gallicchio/OWLternatingCurrent/docs/images/art_base_bottom.png

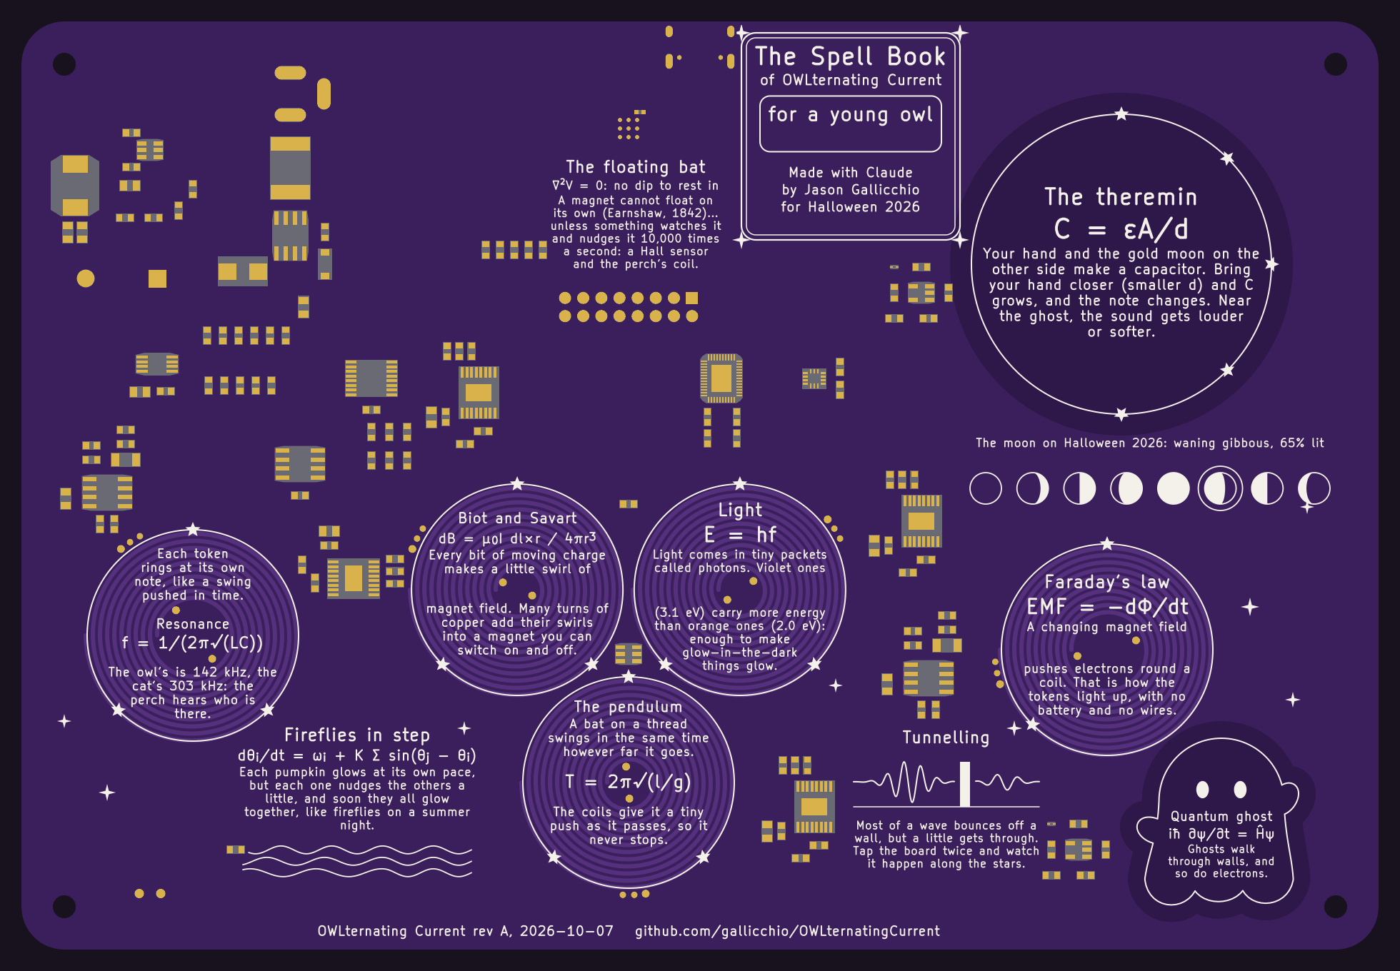
docs/images/art_base_bottom.png
