gallicchio/OWLternatingCurrent/docs/images/art_base_top.png

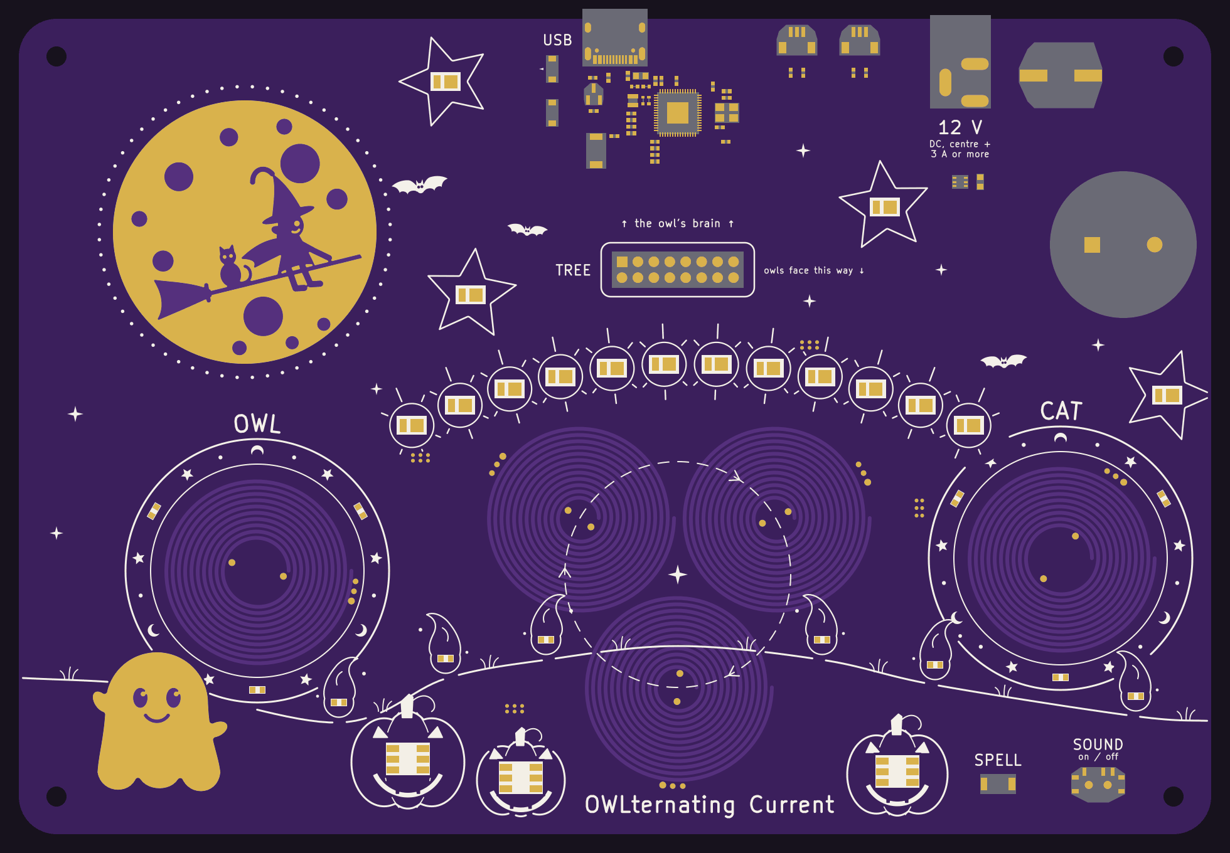
docs/images/art_base_top.png
