gallicchio/OWLternatingCurrent/docs/images/art_bat_bottom.png

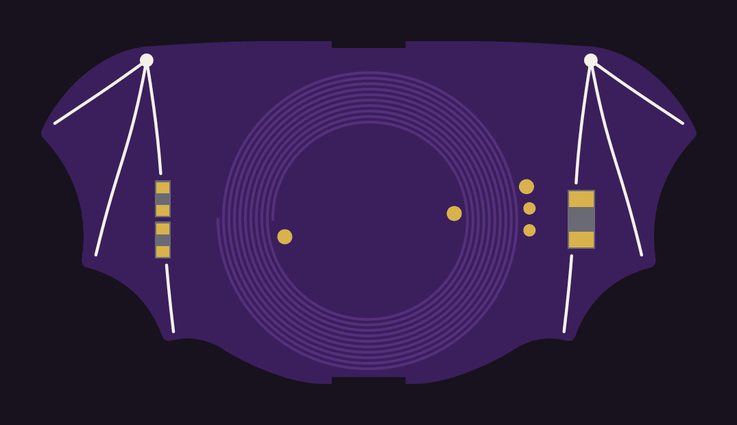
docs/images/art_bat_bottom.png
