gallicchio/OWLternatingCurrent/docs/images/art_bat_top.png

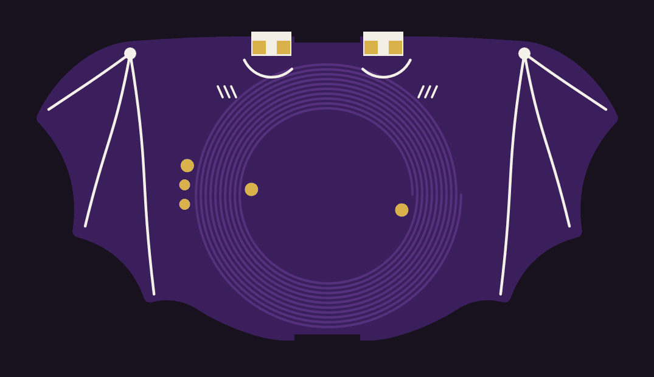
docs/images/art_bat_top.png
