gallicchio/OWLternatingCurrent/docs/images/art_cat_token_bottom.png

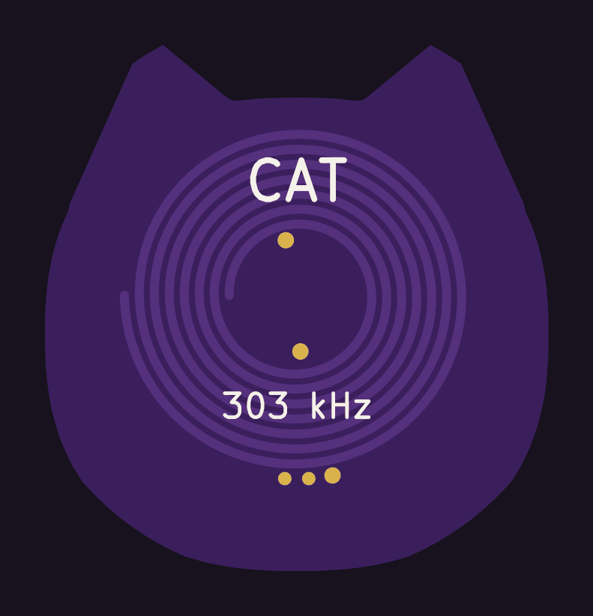
docs/images/art_cat_token_bottom.png
