gallicchio/OWLternatingCurrent/docs/images/art_cat_token_top.png

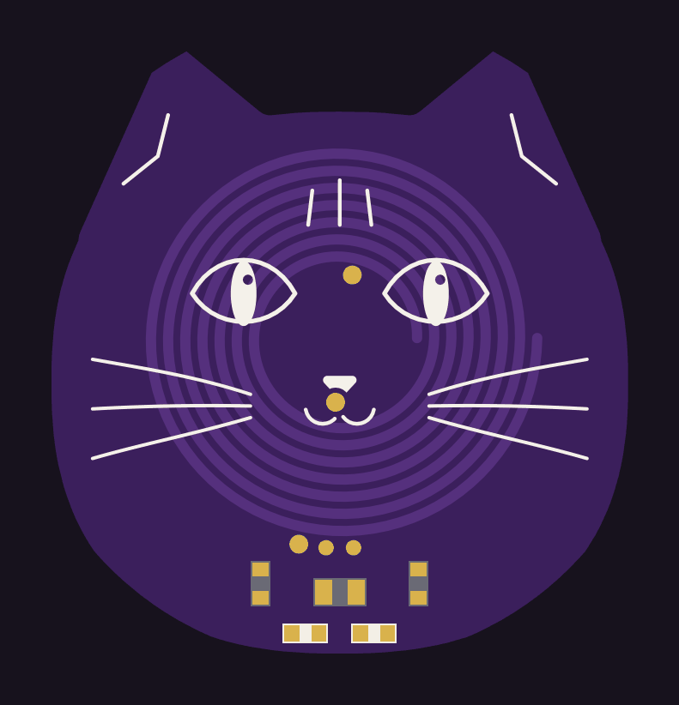
docs/images/art_cat_token_top.png
