gallicchio/OWLternatingCurrent/docs/images/art_owl_token_bottom.png

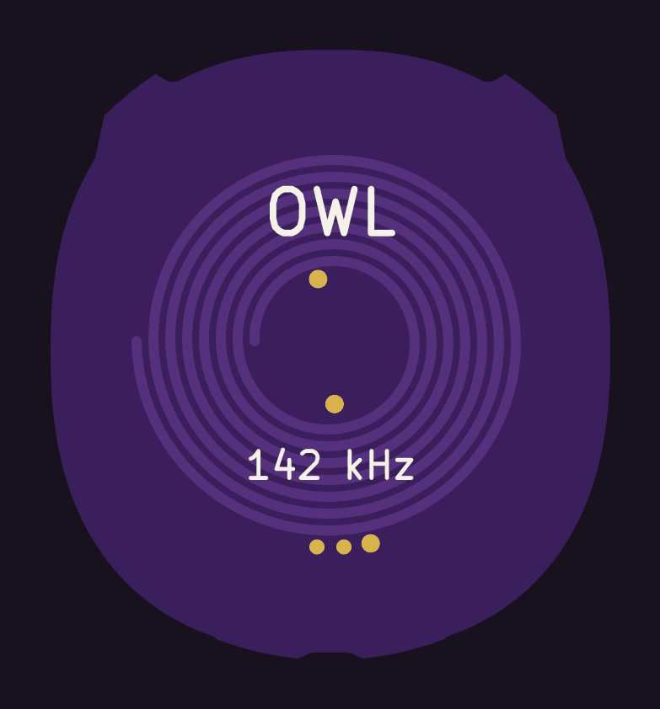
docs/images/art_owl_token_bottom.png
