gallicchio/OWLternatingCurrent/docs/images/art_owl_token_top.png

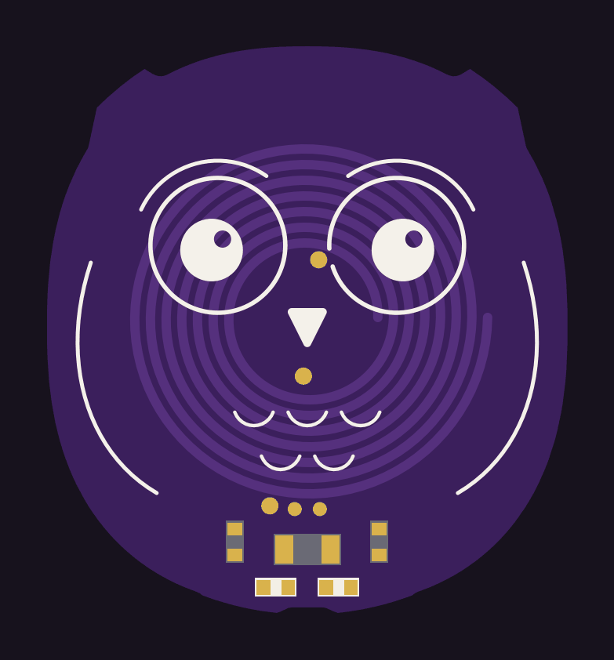
docs/images/art_owl_token_top.png
