gallicchio/OWLternatingCurrent/docs/images/art_perch_bottom.png

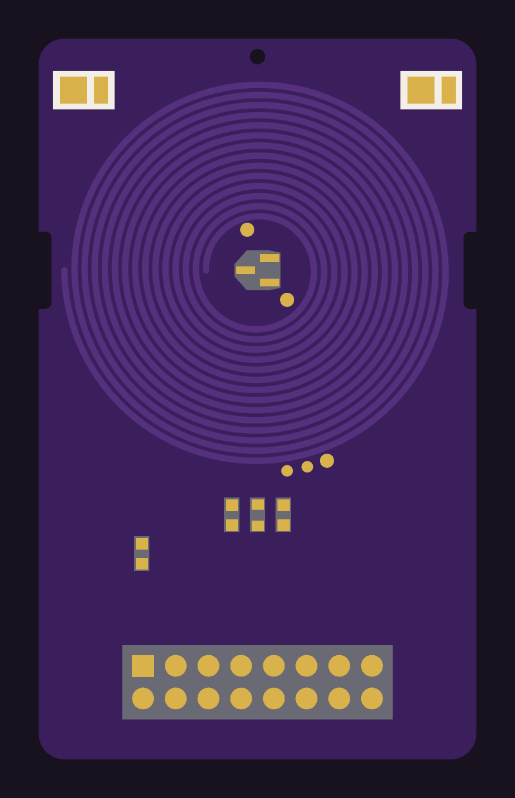
docs/images/art_perch_bottom.png
