gallicchio/OWLternatingCurrent/docs/images/art_perch_top.png

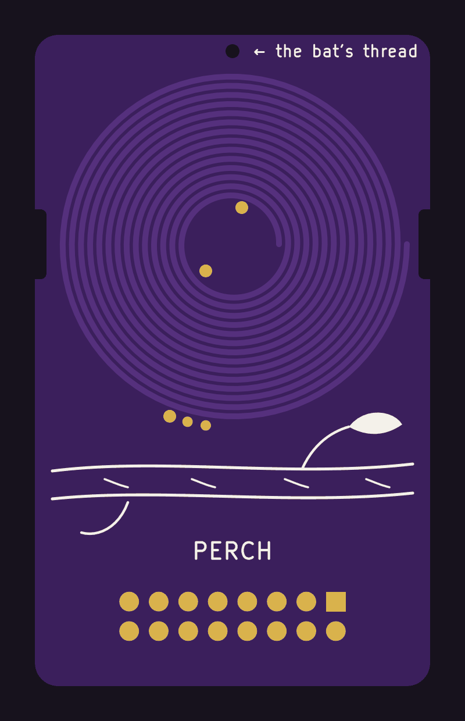
docs/images/art_perch_top.png
