gallicchio/OWLternatingCurrent/docs/images/art_tree_bottom.png

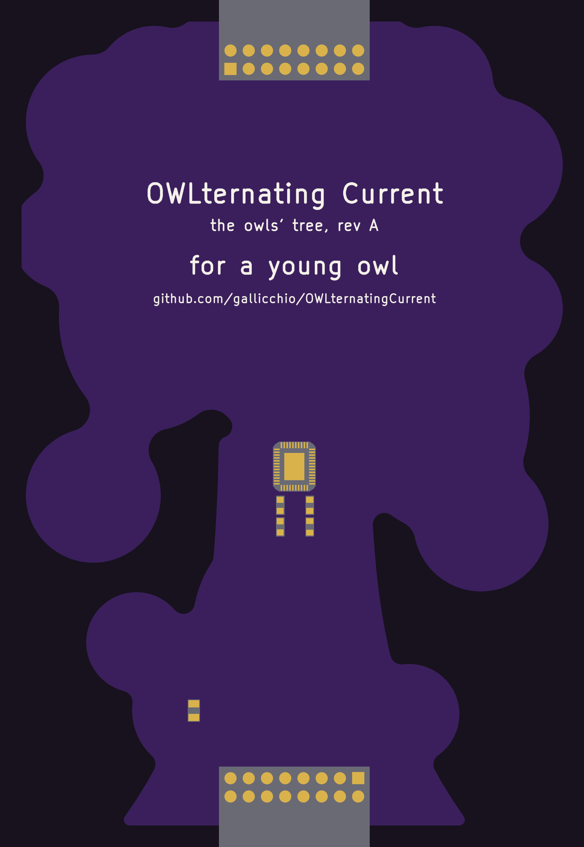
docs/images/art_tree_bottom.png
