gallicchio/OWLternatingCurrent/docs/images/art_tree_top.png

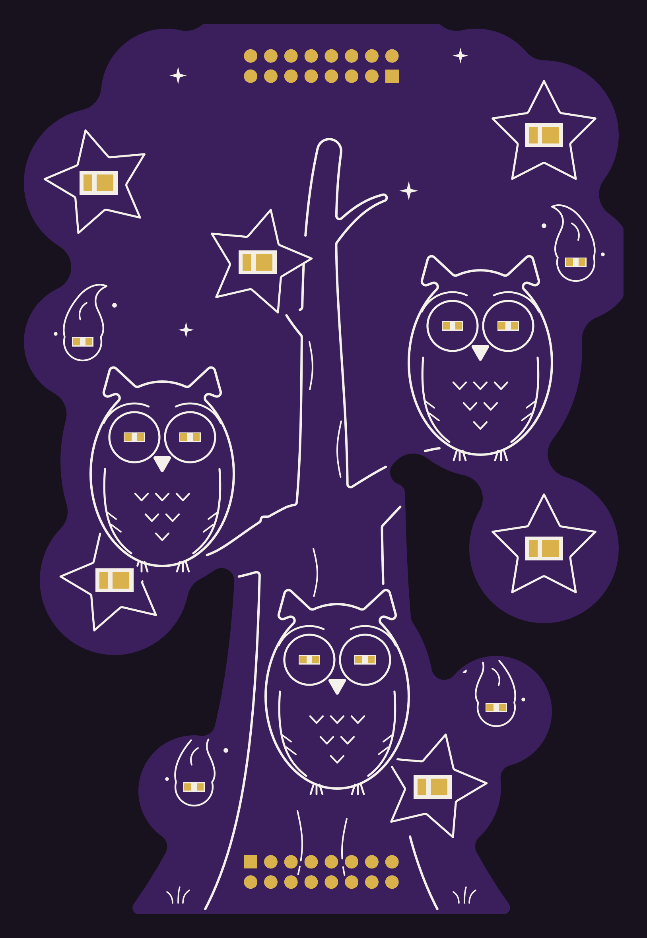
docs/images/art_tree_top.png
