gallicchio/OWLternatingCurrent/mfg/jlcpcb_order/SMT026100964723-13544840A+X-ray+Inspection+Report/13544840A-Y19/1.png

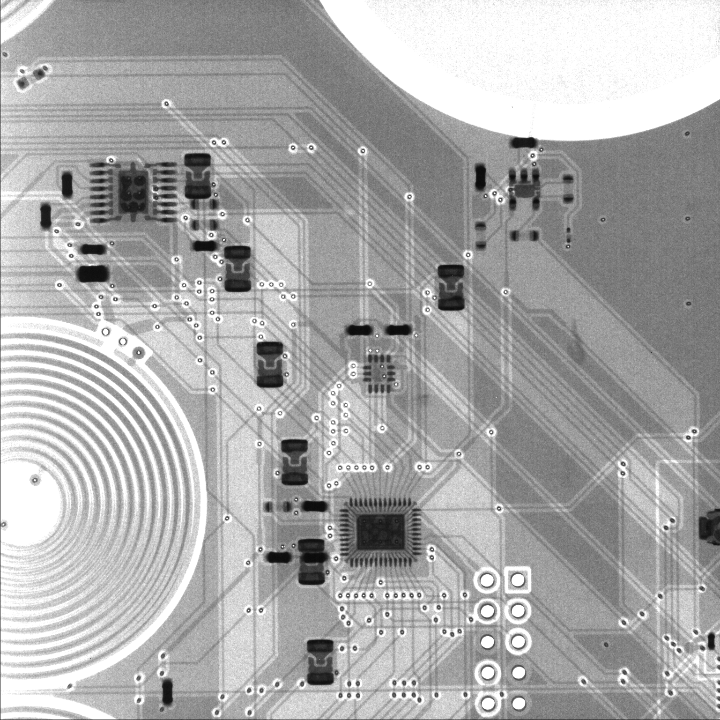
mfg/jlcpcb_order/SMT026100964723-13544840A+X-ray+Inspection+Report/13544840A-Y19/1.png
