gallicchio/OWLternatingCurrent/sim/antenna/figs/geom_bat_dipole.png

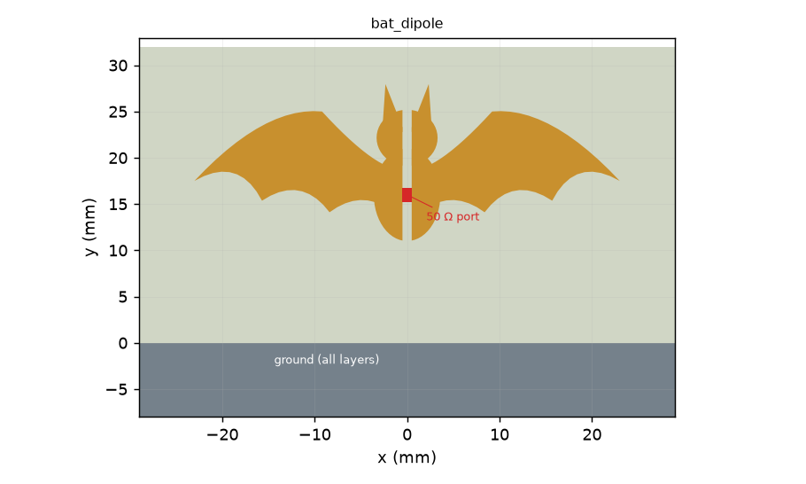
sim/antenna/figs/geom_bat_dipole.png
