gallicchio/OWLternatingCurrent/sim/antenna/figs/geom_bat_ifa.png

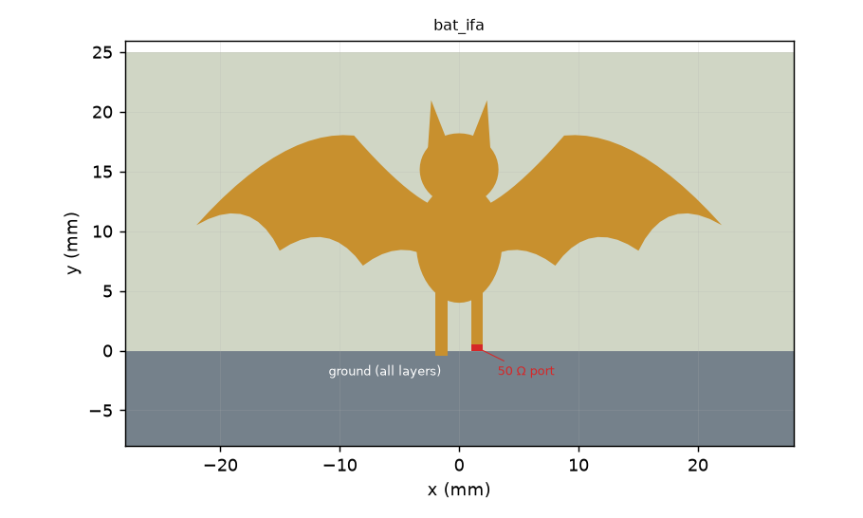
sim/antenna/figs/geom_bat_ifa.png
