gallicchio/OWLternatingCurrent/sim/antenna/figs/geom_bat_legfed.png

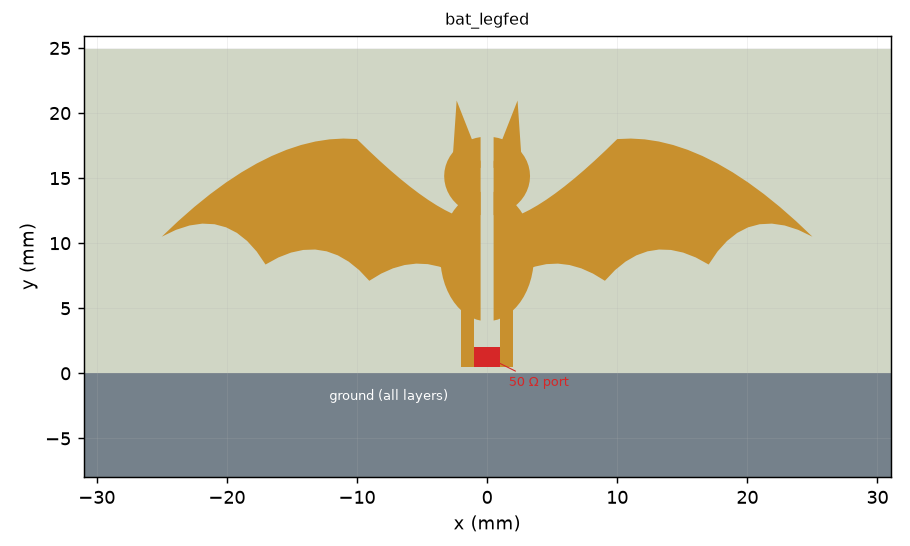
sim/antenna/figs/geom_bat_legfed.png
