gallicchio/OWLternatingCurrent/sim/antenna/figs/geom_bat_pm.png

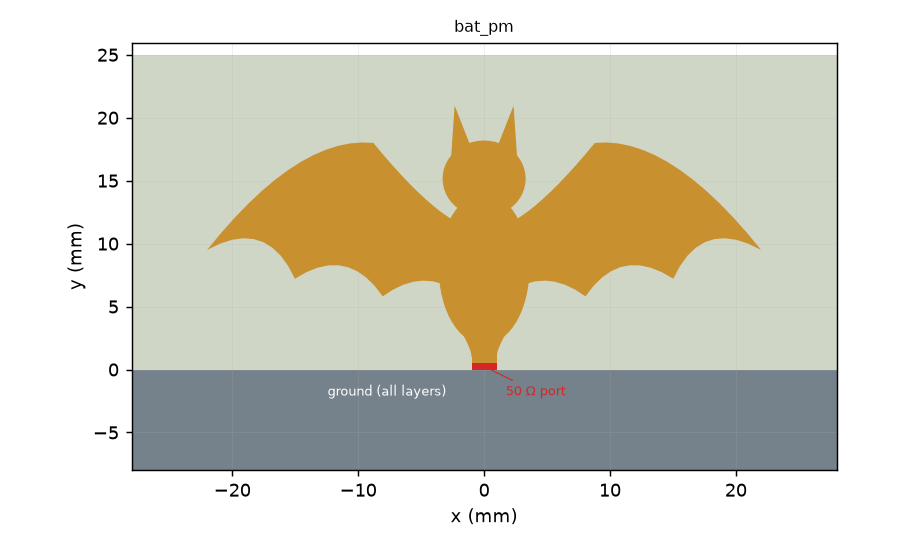
sim/antenna/figs/geom_bat_pm.png
