gallicchio/OWLternatingCurrent/sim/antenna/figs/geom_dn007.png

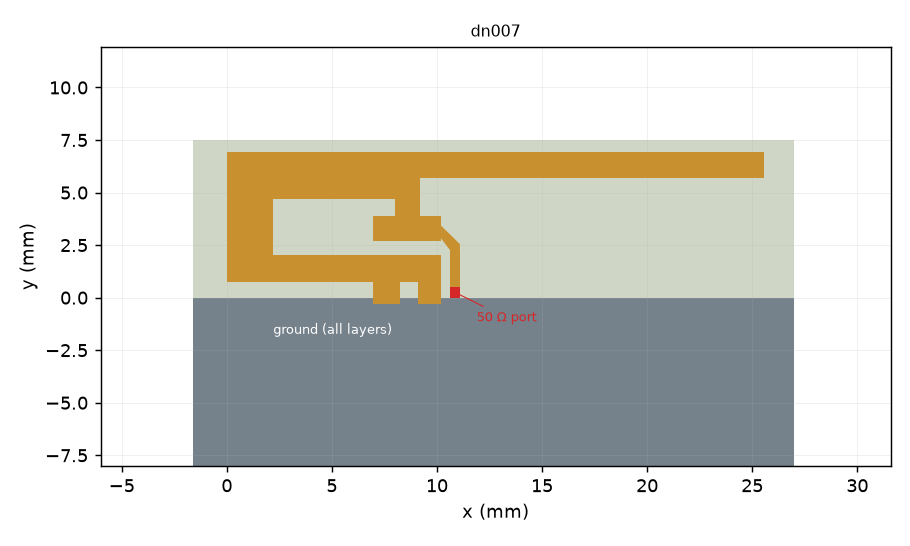
sim/antenna/figs/geom_dn007.png
