gallicchio/OWLternatingCurrent/sim/antenna/figs/pec_bat_ifa.png

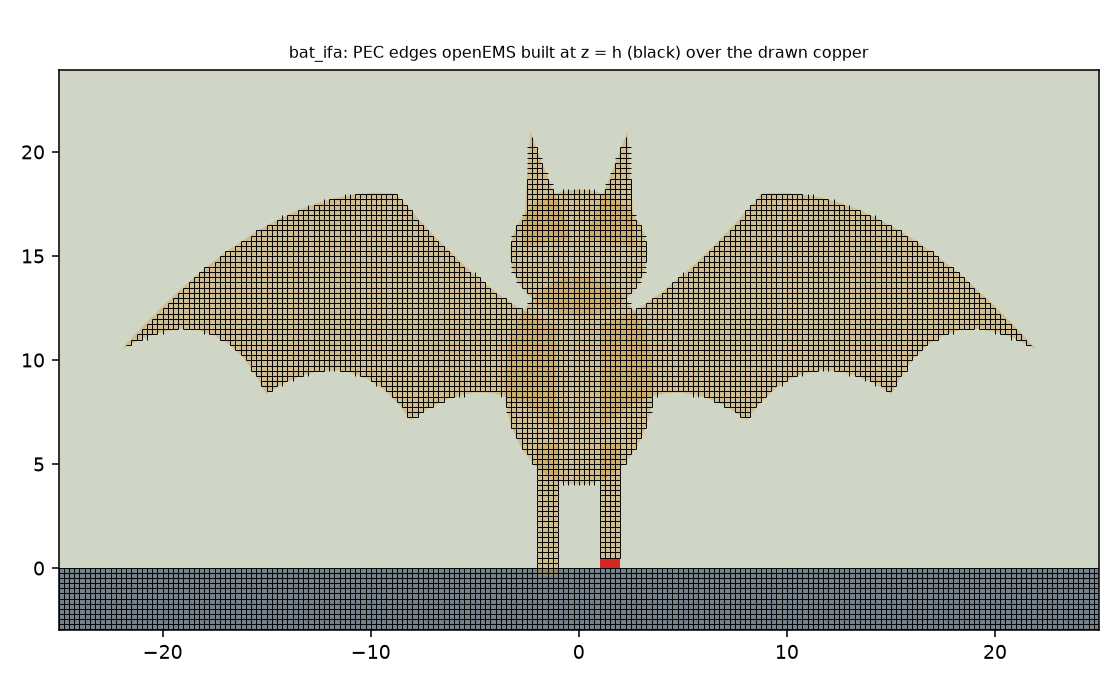
sim/antenna/figs/pec_bat_ifa.png
