gallicchio/OWLternatingCurrent/sim/antenna/figs/pec_bat_legfed.png

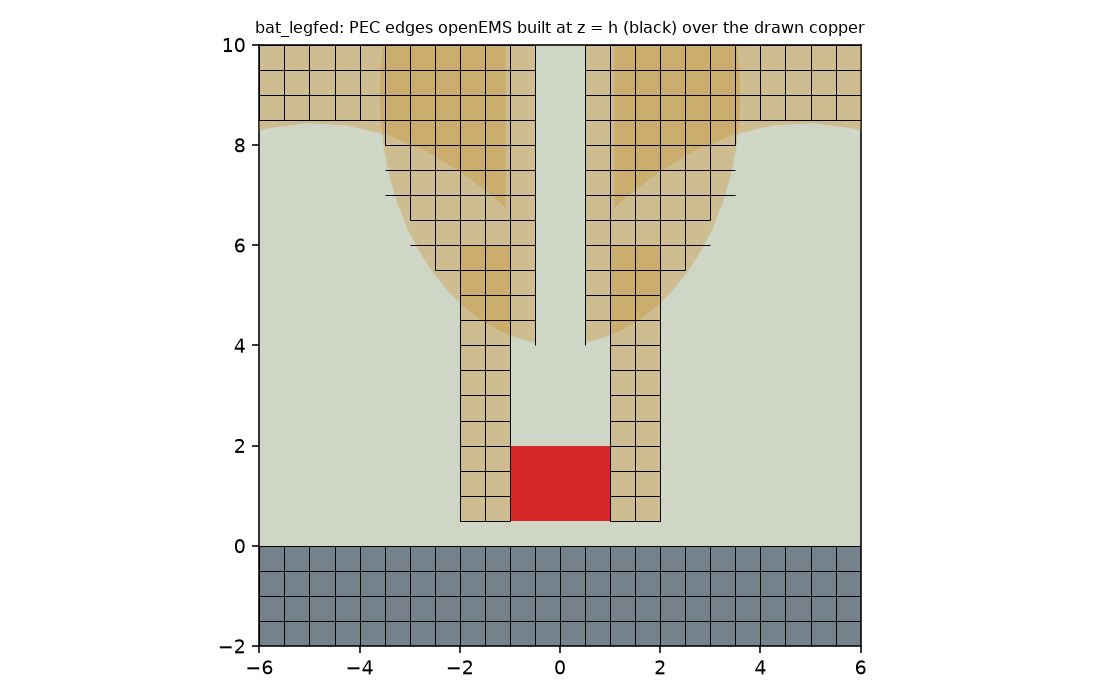
sim/antenna/figs/pec_bat_legfed.png
