gallicchio/OWLternatingCurrent/sim/antenna/figs/pec_dn007.png

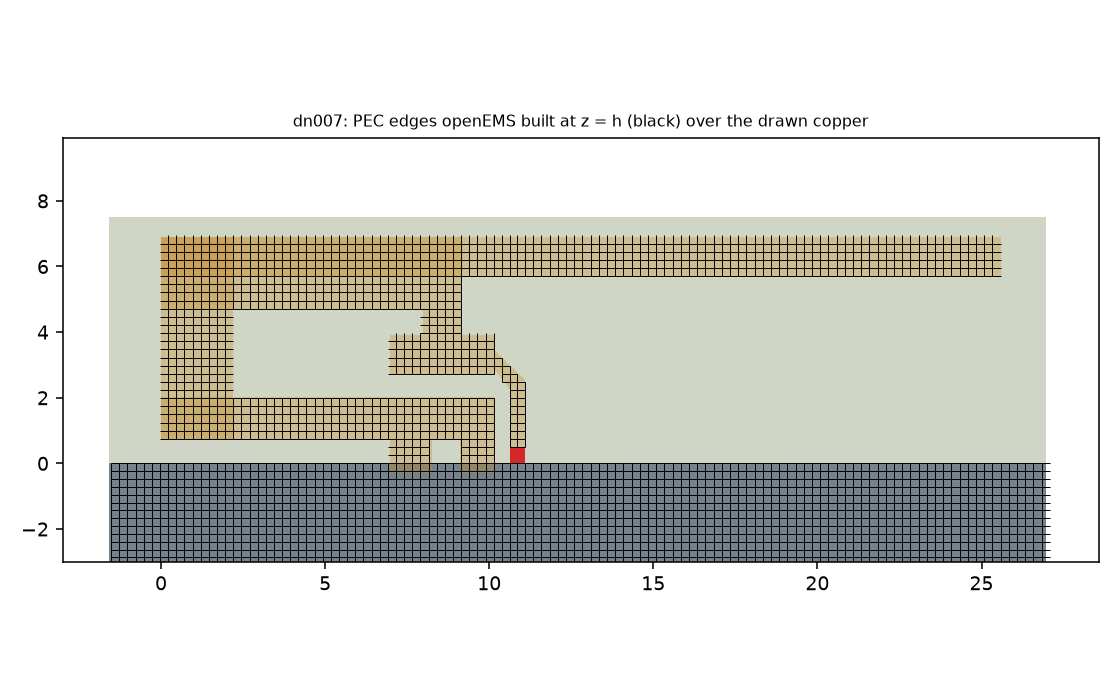
sim/antenna/figs/pec_dn007.png
