gallicchio/OWLternatingCurrent/sim/antenna/figs/pec_ghost.png

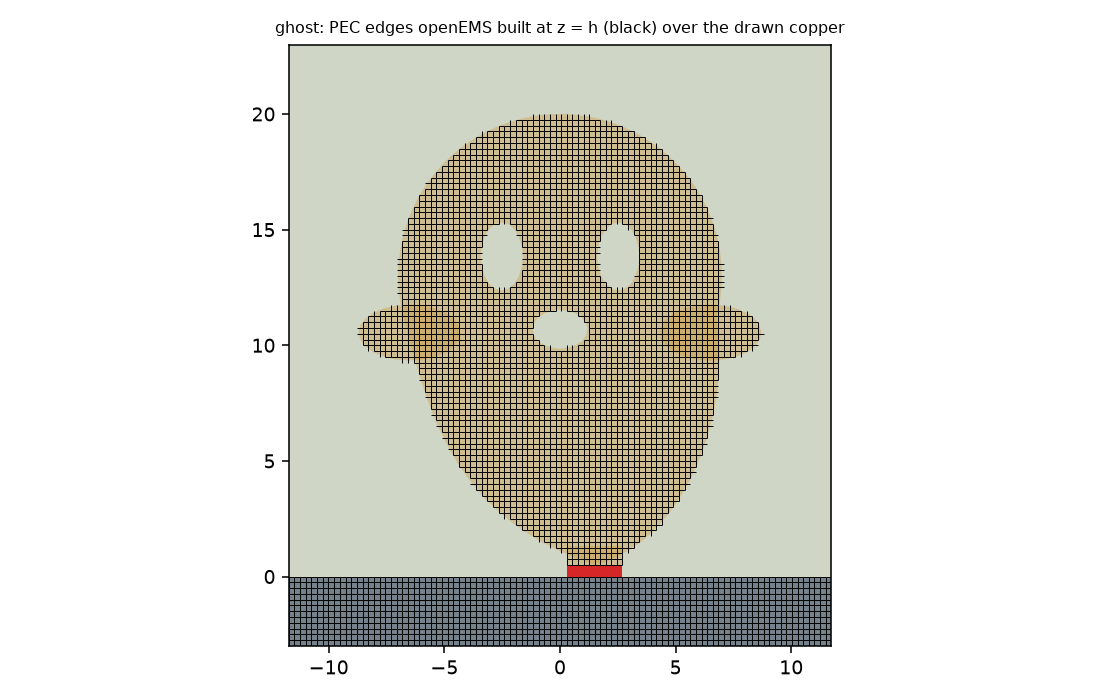
sim/antenna/figs/pec_ghost.png
