gallicchio/OWLternatingCurrent/mfg/release/COST_ESTIMATE.md

# OWLternating Current rev A: cost estimate

Written by `mfg/make_release.py` on 2026-10-09.  Parts: JLCPCB's live prices and stock (their parts API, asked at the times in the table).  Assembly fees: JLCPCB's published list (jlcpcb.com/help/article/pcb-assembly-price, updated 2026-09-09).  The bare panels: an estimate with a range.

**The order:** 5 bare panels of 245.2 x 223.2 mm (547 cm2; all 6 boards on each), 4 layers, 1.6 mm, purple, ENIG, 1 oz inner copper; **2 of them assembled, on both sides** (Standard PCBA).

| item | how | cost |
|---|---|--:|
| bare panels | ESTIMATE, $44-175: GPiBridge's cart (2026-10-06, 4 layers, ENIG: $24.80 for 5 boards of 60 x 25.5 mm) for the fixed part, plus 2736 cm2 at $70.6-350 per m2 (JLCPCB's published 4-layer board charge, and five times it for a small order), plus up to $6 for each of the 5 further designs and $25 for 1 oz inner copper (neither is published); purple costs the same as green (JLCPCB) | $109.31 |
| assembly setup | Standard PCBA, both sides | $51.12 |
| stencils | one for each side | $16.42 |
| feeder loading | 68 distinct parts (BOM lines) x $1.53: Standard PCBA loads a feeder for every part, Basic and Extended alike | $104.04 |
| SMD joints | 808 pads a panel x 2 panels x $0.0016 | $2.59 |
| through-hole | $3.58 labour an order + 25 joints a panel x 2 x $0.0164 | $4.40 |
| panel of 6 designs | JLCPCB's fee for a panel with more than one design | $8.21 |
| packing | $0.50 + $0.00003 per cm2 | $0.53 |
| parts | 245 placements a panel on 68 BOM lines, for 2 panels with JLCPCB's attrition, at the price break for that quantity | $59.36 |
| **total before shipping and duty** | | **$355.98** |
| an assembled panel | the total over 2 | $177.99 |

The range on the bare panels moves the total from $290.25 to $421.70.  US duty, collected by JLCPCB under DDP at 35 % of the PCBs and the assembly (their tariff FAQ, 2026-09-09), adds about $124.59; shipping (UPS Express Saver DDP to California) is shown at checkout.

## Per-part fees: Basic, Preferred, Extended

| library | distinct parts | placements a panel |
|---|--:|--:|
| Basic | 31 | 148 |
| Preferred | 2 | 2 |
| **Extended** | **35** | 95 |

On Standard PCBA every distinct part costs the same $1.53 to load, Basic or Extended (Preferred parts are exempt only on Economic): $104.04.  On Economic PCBA, which purple 4-layer boards cannot have, the 35 Extended parts alone would cost $107.45 and Basic and Preferred nothing.  4 part(s) sit on both sides (C1525, C15849, C97946, C516136); if JLCPCB loads them once a side, add $6.12.

The 35 distinct Extended parts: C138021 (RC0402FR-0727RL), C160389 (BM03B-SRSS-TB(LF)(SN)), C160472 (LTST-S270KFKT), C165948 (TYPE-C-31-M-12), C167223 (FXL0630-100-M), C173431 (BZT52C10), C1855818 (DRV8874PWPR), C189961 (NS4150B), C20625731 (ABM8-272-T3), C266123 (DRV5055A4QDBZR), C2841482 (AO4407A), C2897409 (PM254-2-08-Z-8.5), C2977527 (BSMD2920-300-24V), C311983 (TPS54302DDCR), C364577 (LTR-303ALS-01), C3715882 (TMAG5273A2QDBVR), C381116 (DC-005-5A-2.0), C38732 (OPA2333AIDR), C41378174 (RP2354A), C42411119 (AOTA-B201610S3R3-101-T), C431540 (MSK12C02), C46550472 (MA35V470M10X13), C465729 (UCC27524DR), C516136 (HL-A-3528S7VC-S1-13HL), C516304 (HL-AF-5060S22OC-3-S1-THL), C51933300 (GL0603PU01), C530531 (GSPK2307P-8R1W), C5645 (74HC4051PW,118), C701961 (LP5036RJVR), C77069 (GRM21B5C1H223JA01L), C7835 (SN74LVC1G14DBVR), C82326 (ESD9L5.0ST5G), C965800 (XL-1608UOC-06), C967633 (LSM6DS3TR-C), C97946 (GRM31C5C1H104JA01L).

## What to look at

- The bare panels are the least certain line ($43.58 to $175.04): read the price off JLCPCB's cart and put it in `PCB_QUOTE` in `mfg/make_release.py`
- Feeder loading is the largest assembly fee: $104.04 for 68 distinct parts.  Each part dropped or merged into another value saves $1.53
- **C42411119 AOTA-B201610S3R3-101-T** costs $9.06 for the order (32 x $0.28)
- **C1855818 DRV8874PWPR** costs $8.07 for the order (8 x $1.01)
- **C701961 LP5036RJVR** costs $5.09 for the order (4 x $1.27)
- **C967633 LSM6DS3TR-C** costs $3.03 for the order (2 x $1.52)
- **C516136 HL-A-3528S7VC-S1-13HL** costs $2.88 for the order (52 x $0.06)
- **C41378174 RP2354A** costs $2.55 for the order (2 x $1.28)
- Not in the total: baking the moisture-sensitive parts before assembly (JLCPCB recommends it for MSL 3 and up, as the LGA-14 accelerometer is; about $7.50), shipping, and duty

## Parts (68 BOM lines)

| LCSC | part | per panel | ordered | library | unit | line | stock | left after | asked |
|---|---|--:|--:|---|--:|--:|--:|--:|---|
| C42411119 | AOTA-B201610S3R3-101-T (3.3uH) | 1 | 32 | Extended | $0.2830 | $9.06 | 347 | 315 | 2026-10-08 21:05 |
| C1855818 | DRV8874PWPR (DRV8874) | 4 | 8 | Extended | $1.0082 | $8.07 | 27,586 | 27,578 | 2026-10-08 21:06 |
| C701961 | LP5036RJVR (LP5036) | 2 | 4 | Extended | $1.2733 | $5.09 | 16,757 | 16,753 | 2026-10-08 21:06 |
| C967633 | LSM6DS3TR-C (LSM6DS3TR-C) | 1 | 2 | Extended | $1.5156 | $3.03 | 27,676 | 27,674 | 2026-10-08 21:06 |
| C516136 | HL-A-3528S7VC-S1-13HL (violet) | 24 | 52 | Extended | $0.0553 | $2.88 | 68,094 | 68,042 | 2026-10-08 21:05 |
| C41378174 | RP2354A (RP2354A) | 1 | 2 | Extended | $1.2765 | $2.55 | 15,998 | 15,996 | 2026-10-08 21:06 |
| C15850 | CL21A106KAYNNNE (10u 25V) | 10 | 30 | Basic | $0.0687 | $2.06 | 4,577,372 | 4,577,342 | 2026-10-08 21:04 |
| C530531 | GSPK2307P-8R1W (8R 1W) | 1 | 2 | Extended | $0.9009 | $1.80 | 4,897 | 4,895 | 2026-10-08 21:05 |
| C38732 | OPA2333AIDR (OPA2333) | 1 | 2 | Extended | $0.7529 | $1.51 | 19,024 | 19,022 | 2026-10-08 21:06 |
| C465729 | UCC27524DR (UCC27524) | 2 | 4 | Extended | $0.3610 | $1.44 | 32,059 | 32,055 | 2026-10-08 21:06 |
| C266123 | DRV5055A4QDBZR (DRV5055A4) | 1 | 2 | Extended | $0.6944 | $1.39 | 8,734 | 8,732 | 2026-10-08 21:06 |
| C20625731 | ABM8-272-T3 (12MHz) | 1 | 2 | Extended | $0.6196 | $1.24 | 9,889 | 9,887 | 2026-10-08 21:06 |
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

"ordered" is what JLCPCB charges for: the placements on 2 panels plus its attrition (`lossNumber`) or minimum purchase, at the price break for that quantity.  A Preferred part is an Extended part JLCPCB keeps on its machines.
