gallicchio/OWLternatingCurrent/mfg/release/OWLternatingCurrent_bom.csv

Comment | Designator | Footprint | LCSC
100n | C4,C5,C35,C37,C40,C42,C43,C45,C47,C48,C52,C53,C57,C58,C62,C63,C66,C68,C70,C71,C73,C75,C102,C202 | C_0603_1608Metric | C14663
violet | D13,D15,D16,D17,D19,D20,D21,D22,D23,D24,D25,D26,D27,D29,D36,D37,D103,D107,D108,D109,D113,D115,D201,D202 | LED_Everlight-SMD3528_3.5x2.8mm_67-21ST | C516136
purple | D9,D10,D11,D12,D14,D18,D28,D30,D31,D33,D34,D35,D102,D106,D112,D114,D402,D502 | LED_0603_1608Metric | C51933300
100n | C13,C14,C15,C16,C17,C18,C19,C20,C21,C22,C23,C24 | C_0402_1005Metric | C1525
1k | R17,R18,R19,R26,R29,R36,R38,R40,R42,R53,R57,R201 | R_0603_1608Metric | C21190
1u | C33,C34,C39,C41,C44,C67,C72,C101,C103,C203 | C_0603_1608Metric | C15849
10u 25V | C2,C3,C32,C49,C54,C59,C64,C69,C74,C104 | C_0805_2012Metric | C15850
100k | R1,R2,R22,R25,R28,R47,R52,R56 | R_0603_1608Metric | C25803
10k | R23,R34,R43,R44,R45,R46,R51,R55 | R_0603_1608Metric | C25804
orange | D101,D104,D105,D110,D111,D116,D401,D501 | LED_0603_1608Metric | C965800
10n | C29,C30,C50,C55,C60,C65,C201 | C_0603_1608Metric | C57112
22n | C28,C31,C46,C51,C56,C61 | C_0603_1608Metric | C21122
2.2k | R30,R31,R35,R37,R39,R41 | R_0603_1608Metric | C4190
DRV8874 | U5,U6,U7,U8 | HTSSOP-16-1EP_4.4x5mm_P0.65mm_EP3.55x2.46mm_TI_PWP0016J | C1855818
150 | R401,R402,R501,R502 | R_0603_1608Metric | C22808
33 | R24,R27,R301,R302 | R_0603_1608Metric | C23140
100 | R12,R13,R15,R16 | R_0402_1005Metric | C25076
4.7u | C10,C11,C12 | C_0402_RPi | C23733
orange x3 | D7,D8,D32 | LED_RGB_5050-6 | C516304
1k | R11,R14 | R_0402_1005Metric | C11702
27 | R7,R8 | R_0402_1005Metric | C138021
15p | C26,C27 | C_0402_1005Metric | C1548
SWD/UART | J4,J5 | JST_SH_BM03B-SRSS-TB_1x03-1MP_P1.00mm_Vertical | C160389
orange | D301,D302 | LED_LiteOn_LTST-S270_SideView | C160472
15p | C36,C38 | C_0603_1608Metric | C1644
220k | R20,R21 | R_0603_1608Metric | C22961
3.3k | R32,R101 | R_0603_1608Metric | C22978
4.7k | R33,R49 | R_0603_1608Metric | C23162
0.1 | R50,R54 | R_1206_3216Metric | C25334
5.1k | R9,R10 | R_0402_1005Metric | C25905
22k | R3,R48 | R_0603_1608Metric | C31850
22u 25V | C6,C7 | C_0805_2012Metric | C45783
UCC27524 | U9,U10 | SOIC-8_3.9x4.9mm_P1.27mm | C465729
1u | C8,C9 | C_0402_1005Metric | C52923
LP5036 | U3,U101 | VQFN-46-1EP_5x6mm_P0.4mm_EP2.8x3.8mm | C701961
BOOT/SPELL | SW1,SW2 | SW_SPST_TS-1088-xR020 | C720477
74LVC1G14 | U12,U13 | SOT-23-5 | C7835
ESD 0.9pF | D5,D6 | D_SOD-923 | C82326
B5819W | D3,D4 | D_SOD-123 | C8598
100n C0G | C301,C401 | C_1206_3216Metric | C97946
USB-C | J2 | USB_C_Receptacle_HRO_TYPE-C-31-M-12 | C165948
10uH | L1 | L_Changjiang_FXL0630 | C167223
BZT52C10 | D1 | D_SOD-123 | C173431
NS4150B | U14 | MSOP-8_3x3mm_P0.65mm | C189961
SMBJ15A | D2 | D_SMB | C19077569
10u | C25 | C_0603_1608Metric | C19702
12MHz | Y1 | Crystal_SMD_3225-4Pin_3.2x2.5mm | C20625731
36k | R4 | R_0603_1608Metric | C23147
5.1k | R5 | R_0603_1608Metric | C23186
33 | R6 | R_0402_RPi | C25105
DRV5055A4 | U201 | SOT-23 | C266123
AO4407A | Q1 | SOIC-8_3.9x4.9mm_P1.27mm | C2841482
TREE | J3 | PinSocket_2x08_P2.54mm_Vertical | C2897409
3A PTC | F1 | Fuse_2920_7451Metric | C2977527
TPS54302 | U1 | SOT-23-6 | C311983
LTR-303ALS | U16 | Lite-On_LTR-303ALS-01 | C364577
TMAG5273A2 | U17 | SOT-23-6 | C3715882
12V DC | J1 | BarrelJack_XKB_DC-005-5A-2.0_Horizontal | C381116
OPA2333 | U18 | SOIC-8_3.9x4.9mm_P1.27mm | C38732
RP2354A | U4 | RP2350A_QFN-60_7x7mm_P0.4mm_RPi | C41378174
3.3uH | L2 | L_Abracon_AOTA-B201610_RPi | C42411119
SOUND | SW3 | SW_SPDT_Shouhan_MSK12C02 | C431540
470u 35V | C1 | CP_Elec_10x12.6 | C46550472
8R 1W | LS1 | Speaker_GSPK2307P_D23mm_P10mm | C530531
XC6206 3.3V | U2 | SOT-23 | C5446
74HC4051 | U11 | TSSOP-16_4.4x5mm_P0.65mm | C5645
22n C0G | C501 | C_0805_2012Metric | C77069
LSM6DS3TR-C | U15 | Bosch_LGA-14_3x2.5mm_P0.5mm | C967633
