gallicchio/OWLternatingCurrent/mfg/jlcpcb_order/2026-10-23_question_about_LS1.png

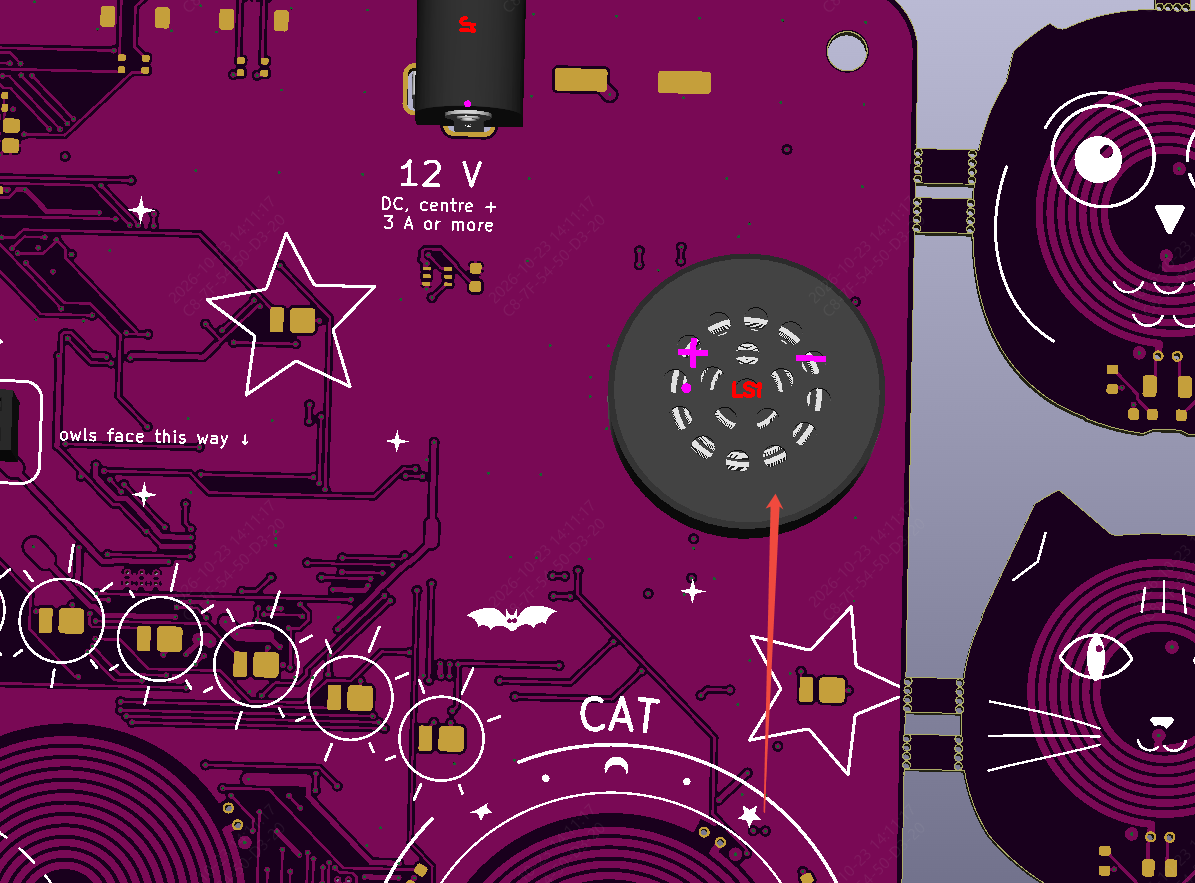
mfg/jlcpcb_order/2026-10-23_question_about_LS1.png
