gallicchio/OWLternatingCurrent/mfg/jlcpcb_order/8801425903117524992-Produce_DanZhi.SMT_Snapshot.Top.13544840A_Y19.SMT026100964723.png

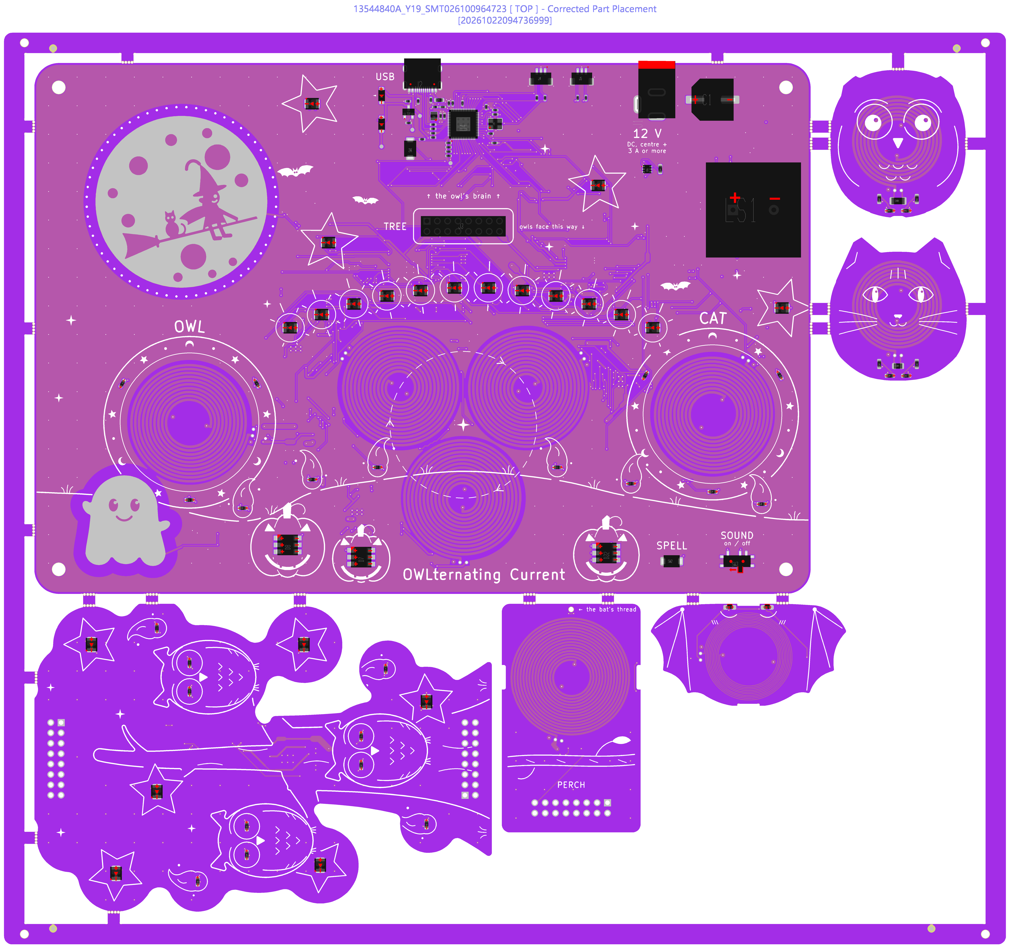
mfg/jlcpcb_order/8801425903117524992-Produce_DanZhi.SMT_Snapshot.Top.13544840A_Y19.SMT026100964723.png
