gallicchio/OWLternatingCurrent/mfg/jlcpcb_order/8801425905845313536-Produce_DanZhi.SMT_Snapshot.Bottom.13544840A_Y19.SMT026100964723.png

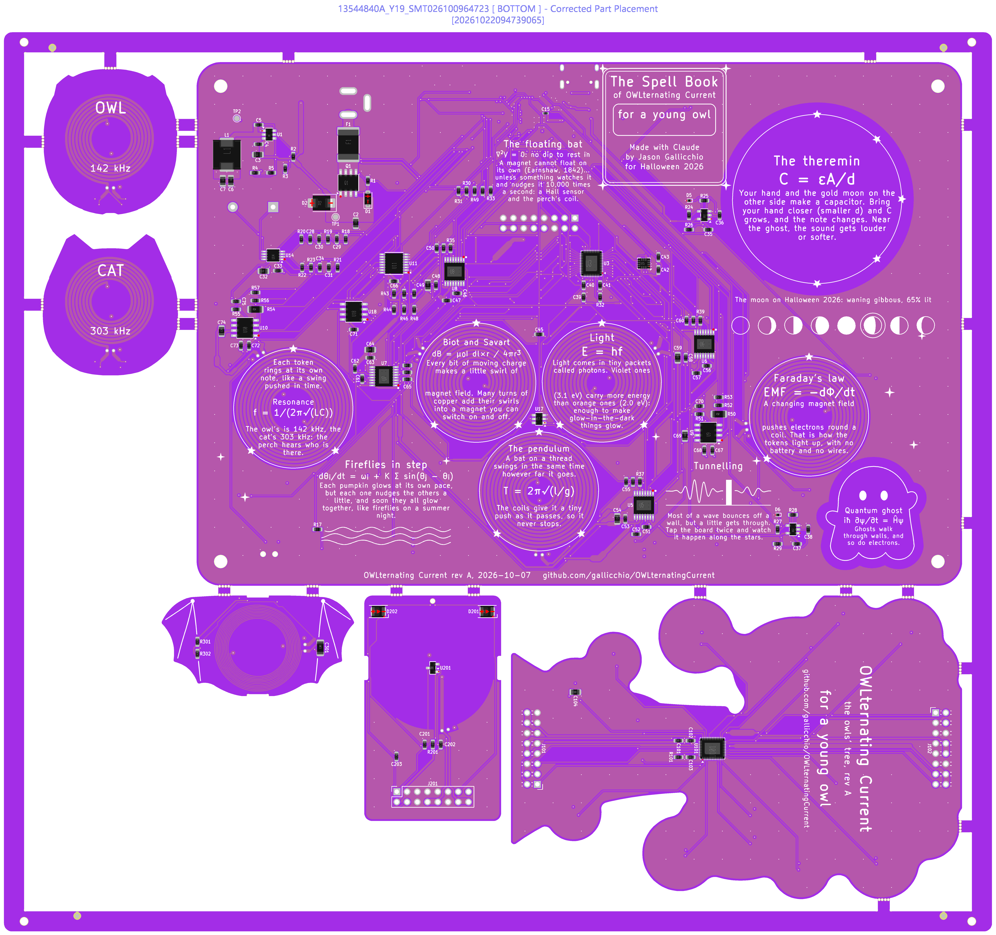
mfg/jlcpcb_order/8801425905845313536-Produce_DanZhi.SMT_Snapshot.Bottom.13544840A_Y19.SMT026100964723.png
