gallicchio/OWLternatingCurrent/mfg/jlcpcb_order/potos_revA_2026-11-06/20261106_082548.jpg

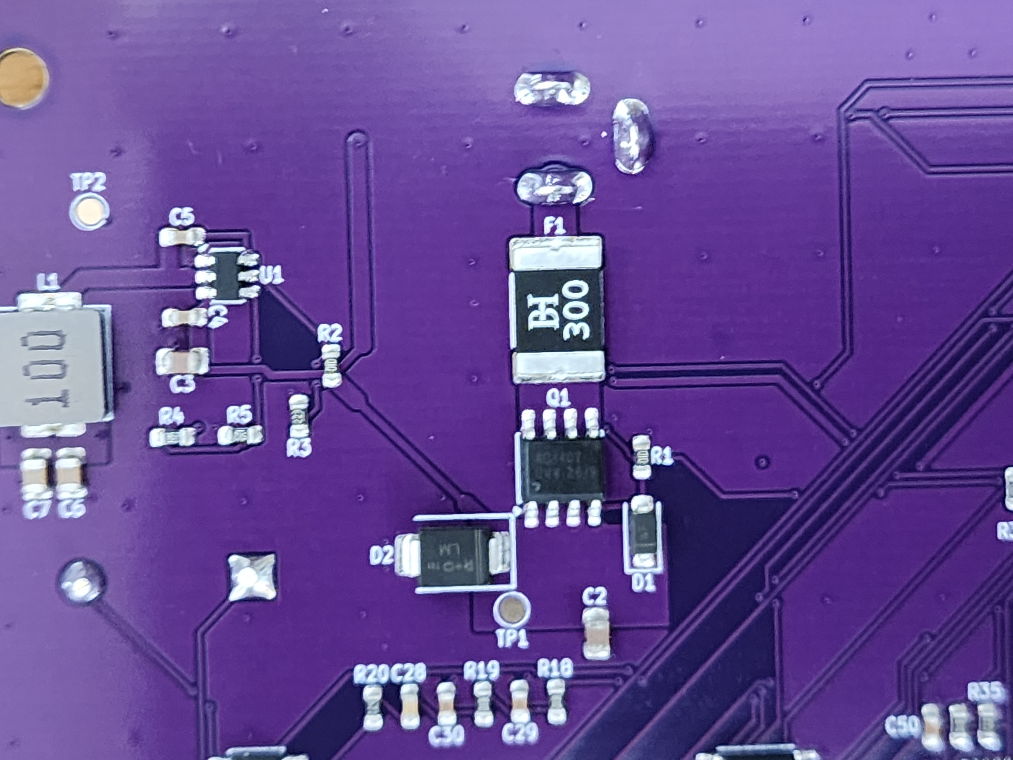
mfg/jlcpcb_order/potos_revA_2026-11-06/20261106_082548.jpg
