gallicchio/OWLternatingCurrent/gen/models/QFN-60-1EP_7x7mm_P0.4mm.step

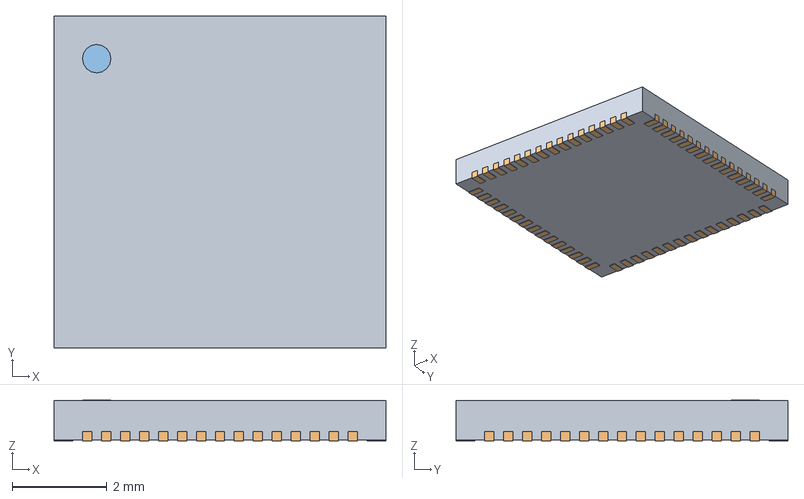
[picture p86: CAD file, 2026-10-07]
gen/models/QFN-60-1EP_7x7mm_P0.4mm.step
7.00 x 7.00 x 0.86 mm
