gallicchio/OWLternatingCurrent/print/out/assembled/owl_in_perch_frame.stl

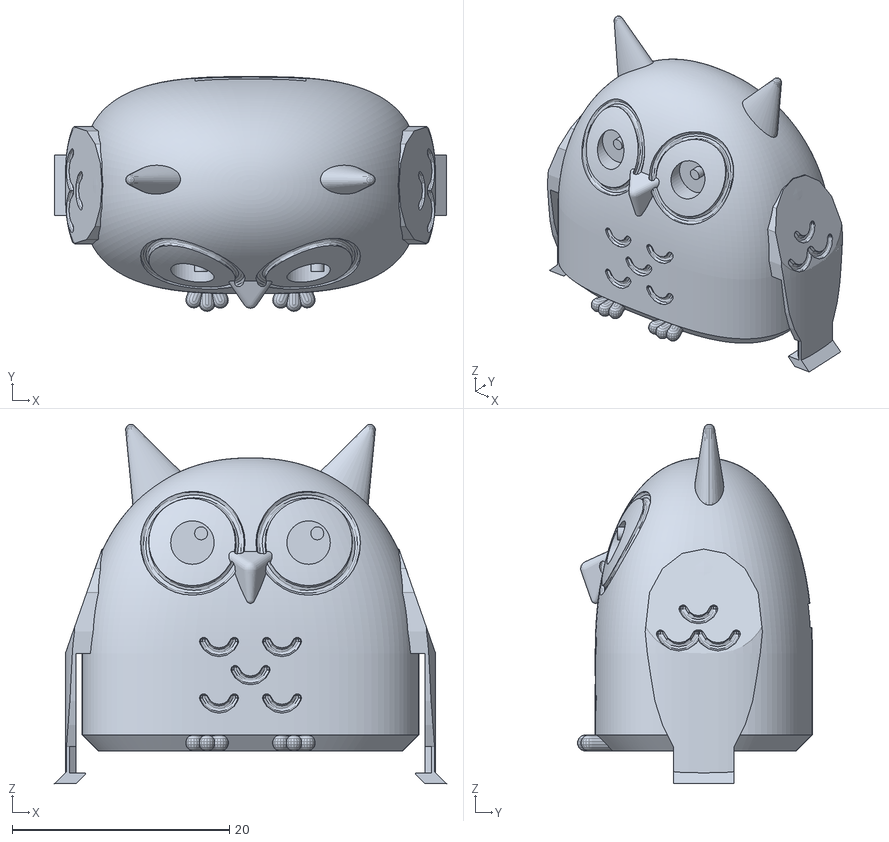
[picture p87: CAD file, 2026-11-11]
print/out/assembled/owl_in_perch_frame.stl
36.1 x 21.6 x 33.1
