gallicchio/OWLternatingCurrent/print/out/bat_cap.stl

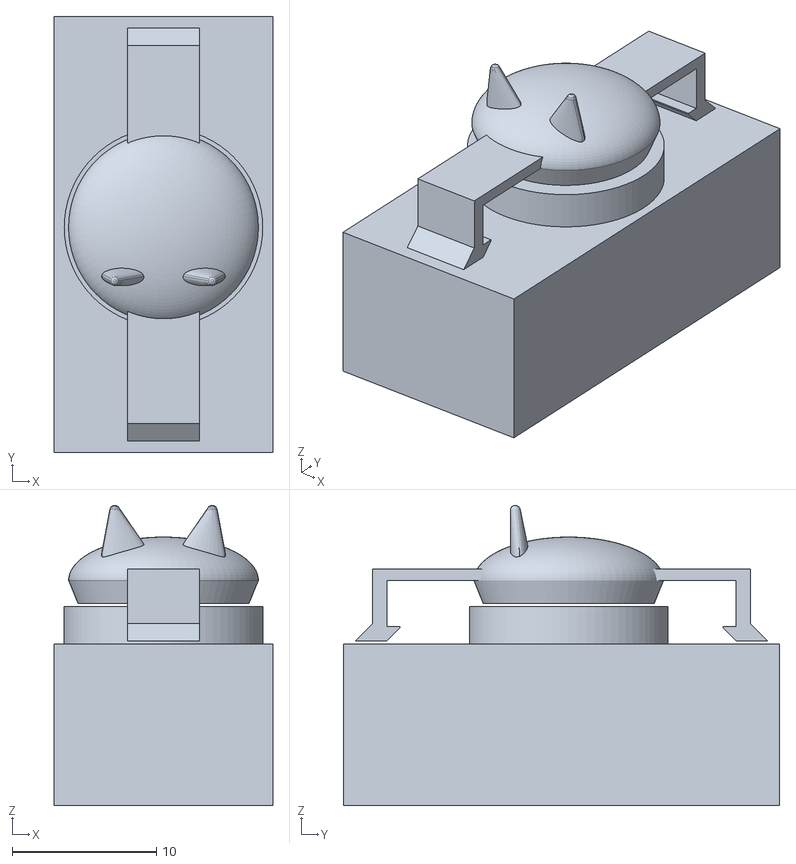
[picture p88: CAD file, 2026-11-11]
print/out/bat_cap.stl
15.1 x 30.2 x 20.8
