gallicchio/OWLternatingCurrent/gen/models/L_Abracon_AOTA-B201610.step

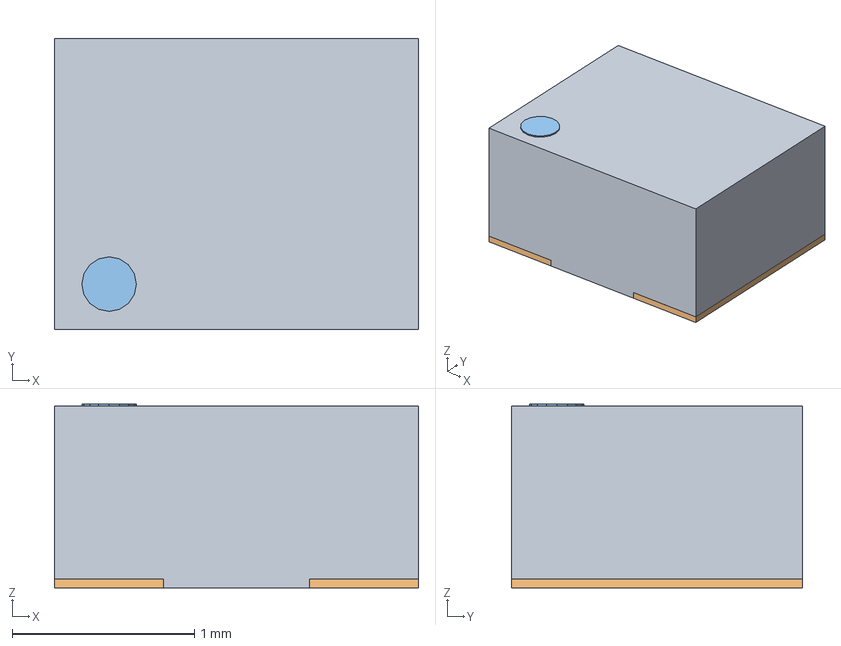
[picture p89: CAD file, 2026-10-07]
gen/models/L_Abracon_AOTA-B201610.step
2.00 x 1.60 x 1.01 mm
