gallicchio/OWLternatingCurrent/print/out/assembled/bat_cap_in_bat_frame.stl

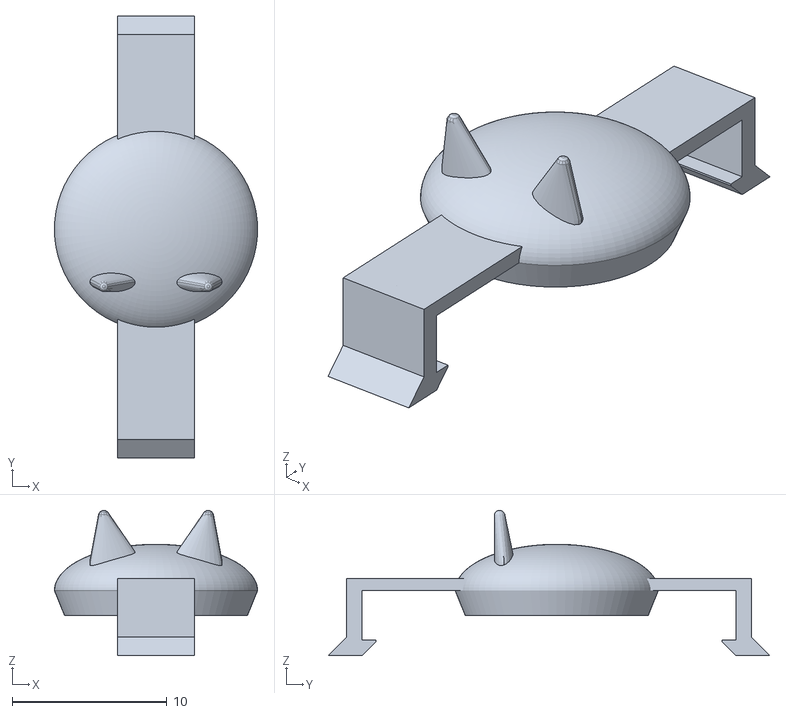
[picture p90: CAD file, 2026-11-10]
print/out/assembled/bat_cap_in_bat_frame.stl
13.1 x 28.6 x 9.39
