gallicchio/OWLternatingCurrent/print/out/owl.stl

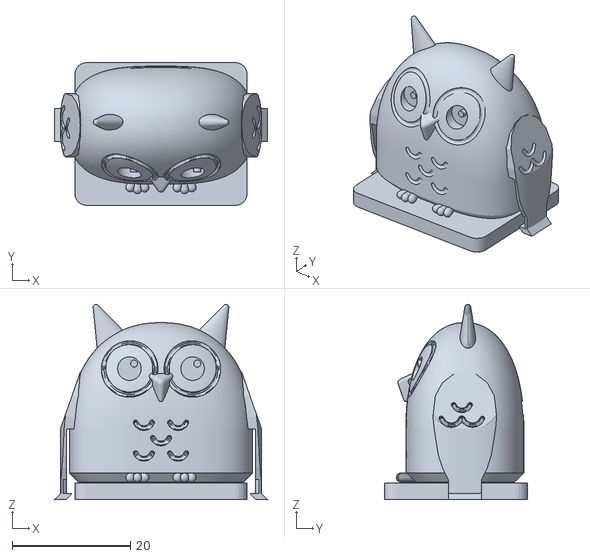
[picture p91: CAD file, 2026-11-11]
print/out/owl.stl
36.1 x 24.2 x 33.1
