gallicchio/OWLternatingCurrent/gen/models/USB_C_Receptacle_HRO_TYPE-C-31-M-12.step

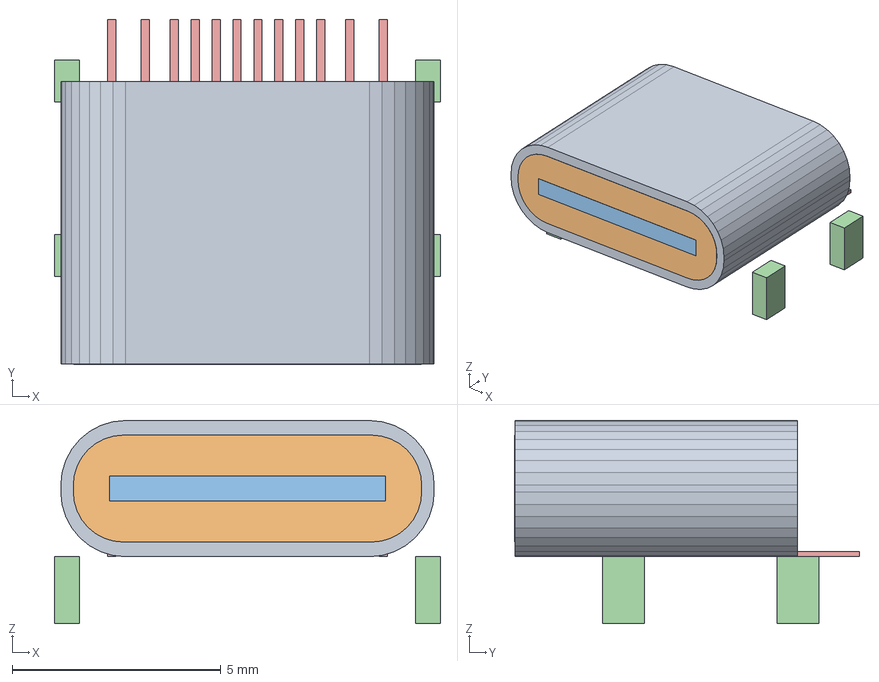
[picture p92: CAD file, 2026-10-07]
gen/models/USB_C_Receptacle_HRO_TYPE-C-31-M-12.step
9.24 x 8.26 x 4.86 mm
