gallicchio/OWLternatingCurrent/print/out/plate.stl

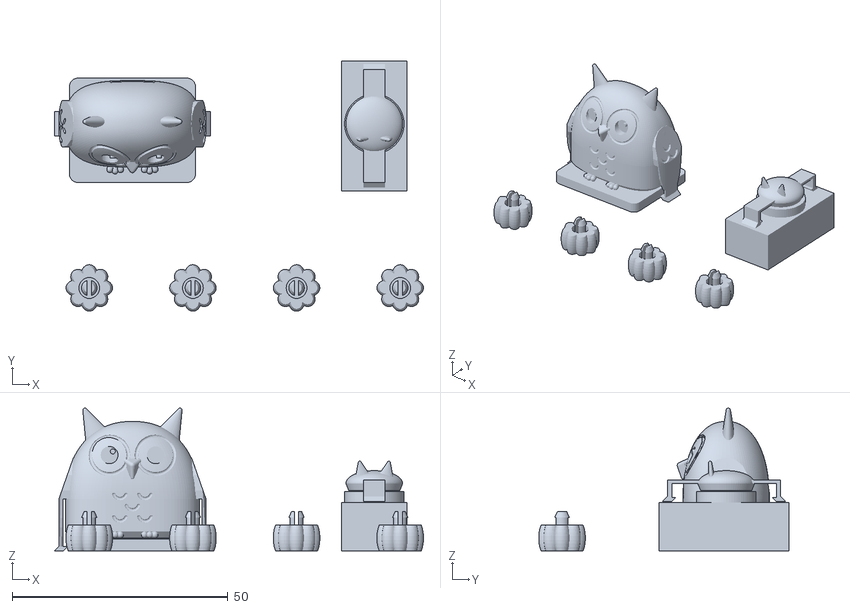
[picture p93: CAD file, 2026-11-11]
print/out/plate.stl
85.4 x 58.0 x 33.1
