gallicchio/OWLternatingCurrent/print/out/foot.stl

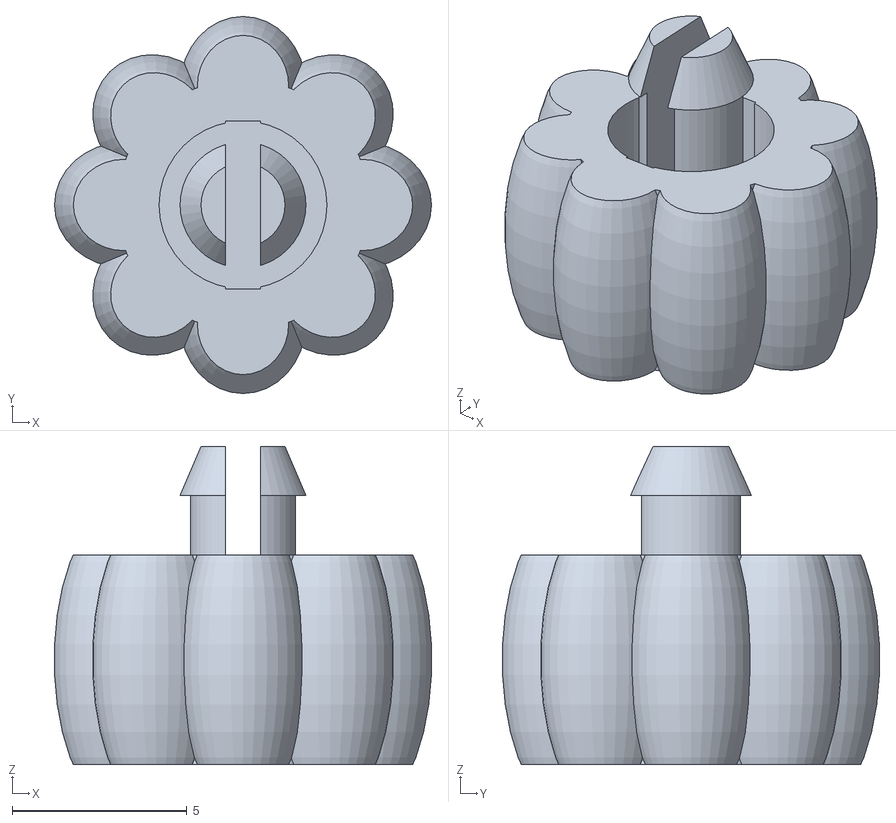
[picture p94: CAD file, 2026-10-07]
print/out/foot.stl
10.8 x 10.8 x 9.10
