gallicchio/OWLternatingCurrent/print/out/params.scad

// Generated by print/build.py from gen/mech.py and print/design.py: do not edit.
// gen/mech.py (prefix M_):
M_BAT_HEAD_Y = -12.5;
M_BAT_NOTCH_D = 0.5;
M_BAT_NOTCH_W = 5.4;
M_BAT_SPAN = 48;
M_BAT_TAIL_Y = 11.5;
M_CAP_ARM_W = 5;
M_CAP_HOOK = 0.8;
M_COIL_R_IN = 4;
M_COIL_R_OUT = 15;
M_COIL_TURNS = 14;
M_COPPER_TO_SURFACE = 0.05;
M_FOOT_HEIGHT = 6;
M_FOOT_HOLE_D = 3.2;
M_FOOT_INSET = 6;
M_MAGNET_D = 10;
M_MAGNET_T = 2;
M_OWL_HOOK = 0.8;
M_OWL_KEEPOUT = 2;
M_OWL_LIFT = 11.4;
M_OWL_NOTCH_D = 1;
M_OWL_NOTCH_Y = [-3,3];
M_PCB_T = 1.6;
M_PERCH_BACK = 38;
M_PERCH_FRONT = -18;
M_PERCH_W = 34;
M_POCKET_D = 10.35;
M_POCKET_T = 2.25;
M_RX_R_IN = 7;
M_RX_R_OUT = 11;
M_THREAD_HOLE = [0,-16.6];
M_THREAD_HOLE_D = 1.2;
// print/design.py:
BED = [180,180];
CAP_ARM_RAISE = 1.6;
CAP_ARM_T = 0.8;
CAP_DOME_P = 2;
CAP_DOME_R = 6.575;
CAP_DOME_R0 = 5.925;
CAP_DOME_TOP = 4.6;
CAP_DOME_Z1 = 1.6;
CAP_DROP_CLEAR = 0.1;
CAP_DROP_T = 1;
CAP_FLOOR_T = 0.4;
CAP_FOOT = 1.2;
CAP_HEAD_DROP_IN = -12.6;
CAP_HEAD_LIP_TIP = -11.7;
CAP_HOOK_T = 1;
CAP_LEADIN_LAND = 0.1;
CAP_OPEN_DEPTH = 2.6;
CAP_PED_HALF_X = 7.575;
CAP_PLATEAU_TOP = 13.8;
CAP_PLATFORM_TOP = 11.2;
CAP_SLOT = 1.6;
CAP_TAIL_DROP_IN = 11.6;
CAP_TAIL_LIP_TIP = 10.7;
CAP_Z0 = 14;
CAP_Z_BOTTOM = -2.6;
CAP_Z_CATCH = -1.6;
FOOT_BARB_D = 3.6;
FOOT_BARB_H = 1.4;
FOOT_BARB_TOP_D = 2.4;
FOOT_CATCH_Z = 7.7;
FOOT_CORE_R = 3.6;
FOOT_LOBES = 8;
FOOT_LOBE_R = 2;
FOOT_LOBE_RZ = 4.4;
FOOT_MOAT_DEPTH = 3.5;
FOOT_MOAT_R = 2.4;
FOOT_PEG_D = 3;
FOOT_R = 5.4;
FOOT_SLOT = 1;
GAP_XY = 0.4;
GAP_Z = 0.2;
LAYER = 0.2;
NOZZLE = 0.4;
OPEN_GAP_T = 2.2;
OPEN_KEY_D = 0.8;
OPEN_KEY_W = 1.2;
OPEN_KEY_Y = 7.4;
OPEN_SLOT_END = 11;
OPEN_SLOT_W = 10.25;
OWL_A = 15.5;
OWL_ARM_CHAMFER = 0.6;
OWL_ARM_CLEAR = 0.05;
OWL_ARM_HALF_W = 2.8;
OWL_ARM_IN = 16.05;
OWL_ARM_T = 1;
OWL_B = 10;
OWL_DOME_P = 2.2;
OWL_EYE_R = 4.4;
OWL_EYE_X = 5.35;
OWL_EYE_Z = 19.2;
OWL_FLARE = 1.5;
OWL_FLOOR = 11.4;
OWL_GROOVE_R = 0.4;
OWL_HOOK_T = 1;
OWL_LEADIN_LAND = 0.15;
OWL_LIFT_DESIGNED = 11.45;
OWL_LIP_TIP = 15.2;
OWL_N = 3;
OWL_NOTCH_LEN = 6;
OWL_NOTCH_MID = 0;
OWL_NOTCH_X = 16;
OWL_PUPIL_DEPTH = 1.2;
OWL_PUPIL_R = 2;
OWL_RECESS_A = 11.5;
OWL_RECESS_B = 6;
OWL_RECESS_RIDGE = [5.5,5.5];
OWL_RIM = 2.5;
OWL_ROOT_Z = 9;
OWL_SLAB_HALF_X = 14.6;
OWL_SLAB_TOP = 2.8;
OWL_SLAB_Y = [-13.6,10.6];
OWL_SLOT = 2;
OWL_SLOT_CLEAR = 0.4;
OWL_TALON = 1;
OWL_TOP_Z = 27;
OWL_TUFT_BASE = [7.6,0.5,22.4,3.2];
OWL_TUFT_TIP = [11,0.5,29.6,0.5];
OWL_WING_MEET_Z = 17.6;
OWL_Z0 = 3;
OWL_Z_BOTTOM = -3;
OWL_Z_CATCH = -2;
PAUSE_LAYER = 84;
PAUSE_LAYER_TOP = 16.8;
PAUSE_Z = 16.6;
PLA_DENSITY = 1.24;
PLA_E = 3500;
POCKET_DEPTH = 2.2;
POCKET_FLOOR_Z = 14.4;
POCKET_R = 5.175;
STRAIN_OK = 0.02;
STRAIN_PLA_MAX = 0.03;
WING_RELIEF = 1.55;
PLATE_OWL = [-26,10];
PLATE_BAT_CAP = [30,10];
PLATE_FOOT1 = [-36,-28];
PLATE_FOOT2 = [-12,-28];
PLATE_FOOT3 = [12,-28];
PLATE_FOOT4 = [36,-28];
BAT_Z_FLOATING = -15.22328;   // float gap 11.09 mm (sim/physics)
