gallicchio/OWLternatingCurrent/(list of files, cad)

Other CAD files:
print/out/shapes.scad
