gallicchio/OWLternatingCurrent/sim/antenna/results/dn007_measured_s11_digitized.csv

# f_GHz | S11_dB (digitised from TI SWRU120D Fig. 2-8 | CC2430DB board | 1 mm FR4)
2.0000 | -4.5362
2.0050 | -4.6003
2.0100 | -4.6910
2.0150 | -4.8480
2.0200 | -5.0085
2.0250 | -5.1465
2.0300 | -5.2651
2.0350 | -5.3818
2.0400 | -5.5216
2.0450 | -5.6905
2.0500 | -5.9128
2.0550 | -6.1439
2.0600 | -6.3127
2.0650 | -6.4371
2.0700 | -6.6166
2.0750 | -6.8422
2.0800 | -7.0561
2.0850 | -7.2714
2.0900 | -7.5161
2.0950 | -7.7012
2.1000 | -7.9455
2.1050 | -8.1043
2.1100 | -8.3008
2.1150 | -8.4421
2.1200 | -8.6245
2.1250 | -8.8067
2.1300 | -8.8886
2.1350 | -8.9755
2.1400 | -9.1296
2.1450 | -9.2727
2.1500 | -9.3587
2.1550 | -9.3979
2.1600 | -9.4337
2.1650 | -9.4386
2.1700 | -9.5071
2.1750 | -9.6354
2.1800 | -9.7537
2.1850 | -9.7742
2.1900 | -9.7580
2.1950 | -9.7619
2.2000 | -9.8068
2.2050 | -9.8964
2.2100 | -9.9738
2.2150 | -9.9968
2.2200 | -9.9428
2.2250 | -9.8963
2.2300 | -9.8966
2.2350 | -9.9471
2.2400 | -9.9471
2.2450 | -9.9172
2.2500 | -9.8556
2.2550 | -9.9222
2.2600 | -10.0053
2.2650 | -10.1352
2.2700 | -10.3025
2.2750 | -10.4307
2.2800 | -10.5801
2.2850 | -10.7764
2.2900 | -11.0330
2.2950 | -11.2895
2.3000 | -11.4717
2.3050 | -11.7353
2.3100 | -11.9277
2.3150 | -12.1121
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
