gallicchio/OWLternatingCurrent/sim/antenna/results/validation.csv

case | f_res | r_res | f_min | s11_min | bw_lo | bw_hi | eta | D | cells | t_min
MoM nseg=61 | 2.4349 | 72.4099
MoM nseg=121 | 2.4332 | 72.7669
dipole_fs_r0.125 | 2.4223 | 72.2289 | 2.4040 | -15.1122 | 2.3053 | 2.5149 | 0.9909 | 2.0960 | 3021959 | 26.9223
dipole_fs_r0.25 | 2.4154 | 72.2619 | 2.3960 | -15.1138 | 2.2964 | 2.5091 | 0.9909 | 2.0960 | 900893 | 12.0938
dipole_fs_r0.5 | 2.4014 | 72.2998 | 2.3810 | -15.1241 | 2.2788 | 2.4974 | 0.9903 | 2.0962 | 295519 | 1.8024
dn007_h1.0_g29x60 | 2.7258 | 25.7268 | 2.6970 | -10.1246 | 2.6767 | 2.7175 | 0.9235 | 4.3118 | 1152800 | 14.1796
dn007_h1.0_g29x60_r0.18 | 2.7128 | 25.9093 | 2.6850 | -10.2011 | 2.6592 | 2.7108 | 0.9253 | 4.3112 | 1909908 | 22.8661
dn007_h1.0_g50x80 | 2.3787 | 54.6535 | 2.3820 | -27.1032 | 2.2345 | 2.6114 | 0.9654 | 3.0564 | 1304250 | 14.5166
dn007_h1.6_g29x60 | 2.6068 | 21.3390 | 2.5620 | -8.2690 | nan | nan | 0.8994 | 4.4021 | 1083632 | 13.6496
