gallicchio/OWLternatingCurrent/bringup/results/2026-11-06/161232_ripple_4v8.png

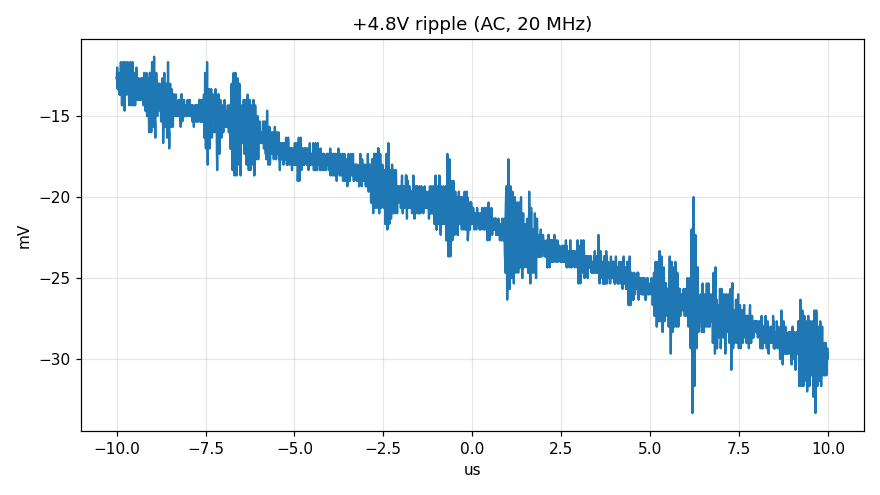
bringup/results/2026-11-06/161232_ripple_4v8.png
