gallicchio/OWLternatingCurrent/bringup/results/2026-11-06/161556_powerup_screen.png

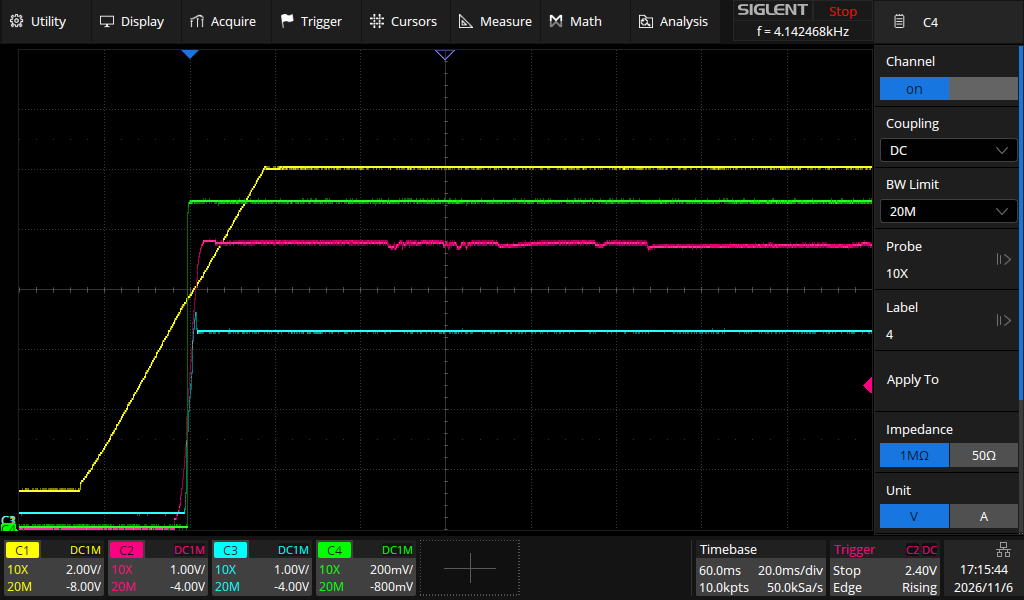
bringup/results/2026-11-06/161556_powerup_screen.png
