gallicchio/OWLternatingCurrent/bringup/results/2026-11-06/163147_perch.png

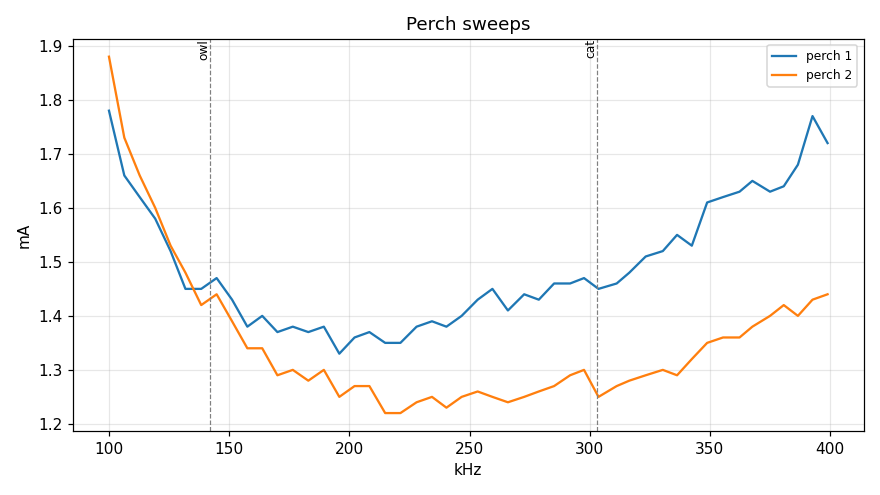
bringup/results/2026-11-06/163147_perch.png
