gallicchio/OWLternatingCurrent/bringup/results/2026-11-06/172647_perch.png

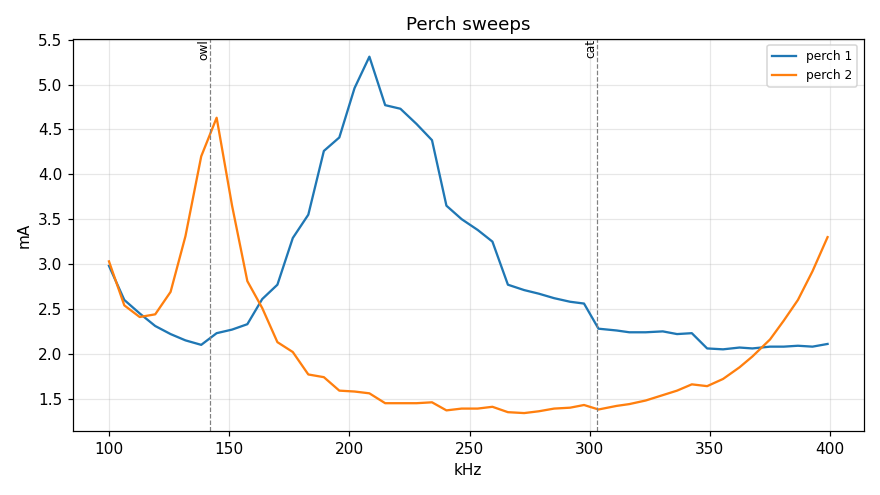
bringup/results/2026-11-06/172647_perch.png
