gallicchio/OWLternatingCurrent/bringup/results/2026-11-06/212529_audio_4v8.png

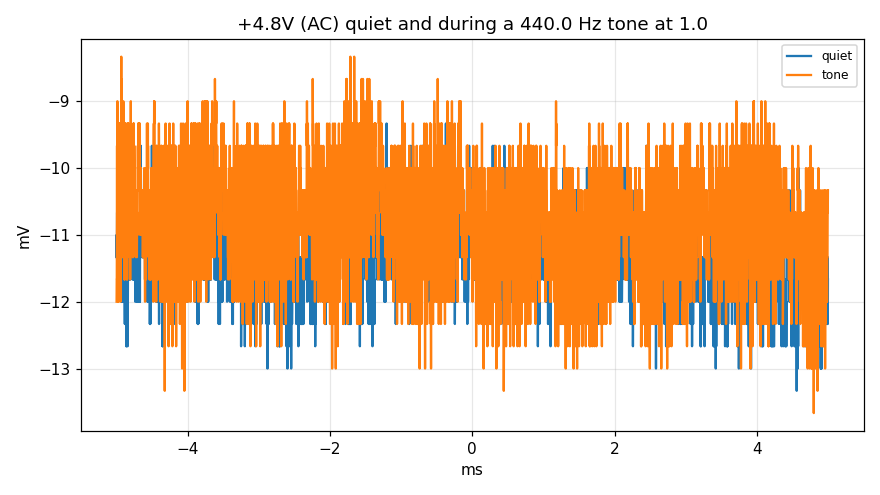
bringup/results/2026-11-06/212529_audio_4v8.png
