gallicchio/OWLternatingCurrent/bringup/results/2026-11-06/212626_sweep1.png

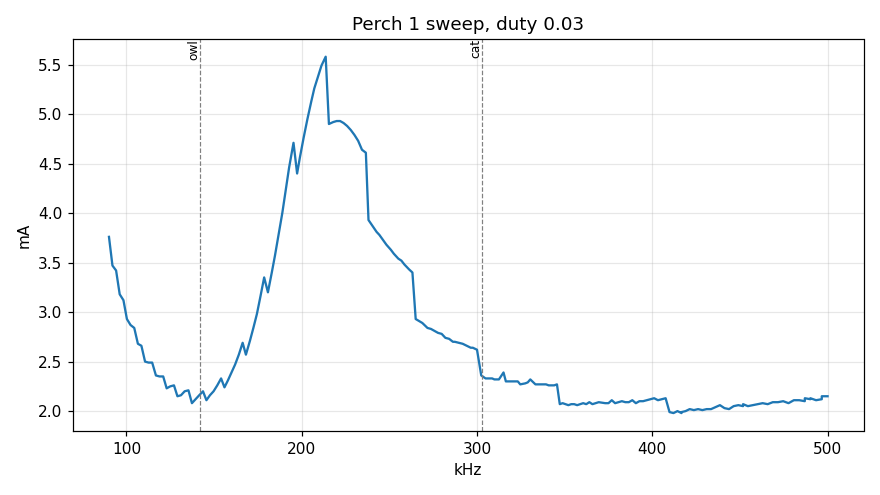
bringup/results/2026-11-06/212626_sweep1.png
