gallicchio/OWLternatingCurrent/bringup/results/2026-11-06/212633_sweep1.png

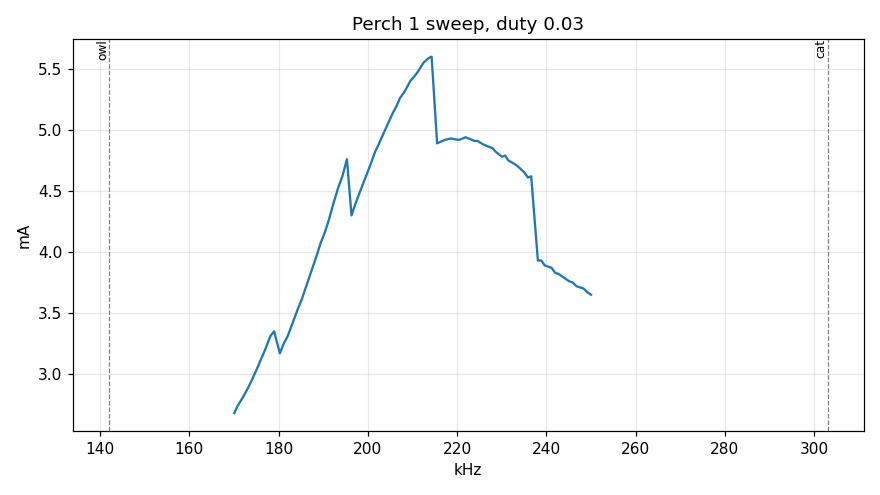
bringup/results/2026-11-06/212633_sweep1.png
