gallicchio/OWLternatingCurrent/bringup/results/2026-11-06/212635_sweep2.png

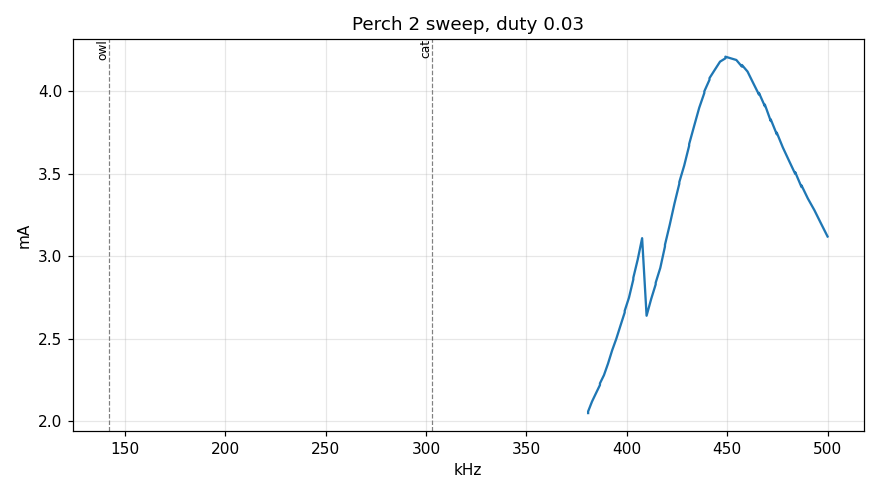
bringup/results/2026-11-06/212635_sweep2.png
