gallicchio/OWLternatingCurrent/bringup/results/2026-11-06/213404_audio_4v8_sim.png

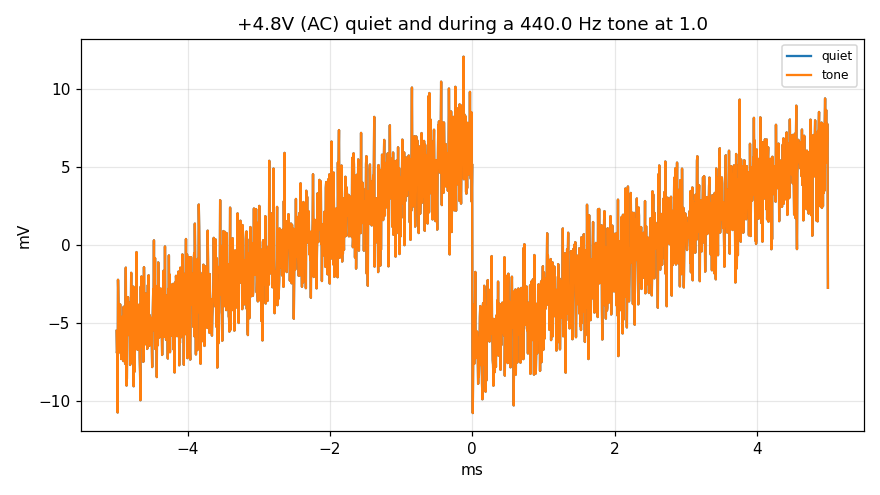
bringup/results/2026-11-06/213404_audio_4v8_sim.png
