gallicchio/OWLternatingCurrent/bringup/results/2026-11-06/213418_sweep2_sim.png

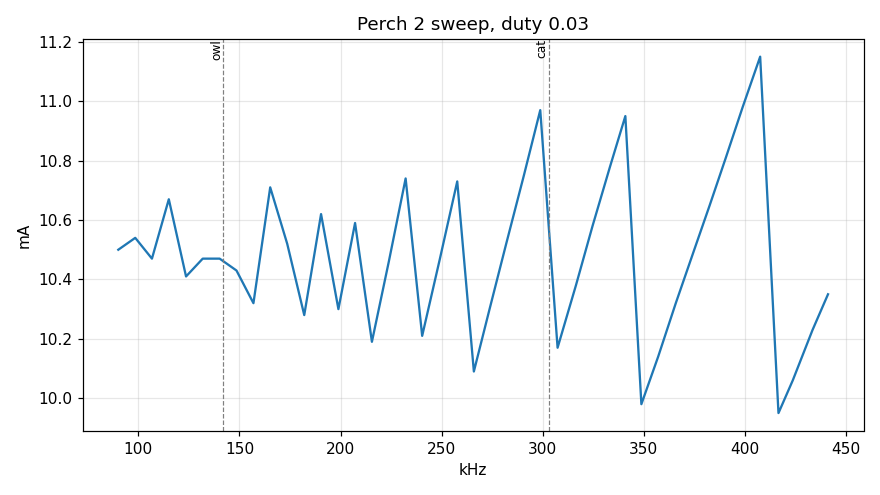
bringup/results/2026-11-06/213418_sweep2_sim.png
