gallicchio/OWLternatingCurrent/bringup/results/2026-11-06/213653_speaker_sim.png

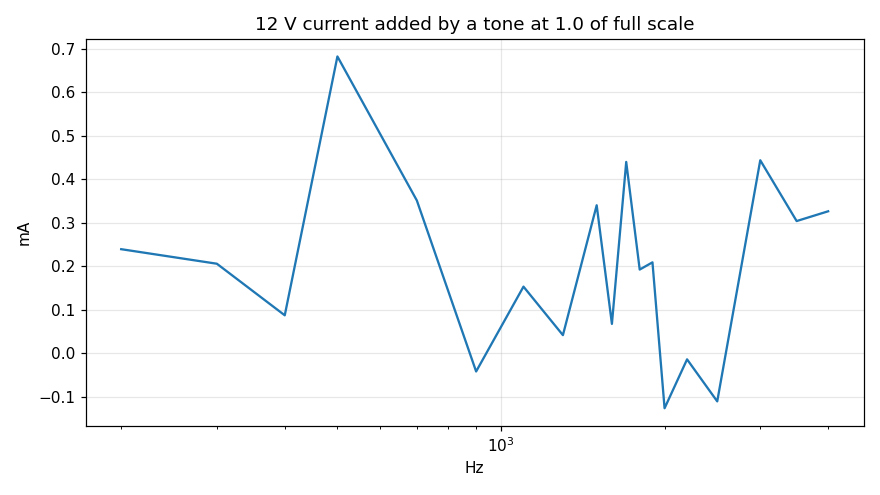
bringup/results/2026-11-06/213653_speaker_sim.png
