gallicchio/OWLternatingCurrent/bringup/results/2026-11-07/131632_audio_4v8.png

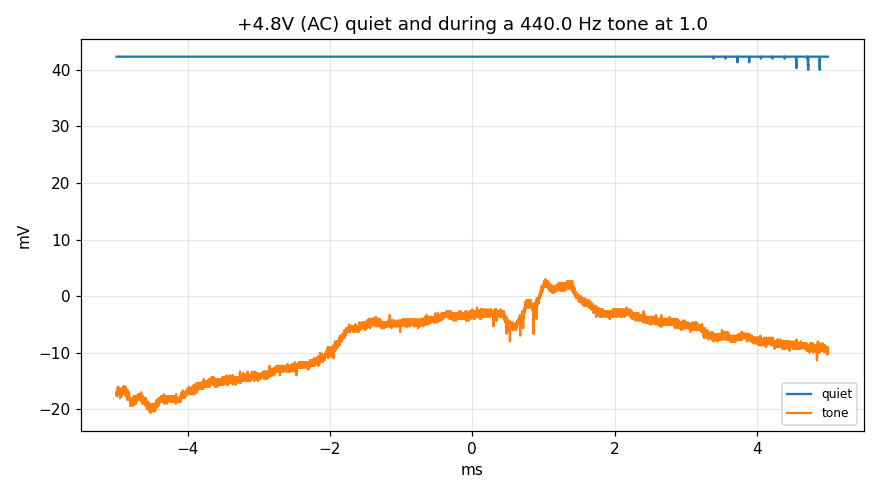
bringup/results/2026-11-07/131632_audio_4v8.png
