gallicchio/OWLternatingCurrent/bringup/results/2026-11-07/131913_speaker.png

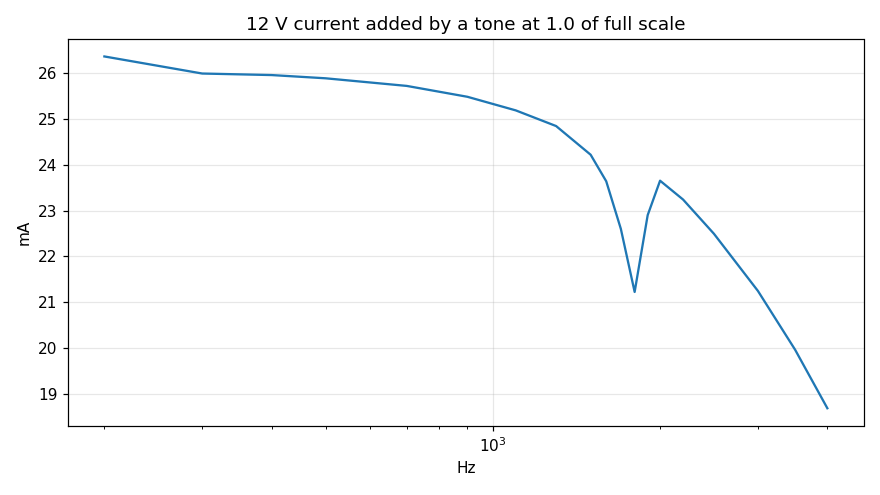
bringup/results/2026-11-07/131913_speaker.png
