gallicchio/OWLternatingCurrent/bringup/results/2026-11-07/131929_sweep1.png

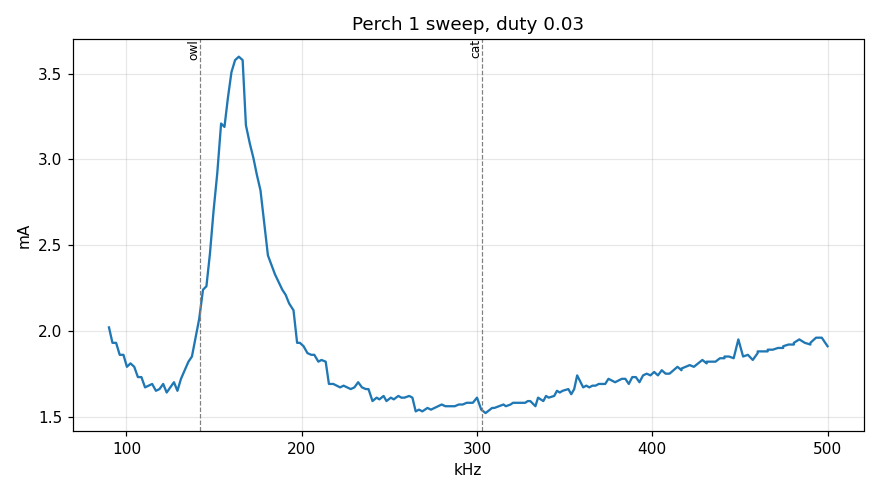
bringup/results/2026-11-07/131929_sweep1.png
