gallicchio/OWLternatingCurrent/bringup/results/2026-11-07/131933_sweep2.png

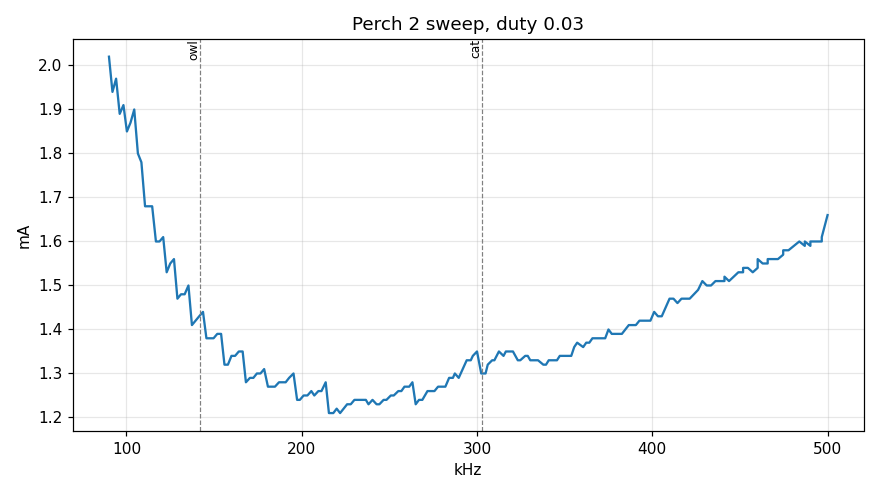
bringup/results/2026-11-07/131933_sweep2.png
