gallicchio/OWLternatingCurrent/bringup/results/2026-11-07/132017_sweep2.png

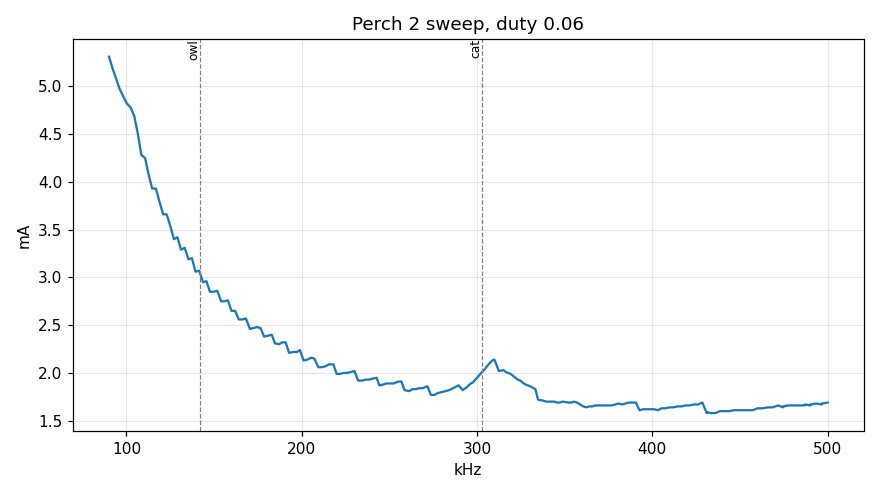
bringup/results/2026-11-07/132017_sweep2.png
