gallicchio/OWLternatingCurrent/bringup/results/2026-11-07/132100_ripple_4v8.png

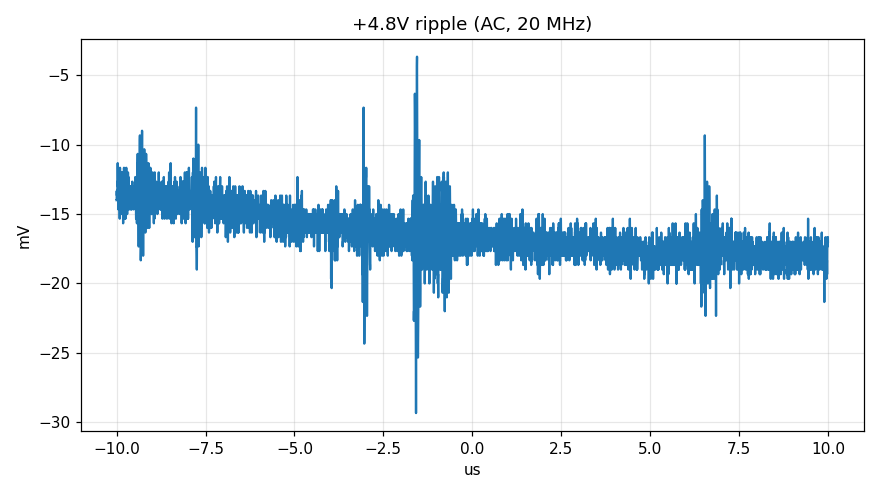
bringup/results/2026-11-07/132100_ripple_4v8.png
