gallicchio/OWLternatingCurrent/bringup/results/2026-11-07/132627_sweep1.png

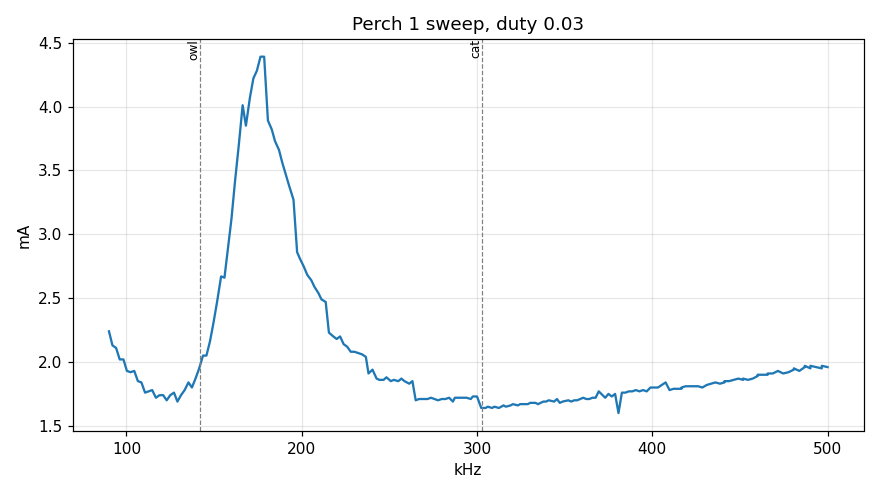
bringup/results/2026-11-07/132627_sweep1.png
