gallicchio/OWLternatingCurrent/bringup/results/2026-11-07/132632_sweep1.png

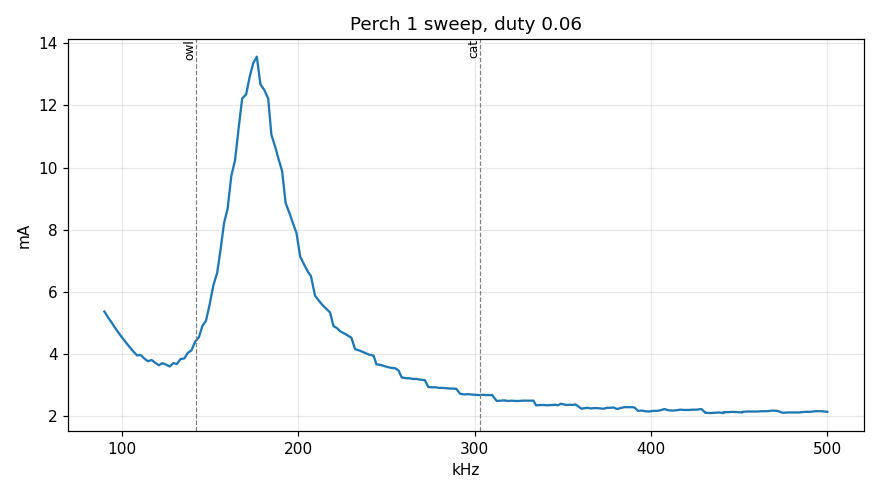
bringup/results/2026-11-07/132632_sweep1.png
