gallicchio/OWLternatingCurrent/bringup/results/2026-11-07/132641_sweep2.png

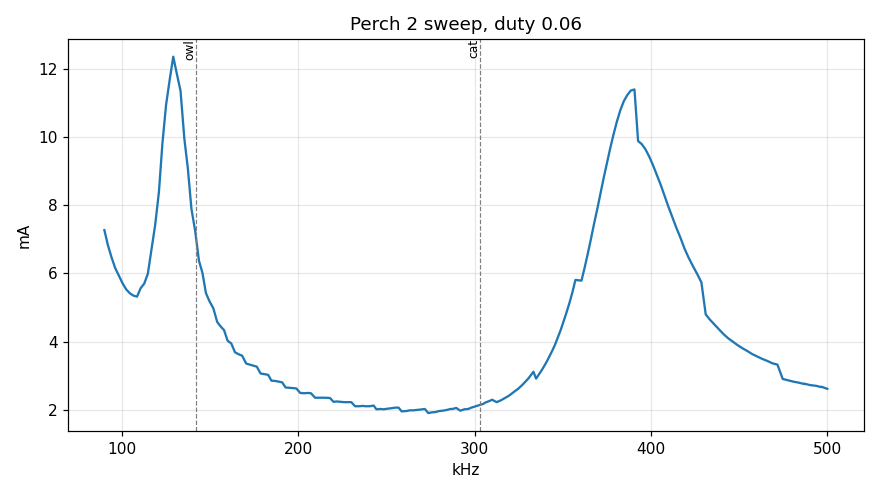
bringup/results/2026-11-07/132641_sweep2.png
