gallicchio/OWLternatingCurrent/bringup/results/2026-11-09/coil_thermo_heat_cool.png

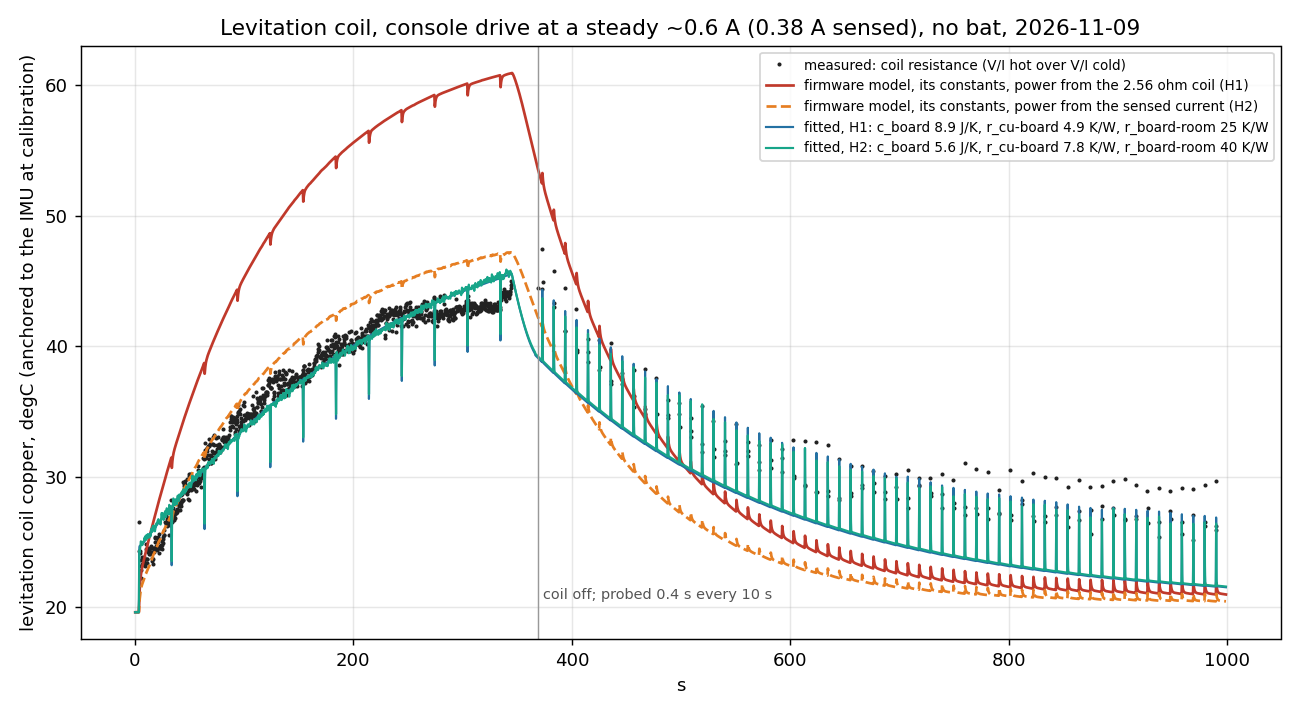
bringup/results/2026-11-09/coil_thermo_heat_cool.png
