gallicchio/OWLternatingCurrent/sim/physics/results/coil_forces.png

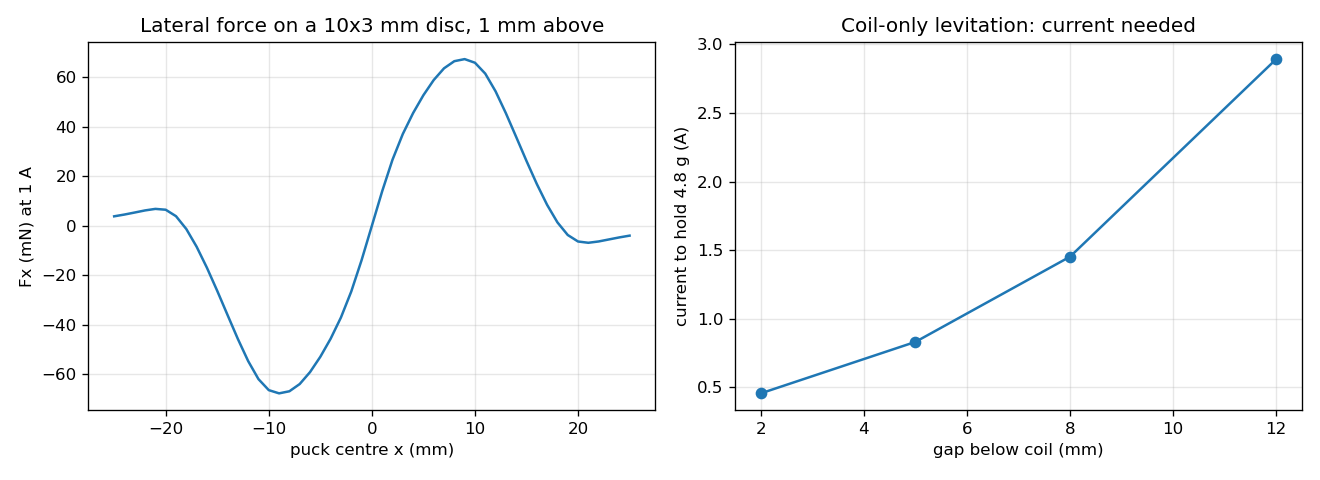
sim/physics/results/coil_forces.png
