gallicchio/OWLternatingCurrent/sim/physics/results/familiar.png

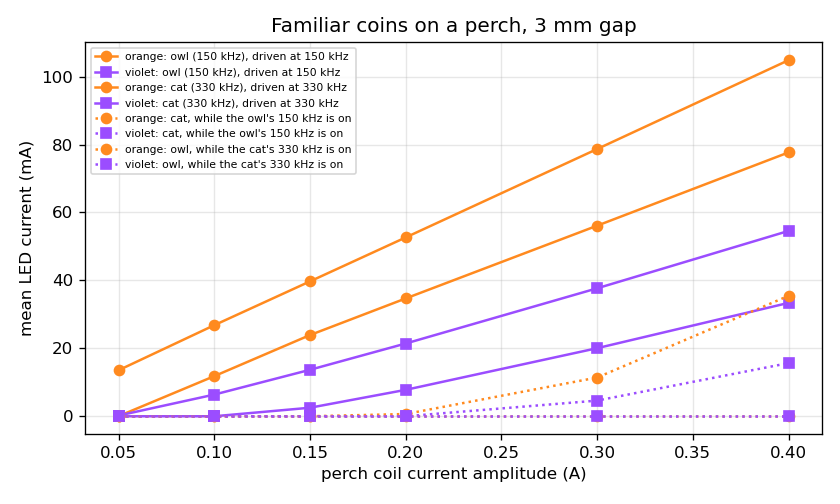
sim/physics/results/familiar.png
