gallicchio/OWLternatingCurrent/sim/physics/results/levitation.png

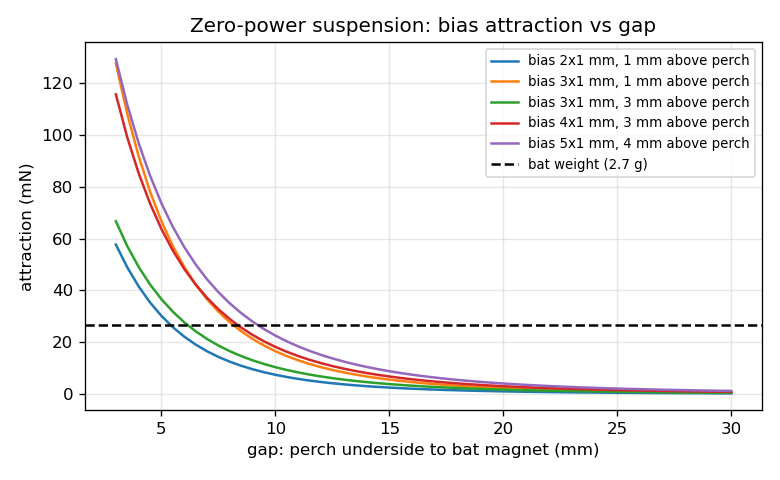
sim/physics/results/levitation.png
