gallicchio/OWLternatingCurrent/sim/physics/results/levitation_loop.png

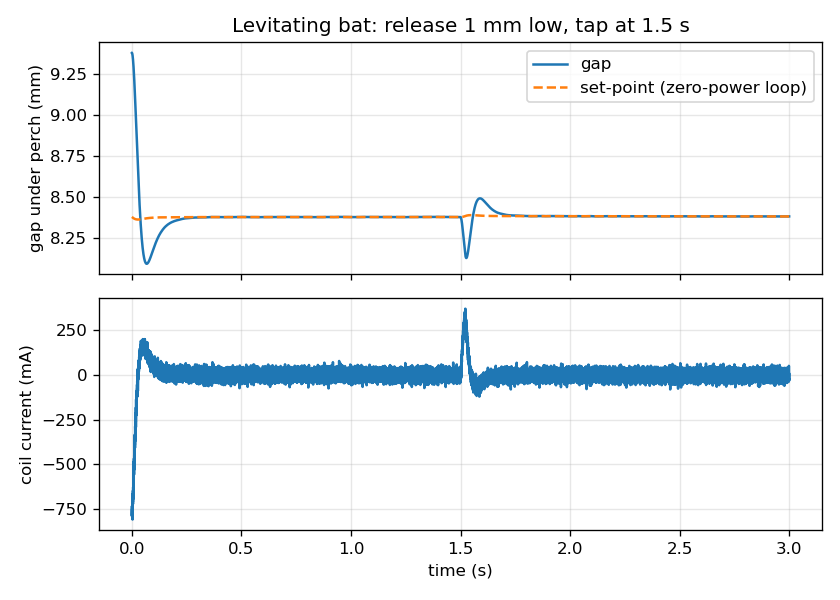
sim/physics/results/levitation_loop.png
