gallicchio/OWLternatingCurrent/sim/physics/results/wpt_link.png

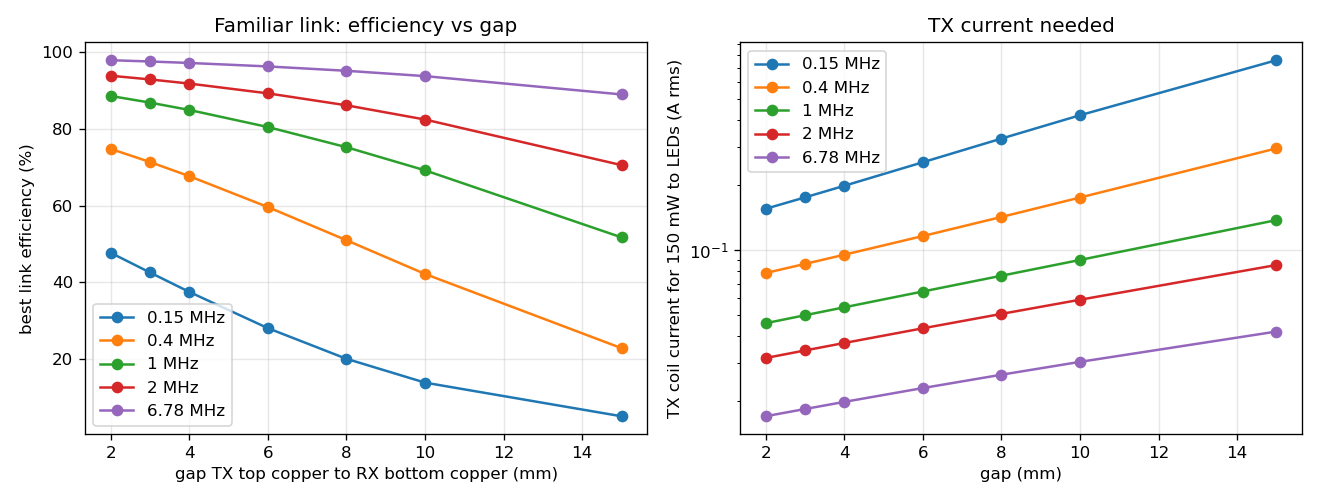
sim/physics/results/wpt_link.png
