gallicchio/OWLternatingCurrent/mfg/release/OWLternatingCurrent_assembly_bottom.pdf

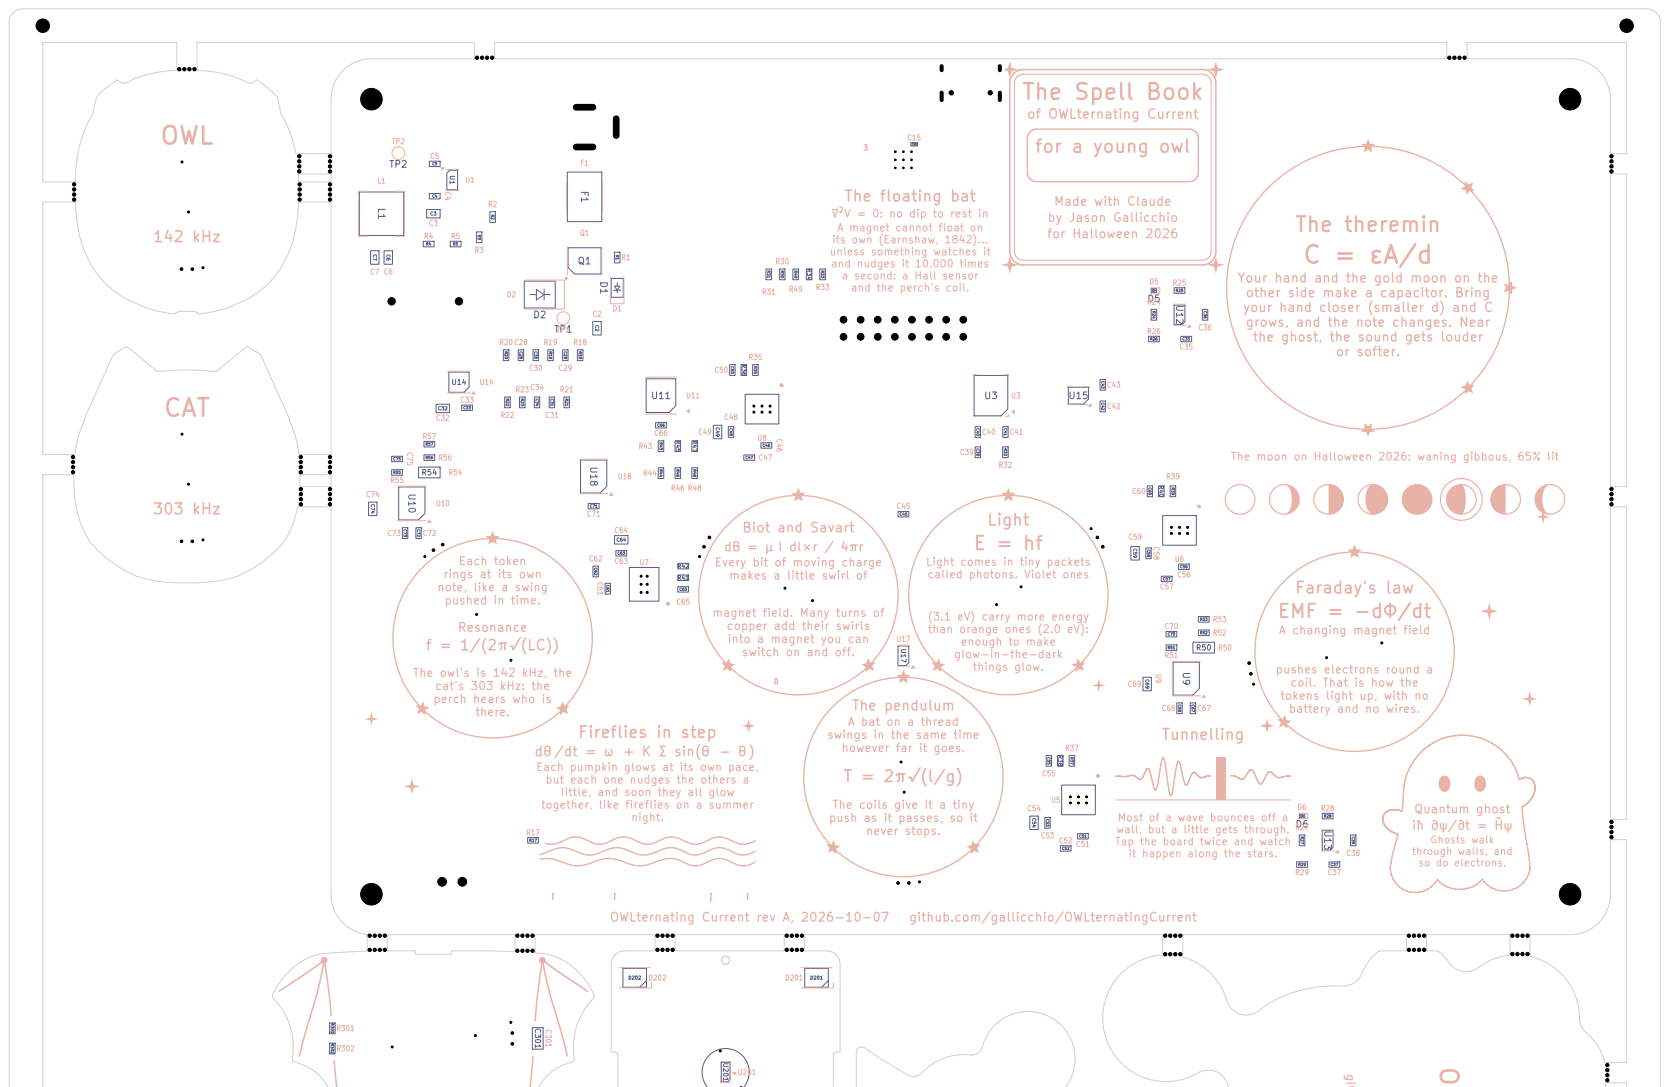
[picture p134: page 1]

the ghost, the sound gets louder or softer. of OWLternating Current
for a young owl

The floating bat
∇²V = 0: no dip to rest in
A magnet cannot float on

iħ ∂ψ/∂t = Ĥψ Made with Claude by Jason Gallicchio

for Halloween 2026 OWLternating Current rev A, 2026-10-07 github.com/gallicchio/OWLternatingCurrent dB = μ

your hand closer (smaller d) and C
grows, and the note changes. Near

switch on and off. Each token
rings at its own
note, like a swing
pushed in time. The owl's is 142 kHz, the

Every bit of moving charge makes a little swirl of magnet field. Many turns of copper add their swirls

(3.1 eV) carry more energy
than orange ones (2.0 eV):
enough to make glow-in-the-dark
things glow.

Each pumpkin glows at its own pace, but each one nudges the others a
little, and soon they all glow

into a magnet you can

pushes electrons round a
coil. That is how the
tokens light up, with no

cat's 303 kHz: the perch hears who is

battery and no wires. A bat on a thread

swings in the same time however far it goes. The coils give it a tiny

push as it passes, so it never stops.

so do electrons. Most of a wave bounces off a wall, but a little gets through.

Tap the board twice and watch
it happen along the stars.
