gallicchio/OWLternatingCurrent/mfg/release/OWLternatingCurrent_assembly_top.pdf

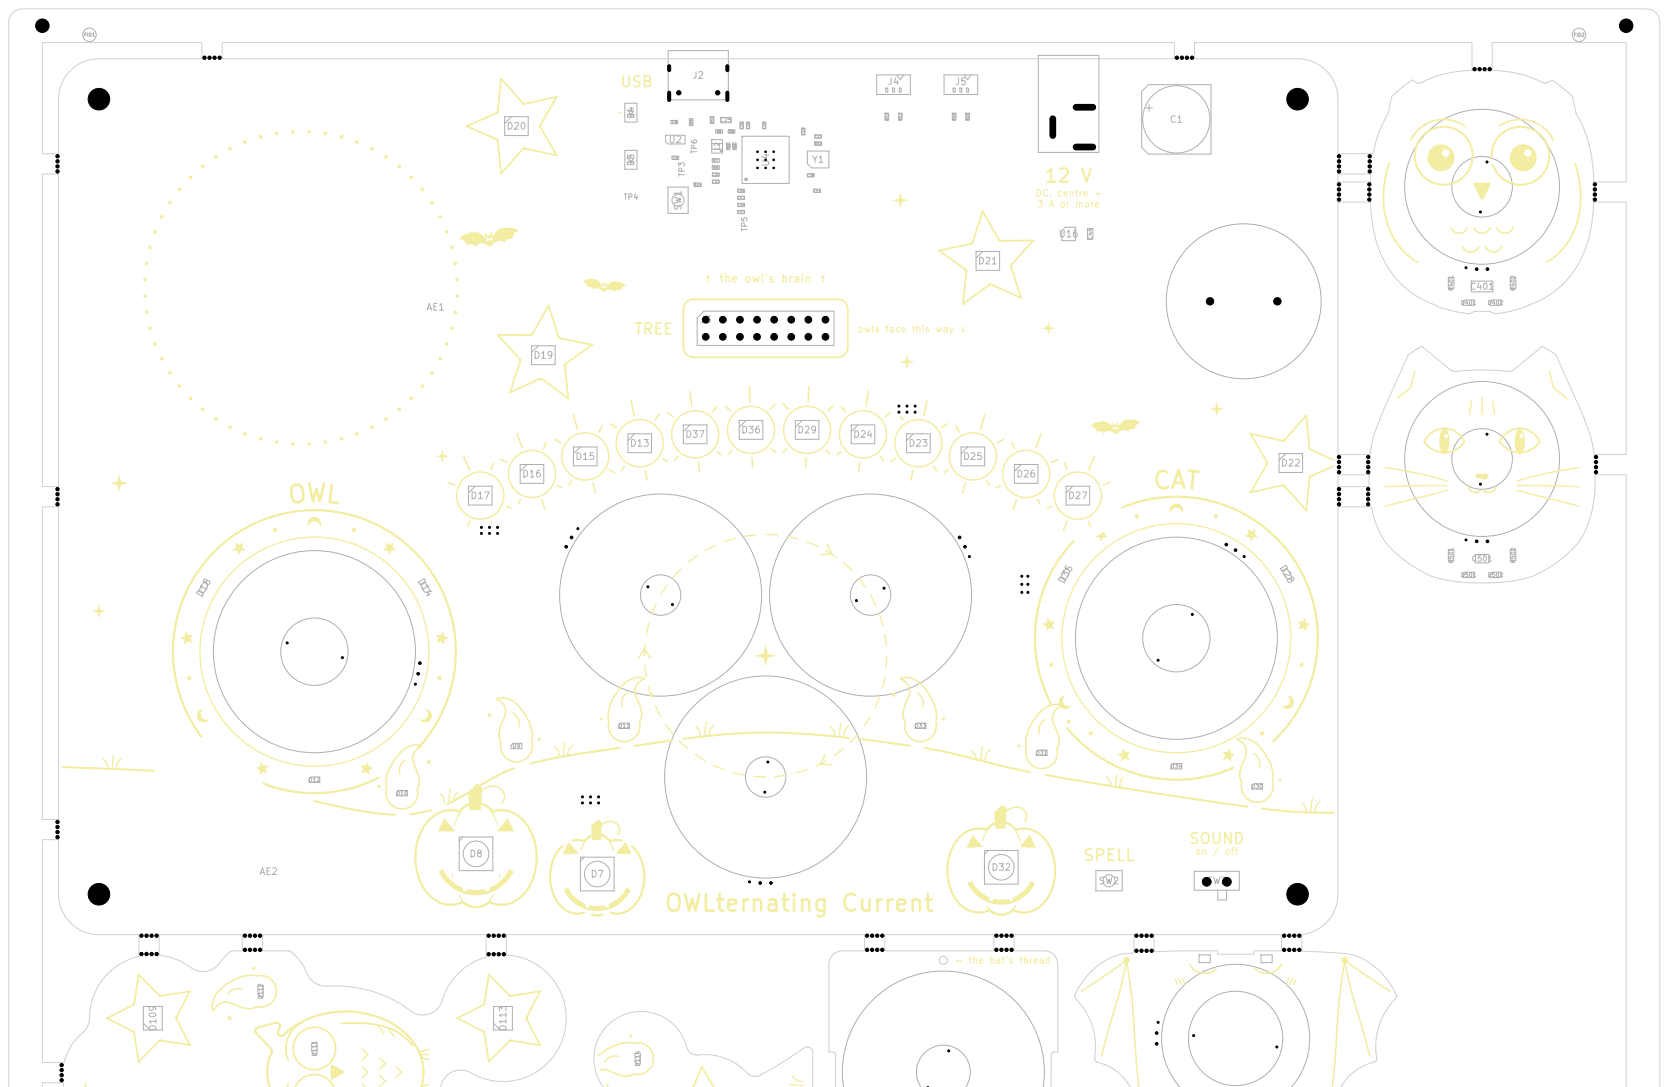
[picture p135: page 1]

on / off ↑ the owl's brain ↑
