gallicchio/OWLternatingCurrent/hardware/OWLternatingCurrent.kicad_pcb

## KiCad design hardware/OWLternatingCurrent.kicad_pcb (2026-10-09)

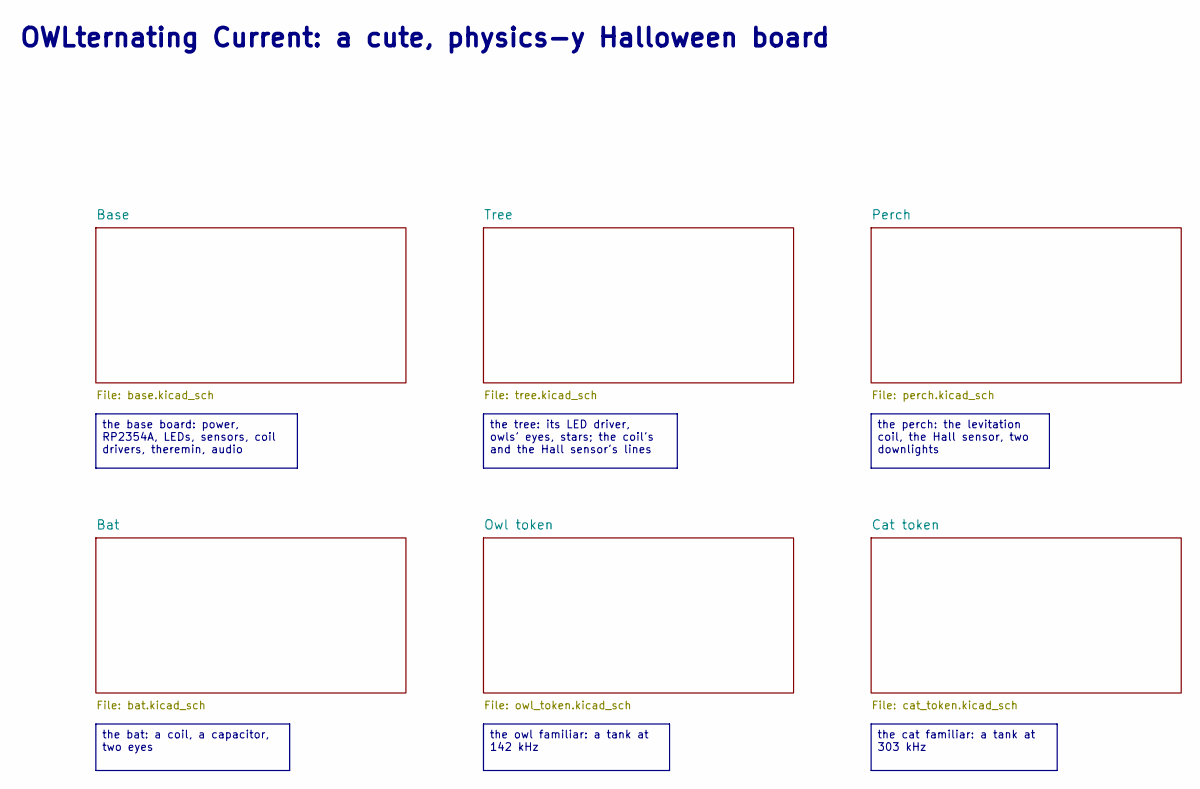
[picture p136: schematic OWLternatingCurrent.kicad_sch, OWLternating Current: a cute, physics-y Halloween board]

Notes on the sheet:
OWLternating Current: a cute, physics-y Halloween board
the base board: power, RP2354A, LEDs, sensors, coil drivers, theremin, audio
the owl familiar: a tank at 142 kHz
the bat: a coil, a capacitor, two eyes
the cat familiar: a tank at 303 kHz
the tree: its LED driver, owls' eyes, stars; the coil's and the Hall sensor's lines
the perch: the levitation coil, the Hall sensor, two downlights

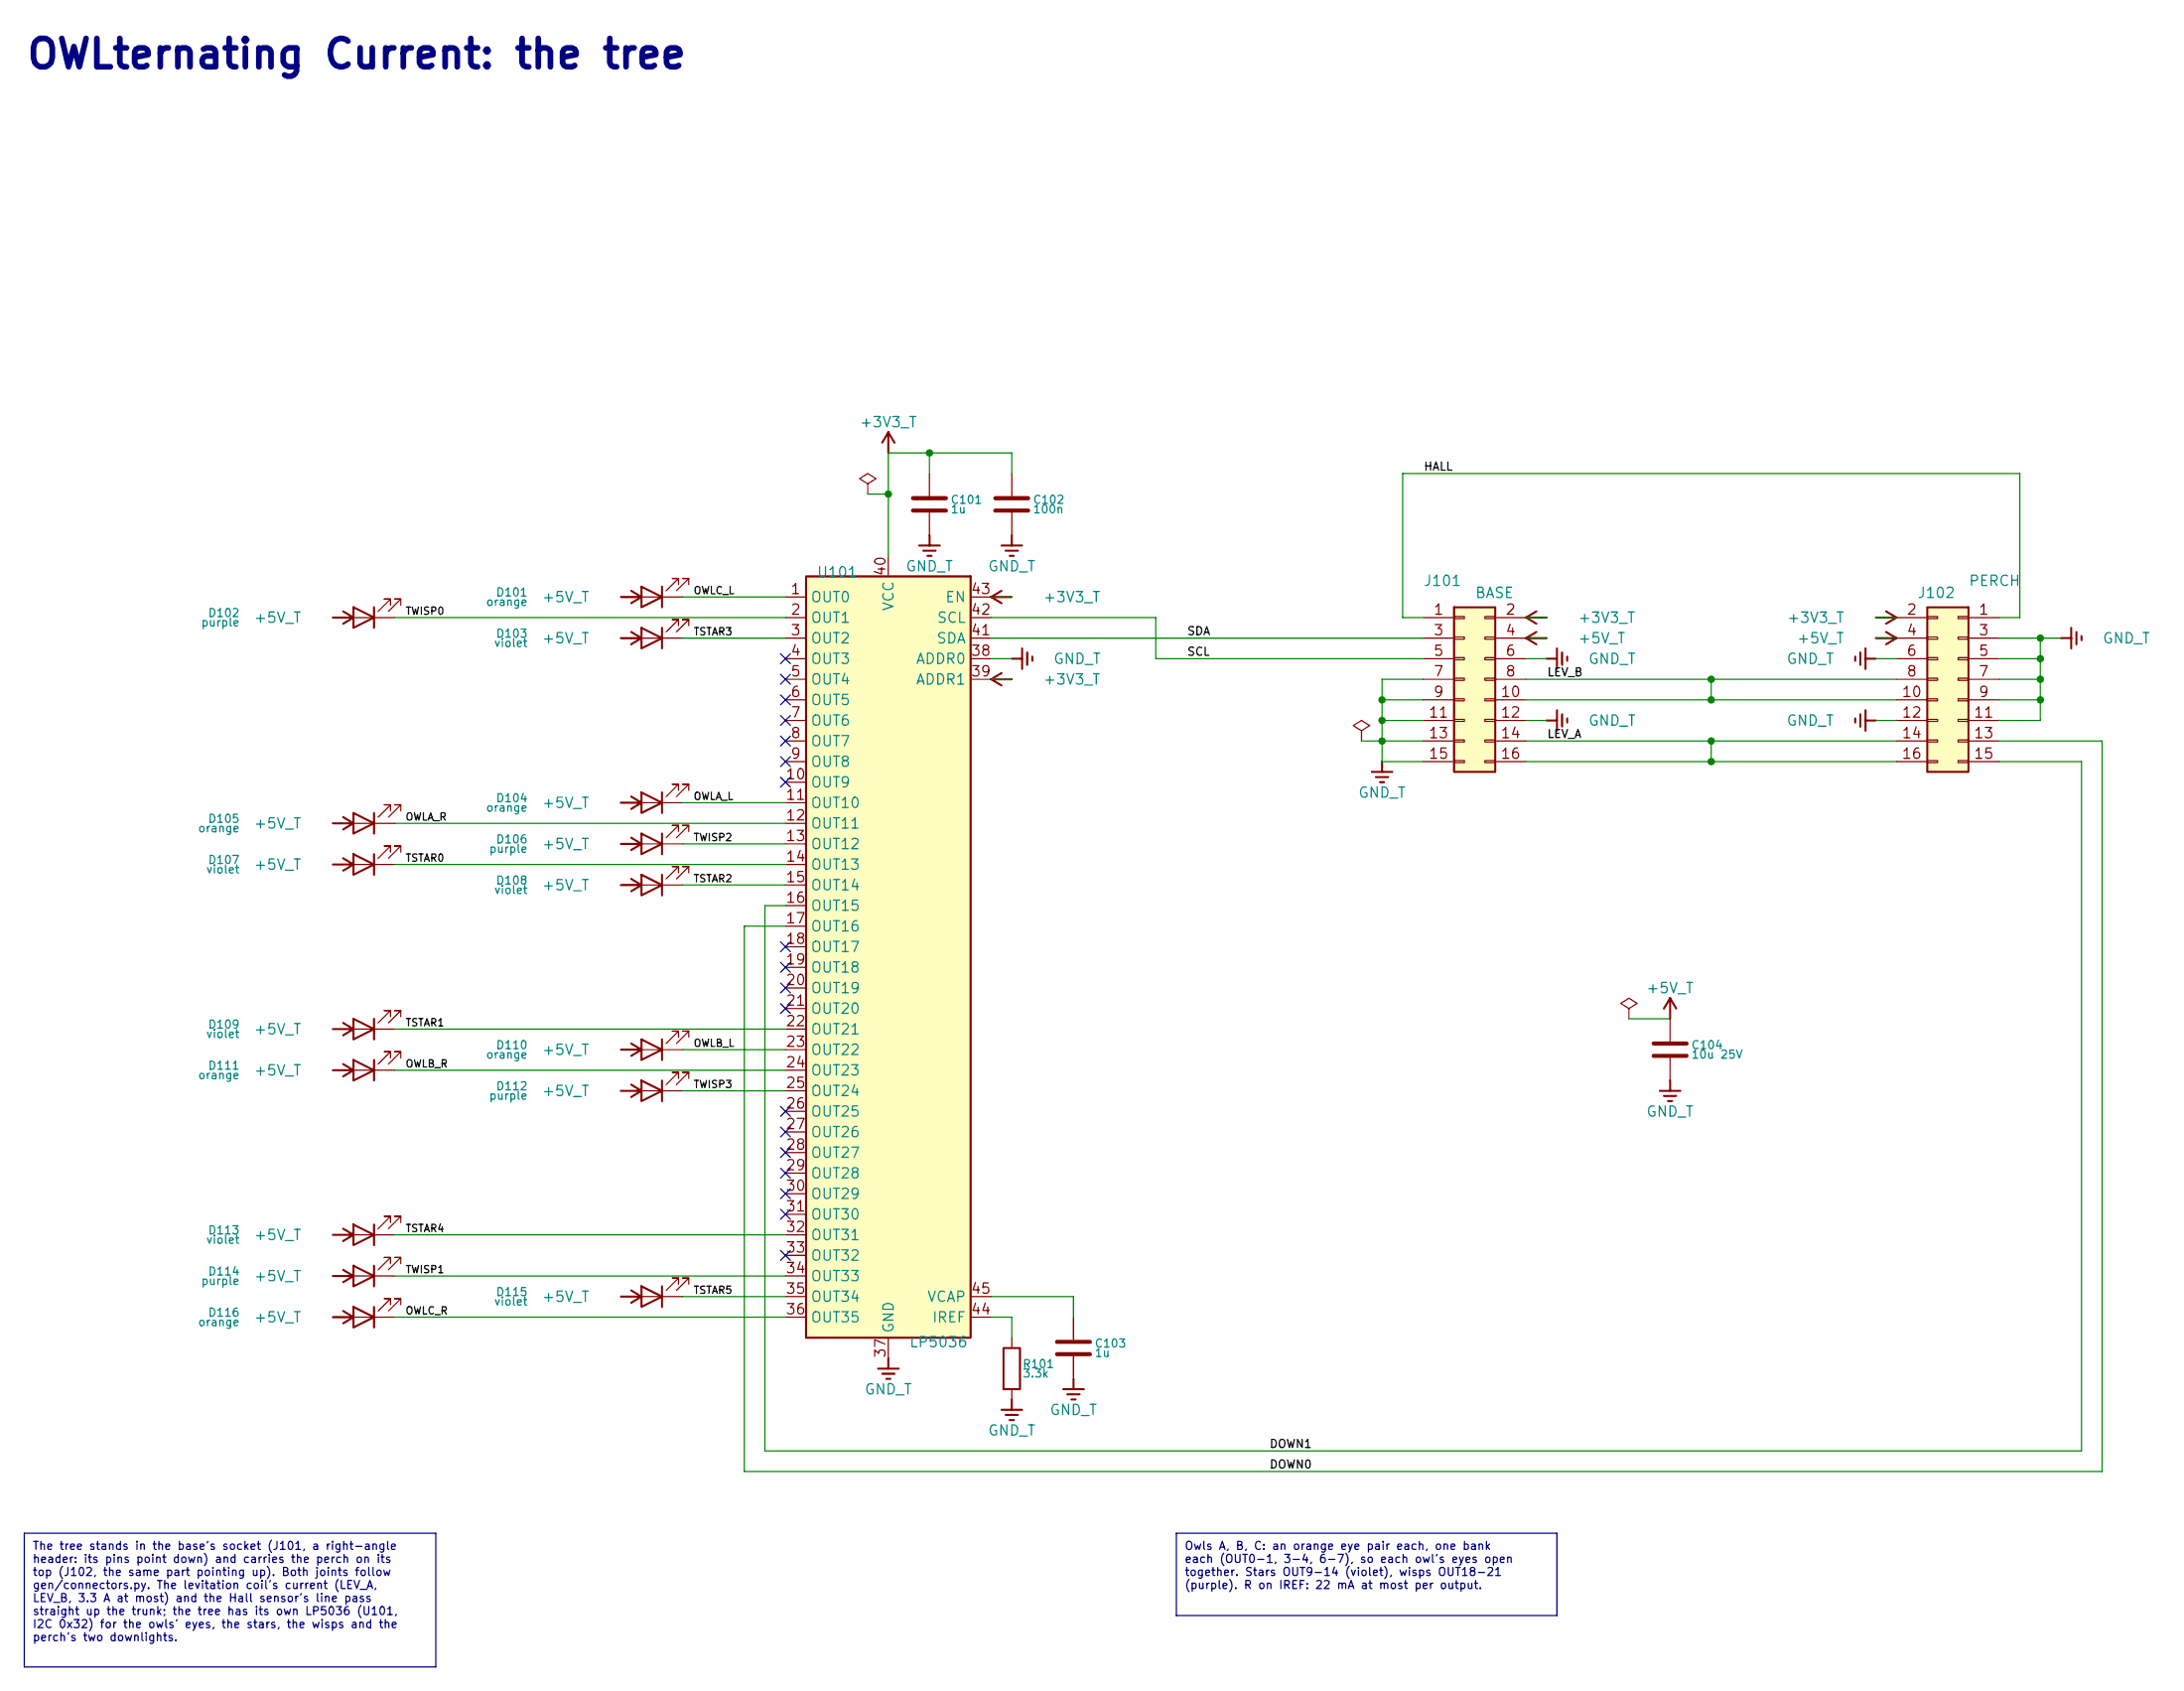
[picture p137: schematic tree.kicad_sch, OWLternating Current: tree]

Parts:
C101, C103: 1u; C_0603_1608Metric; MPN CL10A105KB8NNNC; LCSC C15849
C102: 100n; C_0603_1608Metric; MPN CC0603KRX7R9BB104; LCSC C14663
C104: 10u 25V; C_0805_2012Metric; MPN CL21A106KAYNNNE; LCSC C15850
D101, D104, D105, D110, D111, D116: orange; LED_0603_1608Metric; MPN XL-1608UOC-06; LCSC C965800
D102, D106, D112, D114: purple; LED_0603_1608Metric; MPN GL0603PU01; LCSC C51933300
D103, D107, D108, D109, D113, D115: violet; LED_Everlight-SMD3528_3.5x2.8mm_67-21ST; MPN HL-A-3528S7VC-S1-13HL; LCSC C516136
J101: BASE; PinHeader_2x08_P2.54mm_Horizontal; MPN PZ254-2-08-W-8.5; LCSC C2894988
J102: PERCH; PinHeader_2x08_P2.54mm_Horizontal; MPN PZ254-2-08-W-8.5; LCSC C2894988
R101: 3.3k; R_0603_1608Metric; MPN 0603WAF3301T5E; LCSC C22978
U101: LP5036; VQFN-46-1EP_5x6mm_P0.4mm_EP2.8x3.8mm; MPN LP5036RJVR; LCSC C701961

Connections:
+3V3_T: C101.1, C102.1, J101.2, J102.2, U101.39 (ADDR1), U101.40 (VCC), U101.43 (EN)
+5V_T: C104.1, D101.2 (A), D102.2 (A), D103.2 (A), D104.2 (A), D105.2 (A), D106.2 (A), D107.2 (A), D108.2 (A), D109.2 (A), D110.2 (A), D111.2 (A), D112.2 (A), D113.2 (A), D114.2 (A), D115.2 (A), D116.2 (A), J101.4, J102.4
/Tree/DOWN0: J102.13, U101.17 (OUT16)
/Tree/DOWN1: J102.15, U101.16 (OUT15)
/Tree/HALL: J101.1, J102.1
/Tree/LEV_A: J101.14, J101.16, J102.14, J102.16
/Tree/LEV_B: J101.8, J101.10, J102.8, J102.10
/Tree/OWLA_L: D104.1 (K), U101.11 (OUT10)
/Tree/OWLA_R: D105.1 (K), U101.12 (OUT11)
/Tree/OWLB_L: D110.1 (K), U101.23 (OUT22)
/Tree/OWLB_R: D111.1 (K), U101.24 (OUT23)
/Tree/OWLC_L: D101.1 (K), U101.1 (OUT0)
/Tree/OWLC_R: D116.1 (K), U101.36 (OUT35)
/Tree/SCL: J101.5, U101.42 (SCL)
/Tree/SDA: J101.3, U101.41 (SDA)
/Tree/TSTAR0: D107.1 (K), U101.14 (OUT13)
/Tree/TSTAR1: D109.1 (K), U101.22 (OUT21)
/Tree/TSTAR2: D108.1 (K), U101.15 (OUT14)
/Tree/TSTAR3: D103.1 (K), U101.3 (OUT2)
/Tree/TSTAR4: D113.1 (K), U101.32 (OUT31)
/Tree/TSTAR5: D115.1 (K), U101.35 (OUT34)
/Tree/TWISP0: D102.1 (K), U101.2 (OUT1)
/Tree/TWISP1: D114.1 (K), U101.34 (OUT33)
/Tree/TWISP2: D106.1 (K), U101.13 (OUT12)
/Tree/TWISP3: D112.1 (K), U101.25 (OUT24)
GND_T: C101.2, C102.2, C103.2, C104.2, J101.6, J101.7, J101.9, J101.11, J101.12, J101.13, J101.15, J102.3, J102.5, J102.6, J102.7, J102.9, J102.11, J102.12, R101.2, U101.37 (GND), U101.38 (ADDR0), U101.46 (GND), U101.47 (GND)
unnamed: R101.1, U101.44 (IREF)
unnamed: C103.1, U101.45 (VCAP)

Notes on the sheet:
OWLternating Current: the tree
The tree stands in the base's socket (J101, a right-angle header: its pins point down) and carries the perch on its top (J102, the same part pointing up). Both joints follow gen/connectors.py. The levitation coil's current (LEV_A, LEV_B, 3.3 A at most) and the Hall sensor's line pass straight up th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
Owls A, B, C: an orange eye pair each, one bank each (OUT0-1, 3-4, 6-7), so each owl's eyes open together. Stars OUT9-14 (violet), wisps OUT18-21 (purple). R on IREF: 22 mA at most per output.

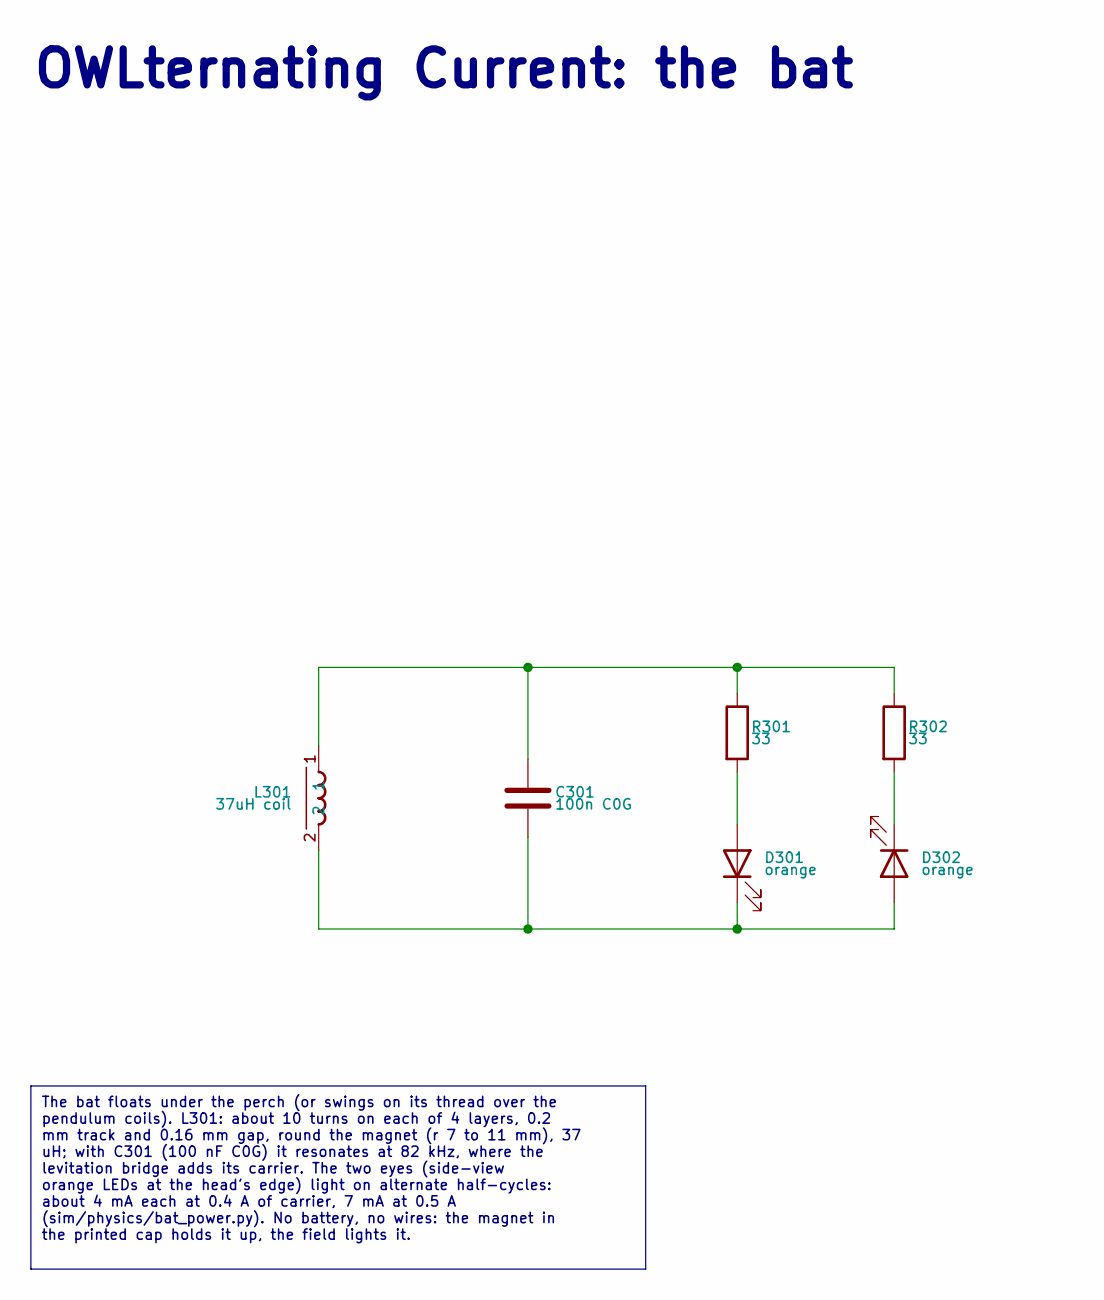
[picture p138: schematic bat.kicad_sch, OWLternating Current: bat]

Parts:
C301: 100n C0G; C_1206_3216Metric; MPN GRM31C5C1H104JA01L; LCSC C97946
D301, D302: orange; LED_LiteOn_LTST-S270_SideView; MPN LTST-S270KFKT; LCSC C160472
L301: 37uH coil; Coil_BAT; MPN PCB coil
R301, R302: 33; R_0603_1608Metric; MPN 0603WAF330JT5E; LCSC C23140

Connections:
unnamed: C301.1, L301.1, R301.1, R302.1
unnamed: D301.2 (A), R301.2
unnamed: C301.2, D301.1 (K), D302.2 (A), L301.2
unnamed: D302.1 (K), R302.2

Notes on the sheet:
OWLternating Current: the bat
The bat floats under the perch (or swings on its thread over the pendulum coils). L301: about 10 turns on each of 4 layers, 0.2 mm track and 0.16 mm gap, round the magnet (r 7 to 11 mm), 37 uH; with C301 (100 nF C0G) it resonates at 82 kHz, where the levitation bridge adds its carrier. The two eyes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

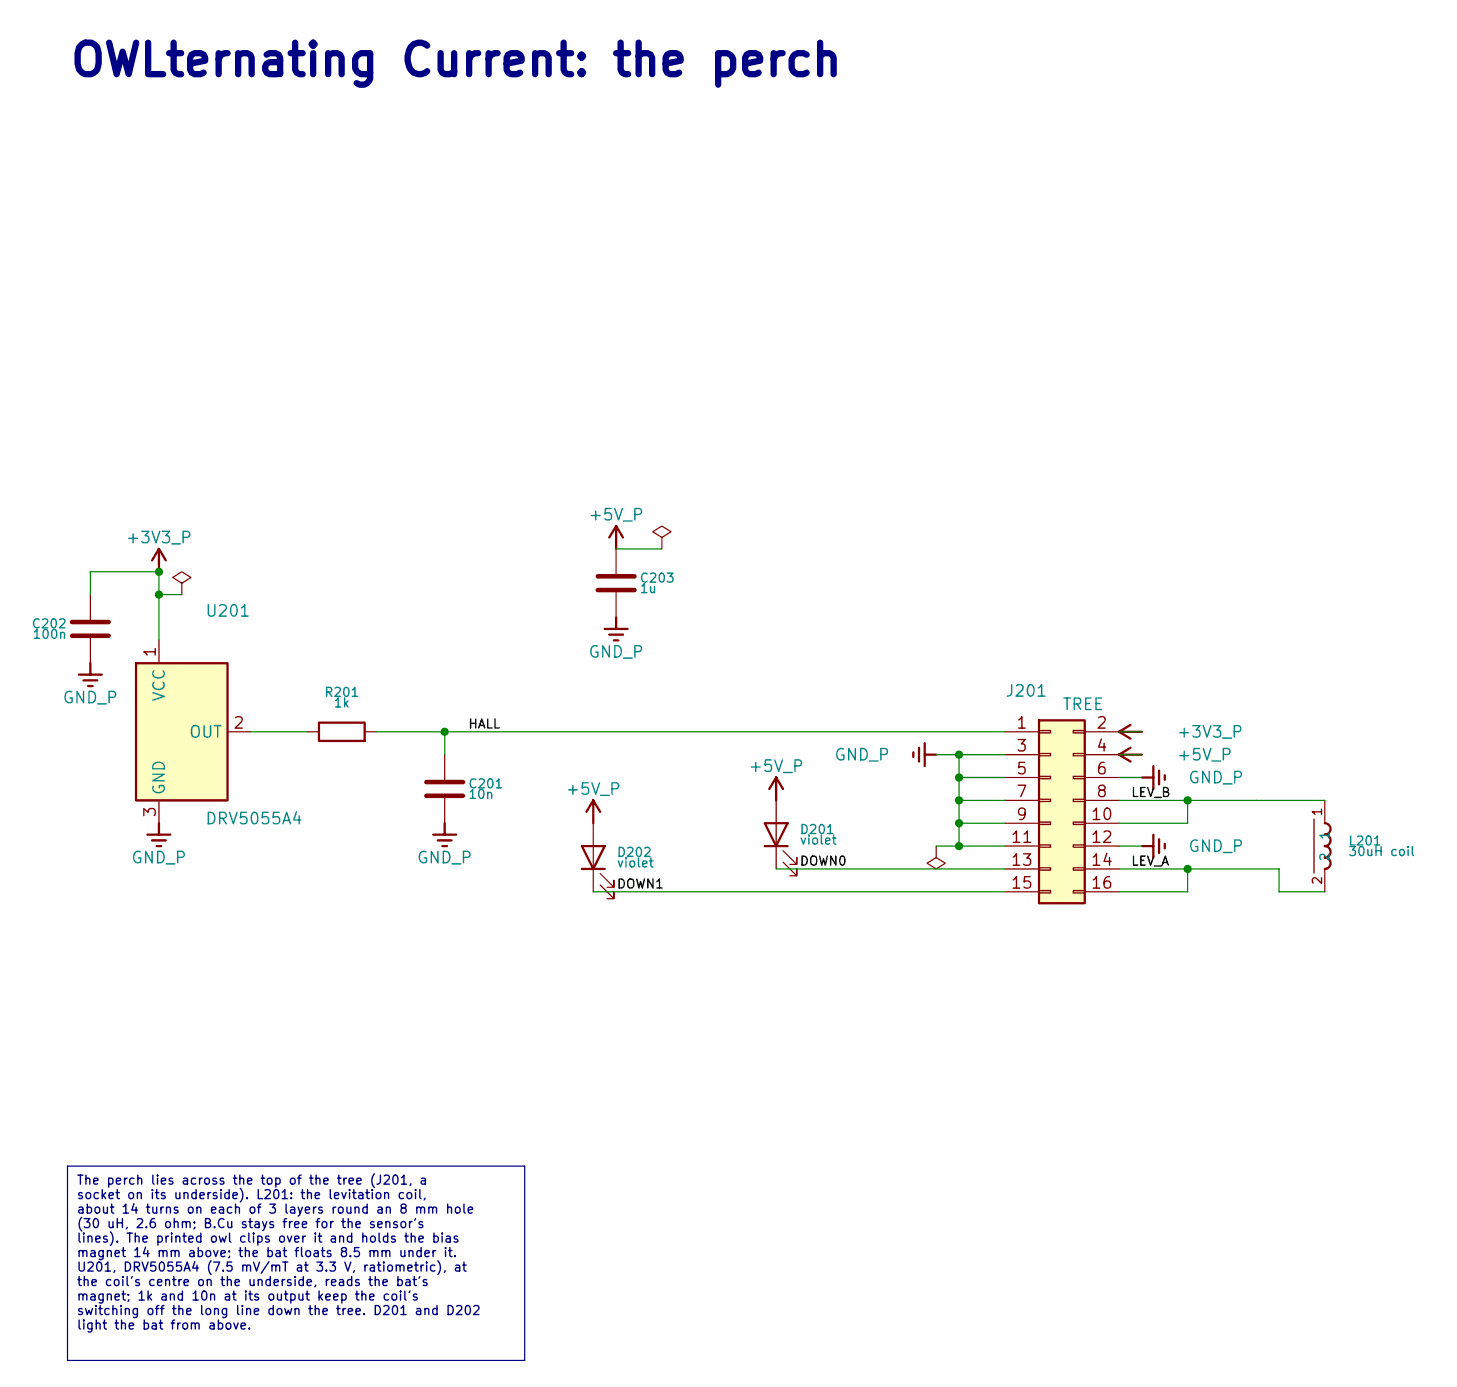
[picture p139: schematic perch.kicad_sch, OWLternating Current: perch]

Parts:
C201: 10n; C_0603_1608Metric; MPN 0603B103K500NT; LCSC C57112
C202: 100n; C_0603_1608Metric; MPN CC0603KRX7R9BB104; LCSC C14663
C203: 1u; C_0603_1608Metric; MPN CL10A105KB8NNNC; LCSC C15849
D201, D202: violet; LED_Everlight-SMD3528_3.5x2.8mm_67-21ST; MPN HL-A-3528S7VC-S1-13HL; LCSC C516136
J201: TREE; PinSocket_2x08_P2.54mm_Vertical; MPN PM254-2-08-Z-8.5; LCSC C2897409
L201: 30uH coil; Coil_LEV; MPN PCB coil
R201: 1k; R_0603_1608Metric; MPN 0603WAF1001T5E; LCSC C21190
U201: DRV5055A4; SOT-23; MPN DRV5055A4QDBZR; LCSC C266123

Connections:
+3V3_P: C202.1, J201.2, U201.1 (VCC)
+5V_P: C203.1, D201.2 (A), D202.2 (A), J201.4
/Perch/DOWN0: D201.1 (K), J201.13
/Perch/DOWN1: D202.1 (K), J201.15
/Perch/HALL: C201.1, J201.1, R201.2
/Perch/LEV_A: J201.14, J201.16, L201.2
/Perch/LEV_B: J201.8, J201.10, L201.1
GND_P: C201.2, C202.2, C203.2, J201.3, J201.5, J201.6, J201.7, J201.9, J201.11, J201.12, U201.3 (GND)
unnamed: R201.1, U201.2 (OUT)

Notes on the sheet:
OWLternating Current: the perch
The perch lies across the top of the tree (J201, a socket on its underside). L201: the levitation coil, about 14 turns on each of 3 layers round an 8 mm hole (30 uH, 2.6 ohm; B.Cu stays free for the sensor's lines). The printed owl clips over it and holds the bias magnet 14 mm above; the bat floats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

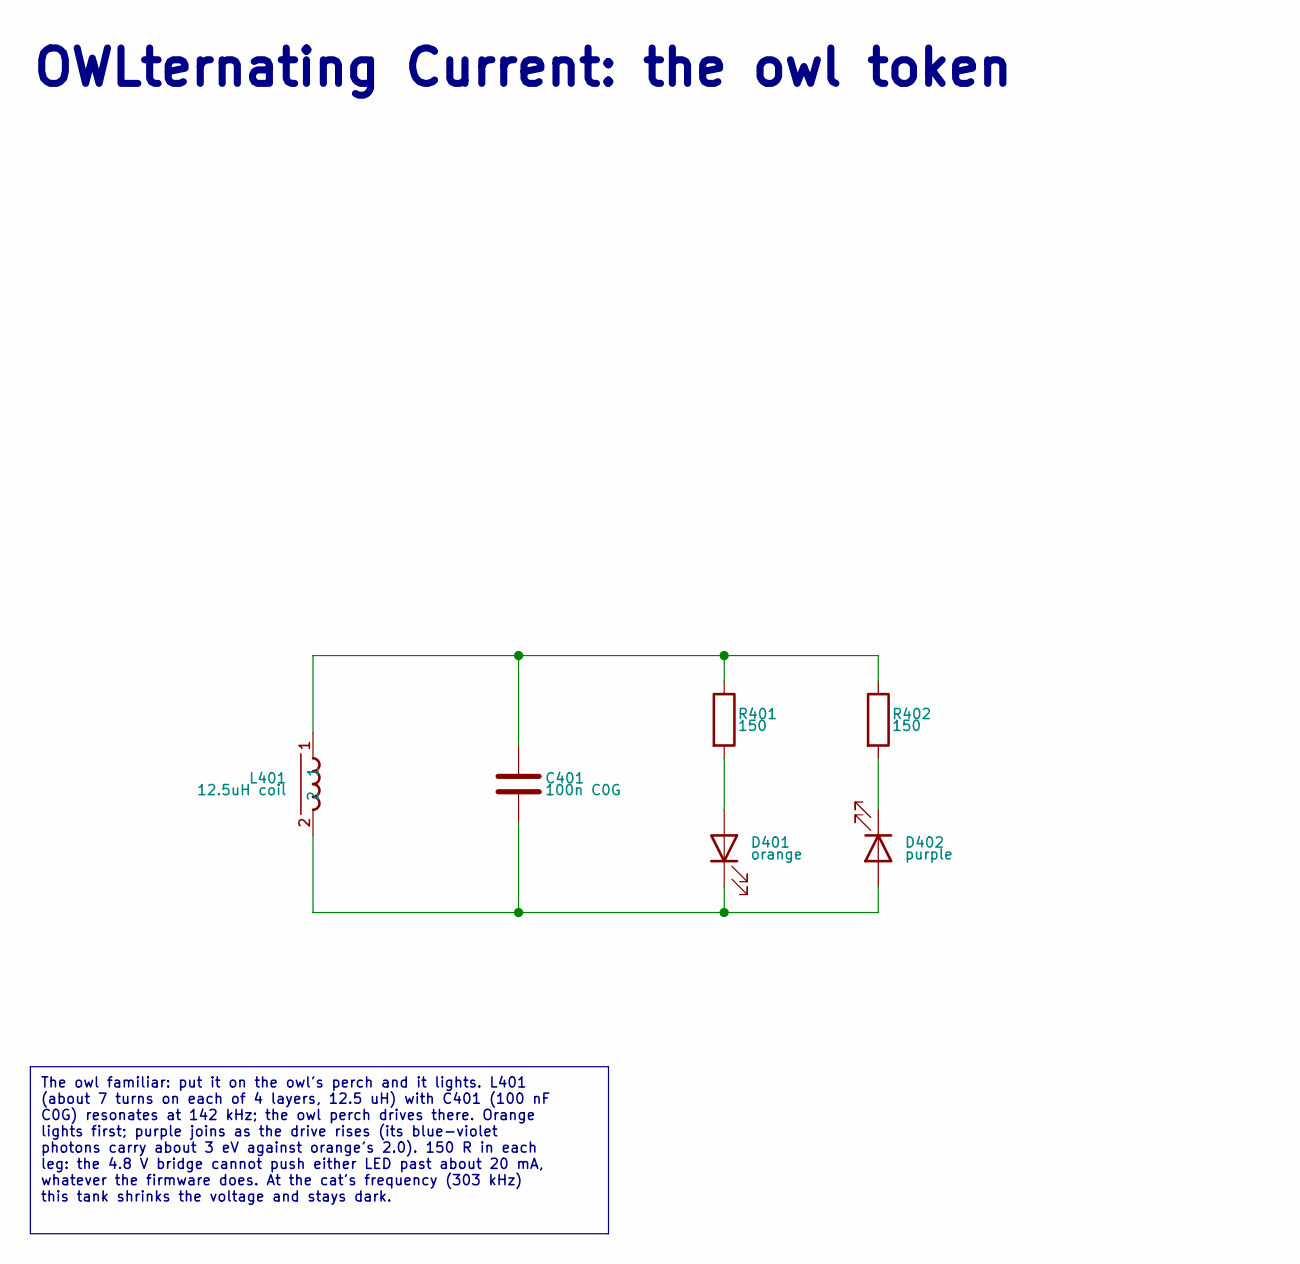
[picture p140: schematic owl_token.kicad_sch, OWLternating Current: owl token]

Parts:
C401: 100n C0G; C_1206_3216Metric; MPN GRM31C5C1H104JA01L; LCSC C97946
D401: orange; LED_0603_1608Metric; MPN XL-1608UOC-06; LCSC C965800
D402: purple; LED_0603_1608Metric; MPN GL0603PU01; LCSC C51933300
L401: 12.5uH coil; Coil_TOKEN; MPN PCB coil
R401, R402: 150; R_0603_1608Metric; MPN 0603WAF1500T5E; LCSC C22808

Connections:
unnamed: C401.1, L401.1, R401.1, R402.1
unnamed: D401.2 (A), R401.2
unnamed: C401.2, D401.1 (K), D402.2 (A), L401.2
unnamed: D402.1 (K), R402.2

Notes on the sheet:
OWLternating Current: the owl token
The owl familiar: put it on the owl's perch and it lights. L401 (about 7 turns on each of 4 layers, 12.5 uH) with C401 (100 nF C0G) resonates at 142 kHz; the owl perch drives there. Orange lights first; purple joins as the drive rises (its blue-violet photons carry about 3 eV against orange's 2.0).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

Schematic: base.kicad_sch, OWLternating Current: base

Parts:
AE1: moon; TestPoint_Pad_D1.5mm
AE2: ghost; TestPoint_Pad_D1.5mm
C1: 470u 35V; CP_Elec_10x12.6; MPN MA35V470M10X13; LCSC C46550472
C2, C3, C32, C49, C54, C59, C64, C69, C74: 10u 25V; C_0805_2012Metric; MPN CL21A106KAYNNNE; LCSC C15850
C4, C5, C35, C37, C40, C42, C43, C45, C47, C48, C52, C53, C57, C58, C62, C63, C66, C68, C70, C71, C73, C75: 100n; C_0603_1608Metric; MPN CC0603KRX7R9BB104; LCSC C14663
C6, C7: 22u 25V; C_0805_2012Metric; MPN CL21A226MAQNNNE; LCSC C45783
C8, C9: 1u; C_0402_1005Metric; MPN CL05A105KA5NQNC; LCSC C52923
C10: 4.7u; C_0402_RPi; MPN CL05A475MP5NRNC; LCSC C23733
C11, C12: 4.7u; C_0402_RPi_wide; MPN CL05A475MP5NRNC; LCSC C23733
C13, C14, C15, C16, C17, C18, C19, C20, C21, C22, C23, C24: 100n; C_0402_1005Metric; MPN CL05B104KO5NNNC; LCSC C1525
C25: 10u; C_0603_1608Metric; MPN CL10A106KP8NNNC; LCSC C19702
C26, C27: 15p; C_0402_1005Metric; MPN 0402CG150J500NT; LCSC C1548
C28, C31, C46, C51, C56, C61: 22n; C_0603_1608Metric; MPN CL10B223KB8NNNC; LCSC C21122
C29, C30, C50, C55, C60, C65: 10n; C_0603_1608Metric; MPN 0603B103K500NT; LCSC C57112
C33, C34, C39, C41, C44, C67, C72: 1u; C_0603_1608Metric; MPN CL10A105KB8NNNC; LCSC C15849
C36, C38: 15p; C_0603_1608Metric; MPN CL10C150JB8NNNC; LCSC C1644
D1: BZT52C10; D_SOD-123; MPN BZT52C10; LCSC C173431
D2: SMBJ15A; D_SMB; MPN SMBJ15A; LCSC C19077569
D3, D4: B5819W; D_SOD-123; MPN B5819W SL; LCSC C8598
D5, D6: ESD 0.9pF; D_SOD-923; MPN ESD9L5.0ST5G; LCSC C82326
D7, D8, D32: orange x3; LED_RGB_5050-6; MPN HL-AF-5060S22OC-3-S1-THL; LCSC C516304
D9, D10, D11, D12, D14, D18, D28, D30, D31, D33, D34, D35: purple; LED_0603_1608Metric; MPN GL0603PU01; LCSC C51933300
D13, D15, D16, D17, D19, D20, D21, D22, D23, D24, D25, D26, D27, D29, D36, D37: violet; LED_Everlight-SMD3528_3.5x2.8mm_67-21ST; MPN HL-A-3528S7VC-S1-13HL; LCSC C516136
F1: 3A PTC; Fuse_2920_7451Metric; MPN BSMD2920-300-24V; LCSC C2977527
H1, H2, H3, H4: foot; MountingHole_3.2mm_M3
J1: 12V DC; BarrelJack_XKB_DC-005-5A-2.0_Horizontal; MPN DC-005-5A-2.0; LCSC C381116
J2: USB-C; USB_C_Receptacle_HRO_TYPE-C-31-M-12; MPN TYPE-C-31-M-12; LCSC C165948
J3: TREE; PinSocket_2x08_P2.54mm_Vertical; MPN PM254-2-08-Z-8.5; LCSC C2897409
J4: SWD; JST_SH_BM03B-SRSS-TB_1x03-1MP_P1.00mm_Vertical; MPN BM03B-SRSS-TB(LF)(SN); LCSC C160389
J5: UART; JST_SH_BM03B-SRSS-TB_1x03-1MP_P1.00mm_Vertical; MPN BM03B-SRSS-TB(LF)(SN); LCSC C160389
L1: 10uH; L_Changjiang_FXL0630; MPN FXL0630-100-M; LCSC C167223
L2: 3.3uH; L_Abracon_AOTA-B201610_RPi; MPN AOTA-B201610S3R3-101-T; LCSC C42411119
L3, L4, L5: 33uH coil; Coil_PEND; MPN PCB coil
L6, L7: 30uH coil; Coil_PERCH; MPN PCB coil
LS1: 8R 1W; Speaker_GSPK2307P_D23mm_P10mm; MPN GSPK2307P-8R1W; LCSC C530531
Q1: AO4407A; SOIC-8_3.9x4.9mm_P1.27mm; MPN AO4407A; LCSC C2841482
R1, R2, R22, R25, R28, R47, R52, R56: 100k; R_0603_1608Metric; MPN 0603WAF1003T5E; LCSC C25803
R3, R48: 22k; R_0603_1608Metric; MPN 0603WAF2202T5E; LCSC C31850
R4: 36k; R_0603_1608Metric; MPN 0603WAF3602T5E; LCSC C23147
R5: 5.1k; R_0603_1608Metric; MPN 0603WAF5101T5E; LCSC C23186
R6: 33; R_0402_RPi; MPN 0402WGF330JTCE; LCSC C25105
R7, R8: 27; R_0402_1005Metric; MPN RC0402FR-0727RL; LCSC C138021
R9, R10: 5.1k; R_0402_1005Metric; MPN 0402WGF5101TCE; LCSC C25905
R11, R14: 1k; R_0402_1005Metric; MPN 0402WGF1001TCE; LCSC C11702
R12, R13, R15, R16: 100; R_0402_1005Metric; MPN 0402WGF1000TCE; LCSC C25076
R17, R18, R19, R26, R29, R36, R38, R40, R42, R53, R57: 1k; R_0603_1608Metric; MPN 0603WAF1001T5E; LCSC C21190
R20, R21: 220k; R_0603_1608Metric; MPN 0603WAF2203T5E; LCSC C22961
R23, R34, R43, R44, R45, R46, R51, R55: 10k; R_0603_1608Metric; MPN 0603WAF1002T5E; LCSC C25804
R24, R27: 33; R_0603_1608Metric; MPN 0603WAF330JT5E; LCSC C23140
R30, R31, R35, R37, R39, R41: 2.2k; R_0603_1608Metric; MPN 0603WAF2201T5E; LCSC C4190
R32: 3.3k; R_0603_1608Metric; MPN 0603WAF3301T5E; LCSC C22978
R33, R49: 4.7k; R_0603_1608Metric; MPN 0603WAF4701T5E; LCSC C23162
R50, R54: 0.1; R_1206_3216Metric; MPN 1206W4F100LT5E; LCSC C25334
SW1: BOOT; SW_SPST_TS-1088-xR020; MPN TS-1088-AR02016; LCSC C720477
SW2: SPELL; SW_SPST_TS-1088-xR020; MPN TS-1088-AR02016; LCSC C720477
SW3: SOUND; SW_SPDT_Shouhan_MSK12C02; MPN MSK12C02; LCSC C431540
TP1: +12V; TestPoint_Pad_D1.5mm
TP2: +4.8V; TestPoint_Pad_D1.5mm
TP3: +3V3; TestPoint_Pad_D1.0mm
TP4: VSYS; TestPoint_Pad_D1.0mm
TP5: +1V1; TestPoint_Pad_D1.0mm
TP6: VBUS; TestPoint_Pad_D1.0mm
U1: TPS54302; SOT-23-6; MPN TPS54302DDCR; LCSC C311983
U2: XC6206 3.3V; SOT-23; MPN XC6206P332MR-G; LCSC C5446
U3: LP5036; VQFN-46-1EP_5x6mm_P0.4mm_EP2.8x3.8mm; MPN LP5036RJVR; LCSC C701961
U4: RP2354A; RP2350A_QFN-60_7x7mm_P0.4mm_RPi; MPN RP2354A; LCSC C41378174
U5, U6, U7, U8: DRV8874; HTSSOP-16-1EP_4.4x5mm_P0.65mm_EP3.55x2.46mm_TI_PWP0016J; MPN DRV8874PWPR; LCSC C1855818
U9, U10: UCC27524; SOIC-8_3.9x4.9mm_P1.27mm; MPN UCC27524DR; LCSC C465729
U11: 74HC4051; TSSOP-16_4.4x5mm_P0.65mm; MPN 74HC4051PW,118; LCSC C5645
U12, U13: 74LVC1G14; SOT-23-5; MPN SN74LVC1G14DBVR; LCSC C7835
U14: NS4150B; MSOP-8_3x3mm_P0.65mm; MPN NS4150B; LCSC C189961
U15: LSM6DS3TR-C; Bosch_LGA-14_3x2.5mm_P0.5mm; MPN LSM6DS3TR-C; LCSC C967633
U16: LTR-303ALS; Lite-On_LTR-303ALS-01; MPN LTR-303ALS-01; LCSC C364577
U17: TMAG5273A2; SOT-23-6; MPN TMAG5273A2QDBVR; LCSC C3715882
U18: OPA2333; SOIC-8_3.9x4.9mm_P1.27mm; MPN OPA2333AIDR; LCSC C38732
Y1: 12MHz; Crystal_SMD_3225-4Pin_3.2x2.5mm; MPN ABM8-272-T3; LCSC C20625731

Connections:
+1V1: C12.1, C13.1, C14.1, C15.1, L2.1, TP5.1, U4.6 (DVDD), U4.23 (DVDD), U4.39 (DVDD), U4.50 (VREG_FB)
+3V3: C9.1, C11.1, C16.1, C17.1, C18.1, C19.1, C20.1, C21.1, C22.1, C23.1, C24.1, C35.1, C37.1, C39.1, C40.1, C42.1, C43.1, C44.1, C45.1, C66.1, C71.1, J3.2, R6.1, R30.1, R31.1, R34.1, TP3.1, U2.2 (VO), U3.40 (VCC), U3.43 (EN), U4.1 (IOVDD), U4.11 (IOVDD), U4.20 (IOVDD), U4.30 (IOVDD), U4.38 (IOVDD), U4.44 (ADC_AVDD), U4.45 (IOVDD), U4.49 (VREG_VIN), U4.53 (USB_OTP_VDD), U4.54 (QSPI_IOVDD), U5.5 (VREF), U5.16 (PMODE), U6.5 (VREF), U6.16 (PMODE), U7.5 (VREF), U7.16 (PMODE), U8.5 (VREF), U8.16 (PMODE), U11.16 (VCC), U12.5 (VCC), U13.5 (VCC), U15.5 (VDDIO), U15.8 (VDD), U15.12 (CS), U16.1 (VDD), U17.4 (VCC), U18.8 (V+)
+5V: C6.1, C7.1, C32.1, C33.1, C67.1, C68.1, C72.1, C73.1, D3.2 (A), D7.1 (A), D7.2 (A), D7.3 (A), D8.1 (A), D8.2 (A), D8.3 (A), D9.2 (A), D10.2 (A), D11.2 (A), D12.2 (A), D13.2 (A), D14.2 (A), D15.2 (A), D16.2 (A), D17.2 (A), D18.2 (A), D19.2 (A), D20.2 (A), D21.2 (A), D22.2 (A), D23.2 (A), D24.2 (A), D25.2 (A), D26.2 (A), D27.2 (A), D28.2 (A), D29.2 (A), D30.2 (A), D31.2 (A), D32.1 (A), D32.2 (A), D32.3 (A), D33.2 (A), D34.2 (A), D35.2 (A), D36.2 (A), D37.2 (A), J3.4, L1.2, R4.1, R45.1, SW3.1 (A), TP2.1, U9.6 (VDD), U10.6 (VDD), U14.6 (VCC)
+12V: C1.1, C2.1, C3.1, C4.1, C47.2, C48.1, C49.1, C52.2, C53.1, C54.1, C57.2, C58.1, C59.1, C62.2, C63.1, C64.1, D1.1 (K), D2.1 (K), Q1.1 (S), Q1.2 (S), Q1.3 (S), R2.1, R47.1, TP1.1, U1.3 (VIN), U5.11 (VM), U6.11 (VM), U7.11 (VM), U8.11 (VM)
/Base/AUDIO: R18.2, U4.12 (GPIO8)
/Base/BUTTON: R17.2, U4.29 (GPIO18)
/Base/CATRING0: D34.1 (K), U3.33 (OUT32)
/Base/CATRING1: D35.1 (K), U3.34 (OUT33)
/Base/CATRING2: D28.1 (K), U3.27 (OUT26)
/Base/CAT_A: C74.1, U10.7 (OUTA)
/Base/CAT_B: L7.2, U10.5 (OUTB)
/Base/CAT_C: C74.2, L7.1
/Base/DRV_nFAULT: R34.2, U4.34 (GPIO22), U5.4 (~FAULT), U6.4 (~FAULT), U7.4 (~FAULT), U8.4 (~FAULT)
/Base/DRV_nSLEEP: R33.1, U4.31 (GPIO19), U5.3 (~SLEEP), U6.3 (~SLEEP), U7.3 (~SLEEP), U8.3 (~SLEEP)
/Base/FAM1_A: U4.7 (GPIO4), U9.2 (INA)
/Base/FAM1_B: U4.8 (GPIO5), U9.4 (INB)
/Base/FAM1_IAVG: C70.1, R51.2, U18.3 (+)
/Base/FAM1_ISENSE: R52.2, U11.13 (A0), U18.1
/Base/FAM2_A: U4.18 (GPIO14), U10.2 (INA)
/Base/FAM2_B: U4.19 (GPIO15), U10.4 (INB)
/Base/FAM2_IAVG: C75.1, R55.2, U18.5 (+)
/Base/FAM2_ISENSE: R56.2, U11.12 (A3), U18.7
/Base/FAM_EN: R49.1, U4.35 (GPIO23), U9.1 (ENA), U9.8 (ENB), U10.1 (ENA), U10.8 (ENB)
/Base/GHOST: AE2.1, D6.1 (K), R29.1
/Base/HALL: J3.1, U4.41 (GPIO27/ADC1)
/Base/IMU_INT: U4.3 (GPIO1), U15.4 (INT1)
/Base/LEV_A: J3.14, J3.16, U8.8 (OUT1)
/Base/LEV_B: J3.8, J3.10, U8.10 (OUT2)
/Base/LEV_IN1: U4.16 (GPIO12), U8.1 (IN1)
/Base/LEV_IN2: U4.17 (GPIO13), U8.2 (IN2)
/Base/LEV_IPROPI: C50.1, R36.2, U4.42 (GPIO28/ADC2)
/Base/MOON: AE1.1, D5.1 (K), R26.1
/Base/MUX_OUT: U4.43 (GPIO29/ADC3), U11.3 (A)
/Base/MUX_S0: U4.36 (GPIO24), U11.11 (S0)
/Base/MUX_S1: U4.37 (GPIO25), U11.10 (S1)
/Base/MUX_S2: U4.40 (GPIO26/ADC0), U11.9 (S2)
/Base/OWLRING0: D12.1 (K), U3.6 (OUT5)
/Base/OWLRING1: D18.1 (K), U3.12 (OUT11)
/Base/OWLRING2: D14.1 (K), U3.8 (OUT7)
/Base/OWL_A: C69.1, U9.7 (OUTA)
/Base/OWL_B: L6.2, U9.5 (OUTB)
/Base/OWL_C: C69.2, L6.1
/Base/PEND1_A: L3.1, U5.8 (OUT1)
/Base/PEND1_B: L3.2, U5.10 (OUT2)
/Base/PEND1_IN1: U4.9 (GPIO6), U5.1 (IN1)
/Base/PEND1_IN2: U4.10 (GPIO7), U5.2 (IN2)
/Base/PEND1_IPROPI: C55.1, R38.2, U11.4 (A7)
/Base/PEND2_A: L4.1, U6.8 (OUT1)
/Base/PEND2_B: L4.2, U6.10 (OUT2)
/Base/PEND2_IN1: U4.4 (GPIO2), U6.1 (IN1)
/Base/PEND2_IN2: U4.5 (GPIO3), U6.2 (IN2)
/Base/PEND2_IPROPI: C60.1, R40.2, U11.5 (A5)
/Base/PEND3_A: L5.1, U7.8 (OUT1)
/Base/PEND3_B: L5.2, U7.10 (OUT2)
/Base/PEND3_IN1: U4.14 (GPIO10), U7.1 (IN1)
/Base/PEND3_IN2: U4.15 (GPIO11), U7.2 (IN2)
/Base/PEND3_IPROPI: C65.1, R42.2, U11.15 (A2)
/Base/PUMPKIN0: D8.4 (K), D8.5 (K), D8.6 (K), U3.2 (OUT1)
/Base/PUMPKIN1: D7.4 (K), D7.5 (K), D7.6 (K), U3.1 (OUT0)
/Base/PUMPKIN2: D32.4 (K), D32.5 (K), D32.6 (K), U3.31 (OUT30)
/Base/QSPI_SS: R14.2, U4.60 (~QSPI_SS)
/Base/SCL: J3.5, R30.2, U3.42 (SCL), U4.33 (GPIO21), U15.13 (SCL), U16.4 (SCL), U17.1 (SCL)
/Base/SDA: J3.3, R31.2, U3.41 (SDA), U4.32 (GPIO20), U15.14 (SDA), U16.6 (SDA), U17.6 (SDA)
/Base/STAR0: D17.1 (K), U3.11 (OUT10)
/Base/STAR1: D16.1 (K), U3.10 (OUT9)
/Base/STAR2: D15.1 (K), U3.9 (OUT8)
/Base/STAR3: D13.1 (K), U3.7 (OUT6)
/Base/STAR4: D37.1 (K), U3.36 (OUT35)
/Base/STAR5: D36.1 (K), U3.35 (OUT34)
/Base/STAR6: D29.1 (K), U3.28 (OUT27)
/Base/STAR7: D24.1 (K), U3.23 (OUT22)
/Base/STAR8: D23.1 (K), U3.22 (OUT21)
/Base/STAR9: D25.1 (K), U3.24 (OUT23)
/Base/STAR10: D26.1 (K), U3.25 (OUT24)
/Base/STAR11: D27.1 (K), U3.26 (OUT25)
/Base/STARX0: D20.1 (K), U3.14 (OUT13)
/Base/STARX1: D21.1 (K), U3.20 (OUT19)
/Base/STARX2: D19.1 (K), U3.13 (OUT12)
/Base/STARX3: D22.1 (K), U3.21 (OUT20)
/Base/SWCLK: R12.2, U4.24 (SWCLK)
/Base/SWDIO: R13.2, U4.25 (SWDIO)
/Base/THEREMIN_PITCH: R24.2, U4.2 (GPIO0)
/Base/THEREMIN_VOL: R27.2, U4.13 (GPIO9)
/Base/UART_RX: R15.2, U4.28 (GPIO17)
/Base/UART_TX: R16.2, U4.27 (GPIO16)
/Base/USB_D+: J2.A6 (D+), J2.B6 (D+), R8.1
/Base/USB_D-: J2.A7 (D-), J2.B7 (D-), R7.1
/Base/USB_DM: R7.2, U4.51 (USB_DM)
/Base/USB_DP: R8.2, U4.52 (USB_DP)
/Base/V5_SENSE: R45.2, R46.1, U11.1 (A4)
/Base/V12_SENSE: R47.2, R48.1, U11.2 (A6)
/Base/VBUS_SENSE: R43.2, R44.1, U11.14 (A1)
/Base/WISP0: D10.1 (K), U3.4 (OUT3)
/Base/WISP1: D9.1 (K), U3.3 (OUT2)
/Base/WISP2: D11.1 (K), U3.5 (OUT4)
/Base/WISP3: D33.1 (K), U3.32 (OUT31)
/Base/WISP4: D31.1 (K), U3.30 (OUT29)
/Base/WISP5: D30.1 (K), U3.29 (OUT28)
/Base/XIN: C26.2, U4.21 (XIN), Y1.1
/Base/XOUT: R11.2, U4.22 (XOUT)
GND: C1.2, C2.2, C3.2, C4.2, C6.2, C7.2, C8.2, C9.2, C10.2, C11.2, C12.2, C13.2, C14.2, C15.2, C16.2, C17.2, C18.2, C19.2, C20.2, C21.2, C22.2, C23.2, C24.2, C25.2, C26.1, C27.1, C29.2, C30.2, C31.2, C32.2, C33.2, C34.2, C35.2, C36.2, C37.2, C38.2, C39.2, C40.2, C41.2, C42.2, C43.2, C44.2, C45.2, C48.2, C49.2, C50.2, C53.2, C54.2, C55.2, C58.2, C59.2, C60.2, C63.2, C64.2, C65.2, C66.2, C67.2, C68.2, C70.2, C71.2, C72.2, C73.2, C75.2, D2.2 (A), D5.2 (A), D6.2 (A), J1.2, J1.3, J2.A1 (GND), J2.A12 (GND), J2.B1 (GND), J2.B12 (GND), J2.SH (SHIELD), J3.6, J3.7, J3.9, J3.11, J3.12, J3.13, J3.15, J4.2 (GND), J4.MP, J5.2 (GND), J5.MP, R1.2, R3.2, R5.2, R9.2, R10.2, R22.2, R32.2, R33.2, R35.2, R37.2, R39.2, R41.2, R44.2, R46.2, R48.2, R49.2, R50.2, R53.2, R54.2, R57.2, SW1.1, SW2.1, SW3.3 (C), U1.1 (GND), U2.1 (GND), U3.37 (GND), U3.38 (ADDR0), U3.39 (ADDR1), U3.46 (GND), U3.47 (GND), U4.47 (VREG_PGND), U4.61 (GND), U5.7 (IMODE), U5.9 (PGND), U5.15 (GND), U5.17 (PAD), U6.7 (IMODE), U6.9 (PGND), U6.15 (GND), U6.17 (PAD), U7.7 (IMODE), U7.9 (PGND), U7.15 (GND), U7.17 (PAD), U8.7 (IMODE), U8.9 (PGND), U8.15 (GND), U8.17 (PAD), U11.6 (~E), U11.7 (VEE), U11.8 (GND), U12.3 (GND), U13.3 (GND), U14.7 (GND), U15.1 (SDO/SA0), U15.2 (SDx), U15.3 (SCx), U15.6 (GND), U15.7 (GND), U16.3 (GND), U17.2 (GND), U17.3 (TEST), U18.4 (V-), Y1.2 (G), Y1.4 (G)
unnamed: C27.2, R11.1, Y1.3
unnamed: C28.1, R20.2
unnamed: C28.2, C30.1, R19.1
unnamed: C29.1, R18.1, R19.2
unnamed: C31.1, R21.2
unnamed: C36.1, R25.1, R26.2, U12.2
unnamed: C38.1, R28.1, R29.2, U13.2
unnamed: D1.2 (A), Q1.4 (G), R1.1
unnamed: F1.1, J1.1
unnamed: F1.2, Q1.5 (D), Q1.6 (D), Q1.7 (D), Q1.8 (D)
unnamed: J2.A5 (CC1), R10.1
unnamed: J2.B5 (CC2), R9.1
unnamed: J4.1 (SWCLK), R12.1
unnamed: J4.3 (SWDIO), R13.1
unnamed: J5.1 (RX), R15.1
unnamed: J5.3 (TX), R16.1
unnamed: R14.1, SW1.2
unnamed: R17.1, SW2.2
unnamed: R24.1, R25.2, U12.4
unnamed: R27.1, R28.2, U13.4
unnamed: R23.2, SW3.2 (B)
unnamed: C5.1, U1.6 (BOOT)
unnamed: R2.2, R3.1, U1.5 (EN)
unnamed: R4.2, R5.1, U1.4 (FB)
unnamed: C5.2, L1.1, U1.2 (SW)
unnamed: R32.1, U3.44 (IREF)
unnamed: C41.1, U3.45 (VCAP)
unnamed: C10.1, R6.2, U4.46 (VREG_AVDD)
unnamed: L2.2, U4.48 (VREG_LX)
unnamed: C51.1, U5.13 (CPH)
unnamed: C51.2, U5.14 (CPL)
unnamed: R37.1, R38.1, U5.6 (IPROPI)
unnamed: C52.1, U5.12 (VCP)
unnamed: C56.1, U6.13 (CPH)
unnamed: C56.2, U6.14 (CPL)
unnamed: R39.1, R40.1, U6.6 (IPROPI)
unnamed: C57.1, U6.12 (VCP)
unnamed: C61.1, U7.13 (CPH)
unnamed: C61.2, U7.14 (CPL)
unnamed: R41.1, R42.1, U7.6 (IPROPI)
unnamed: C62.1, U7.12 (VCP)
unnamed: C46.1, U8.13 (CPH)
unnamed: C46.2, U8.14 (CPL)
unnamed: R35.1, R36.1, U8.6 (IPROPI)
unnamed: C47.1, U8.12 (VCP)
unnamed: R50.1, R51.1, U9.3 (GND)
unnamed: R54.1, R55.1, U10.3 (GND)
unnamed: C34.1, U14.2 (BYPASS)
unnamed: R22.1, R23.1, U14.1 (CTRL)
unnamed: R21.1, U14.4 (INN)
unnamed: R20.1, U14.3 (INP)
unnamed: LS1.2, U14.5 (VON)
unnamed: LS1.1, U14.8 (VOP)
unnamed: R52.1, R53.1, U18.2 (-)
unnamed: R56.1, R57.1, U18.6 (-)
VBUS: C25.1, D4.2 (A), J2.A4 (VBUS), J2.A9 (VBUS), J2.B4 (VBUS), J2.B9 (VBUS), R43.1, TP6.1
VSYS: C8.1, D3.1 (K), D4.1 (K), TP4.1, U2.3 (VI)

Notes on the sheet:
OWLternating Current: the base board
12 V IN
12 V, 3-5 A adapter (5.5 x 2.1 mm plug, centre positive; ORDER_LIST.md). F1 resets itself after a short: it holds 3 A and trips by 6 A, which a 3-5 A brick can deliver (the board draws 1.5 A at most on average), and it is rated 24 V, the TVS's clamp. Q1 conducts only when the plug is the right way 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
4.8 V BUCK
U1, TPS54302: 12 V to 4.8 V, 3 A, 400 kHz. 4.8 V, not 5: 0.596 V x (1 + 36k/5.1k) = 4.80 V from a Preferred and a Basic resistor, and it keeps the audio amplifier (5.25 V absolute maximum) clear of its limit. The rail is called +5V; it runs the LEDs, the perch drivers, the audio amplifier and the t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
VSYS AND 3.3 V
VSYS is 4.8 V less a Schottky drop, or USB's 5 V less one: so the RP2354A, the sensors and the LED drivers' logic run from USB alone (to program the board without the adapter), while USB never feeds the 4.8 V rail and its loads. U2, XC6206: 3.3 V, 200 mA, stable with ceramic capacitors; the logic d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
Core regulator (1.1 V): Raspberry Pi's parts and layout, copied exactly (gen/rpi_minimal), as on GPiBridge. L2 is polarity-marked: its dot must sit as their footprint shows.
3.3 V and 1.1 V: one 100 nF at every supply pin. ADC_AVDD shares the 3.3 V: the ADC reads currents and a Hall sensor to 1 %, not microvolts.
USB 2.0 full speed, 12 Mbit/s. 27 R at the chip (RP2350 datasheet).
CC1, CC2: 5.1 k to ground say 'device'; the host then gives 5 V.
USB-C: programming and the console. It powers the logic (about 110 mA), never the LEDs or coils.
ABM8-272-T3, 12 MHz, 10 pF load: the crystal Raspberry Pi specifies, with their 15 pF loads and the 1 k that limits its drive.
Raspberry Pi debug connector (JST- SH 3-pin): the Debug Probe's 'D' cable. 100 R in each line, at the connector. 3.3 V logic.
BOOT: hold it while plugging in to start the RP2354A's USB bootloader. Rarely needed: 'picotool reboot -f -u' gets there from software. RUN stays open: it has its own pull-up inside the RP2354A, and the Debug Probe resets the chip over SWD.
The 2 MB flash is inside the RP2354A; these stay open.
UART0 console, 115200 baud: the Debug Probe's 'U' cable. Works when USB does not.
AUDIO
AUDIO is PWM at about 150 kHz. Two RC stages (1k, 10n: 16 kHz each) leave the tone and take the carrier down 38 dB; 22n and 220k pass 33 Hz and up. U14, NS4150B: class D, gain 240k/220k = 1.1. Full scale is about 0.2 W in the 8 ohm, 23 mm speaker (78 dB at a metre), a bedroom's worth and under a to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
THEREMIN
Each oscillator: a 74LVC1G14 with 100k feedback; its capacitor is 15 pF plus a gold copper shape (the moon, the ghost: their pads AE1 and AE2), about 500 kHz. A hand 10 cm away adds a fraction of a picofarad and lowers the frequency by a few kHz; the RP2354A's PIO counts each for 10 ms (100 Hz reso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
I2C at 400 kHz, 3.3 V, 2.2k pull-ups; on it: U3 (LP5036, 0x30), the tree's LP5036 (0x32, through the socket), U15 (LSM6DS3TR-C, 0x6A: taps and tilt), U16 (LTR-303, 0x29: the owls wake at dusk), U17 (TMAG5273A2, 0x35: times the pendulum's kicks). Interrupts the firmware does not use stay open.
U3, LP5036: 36 current sinks, 12-bit PWM at 29 kHz (no flicker a camera or an eye can see), in 12 banks of 3 that share a brightness. R3K3 on IREF sets the most any output can sink: 105 x 0.7 V / 3.3k = 22 mA, under every LED's 30 mA, whatever the firmware asks. The LEDs' anodes are on 4.8 V; the n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
U8, U5-U7: DRV8874 H-bridges from 12 V. PMODE high: PWM mode (IN1 and IN2 drive the bridge; both low: coast). IMODE to ground: fixed off-time chopping at ITRIP = 3.3 V / (450 uA/A x 2.2k) = 3.3 A, so no coil ever carries more. IPROPI mirrors the low-side current, 450 uA per amp: 2.2k makes 1 V per 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
U8 drives the levitation coil on the perch (LEV_A, LEV_B: up the right edge to the tree's socket). L3-L5: the pendulum coils under the bat's swing, about 12 turns on each of 4 layers, 33 uH, 2.3 ohm (copper on this board, gen/coils.py).
J3: the tree stands here (its right-angle header). Pins 8, 10: LEV_B; 14, 16: LEV_A (3.3 A at most, two pins each); 1 HALL; 3 SDA; 5 SCL; 2 3.3 V; 4 4.8 V; the rest ground, between the coil's pins and the signals.
H1-H4: 3.2 mm holes at the corners; the printed feet snap into them.
