gallicchio/OWLternatingCurrent/hardware/OWLternatingCurrent.kicad_pcb

## KiCad design hardware/OWLternatingCurrent.kicad_pcb (continued)

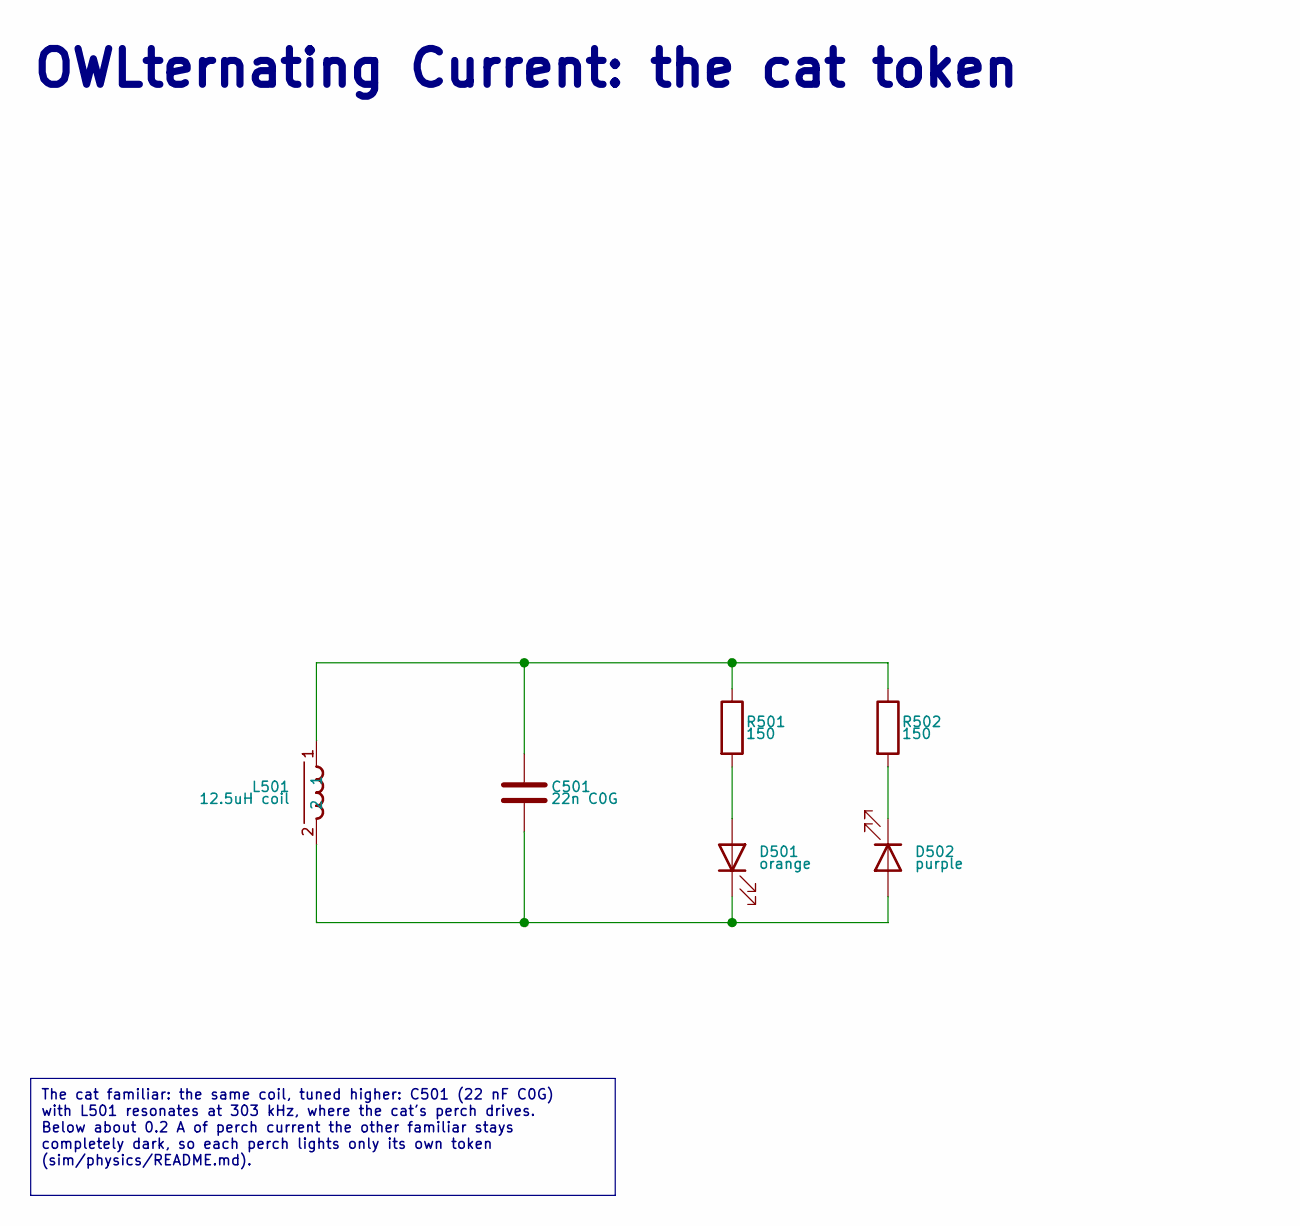
[picture p141: schematic cat_token.kicad_sch, OWLternating Current: cat token]

Parts:
C501: 22n C0G; C_0805_2012Metric; MPN GRM21B5C1H223JA01L; LCSC C77069
D501: orange; LED_0603_1608Metric; MPN XL-1608UOC-06; LCSC C965800
D502: purple; LED_0603_1608Metric; MPN GL0603PU01; LCSC C51933300
L501: 12.5uH coil; Coil_TOKEN; MPN PCB coil
R501, R502: 150; R_0603_1608Metric; MPN 0603WAF1500T5E; LCSC C22808

Connections:
unnamed: C501.1, L501.1, R501.1, R502.1
unnamed: D501.2 (A), R501.2
unnamed: C501.2, D501.1 (K), D502.2 (A), L501.2
unnamed: D502.1 (K), R502.2

Notes on the sheet:
OWLternating Current: the cat token
The cat familiar: the same coil, tuned higher: C501 (22 nF C0G) with L501 resonates at 303 kHz, where the cat's perch drives. Below about 0.2 A of perch current the other familiar stays completely dark, so each perch lights only its own token (sim/physics/README.md).

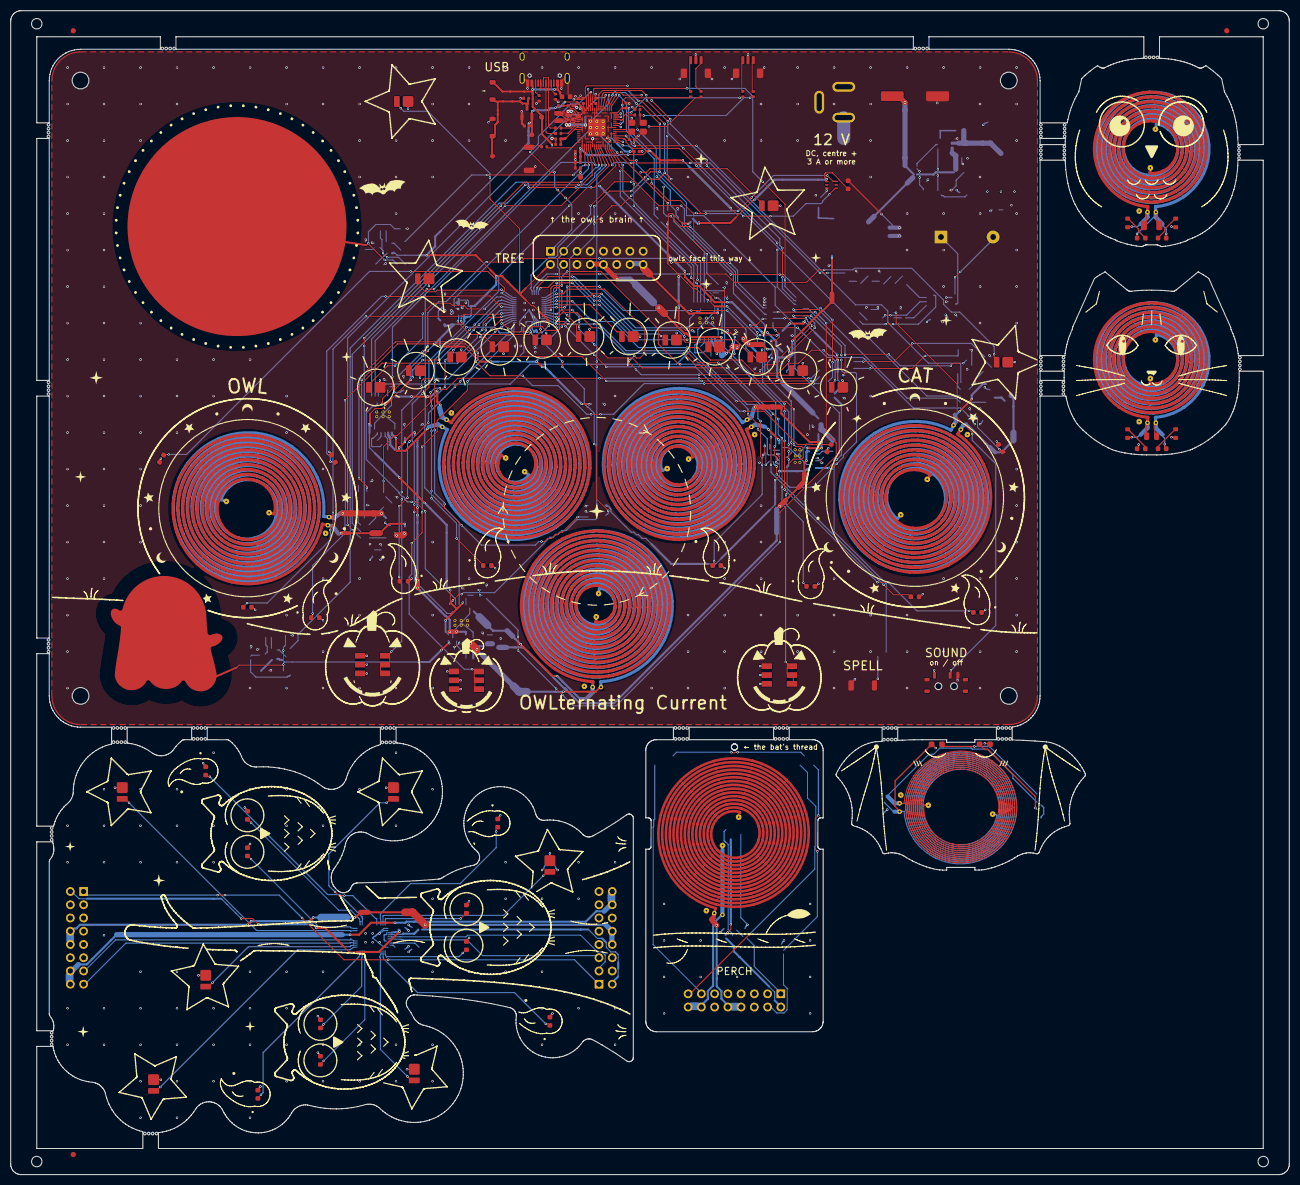
[picture p142: board OWLternatingCurrent.kicad_pcb from above]

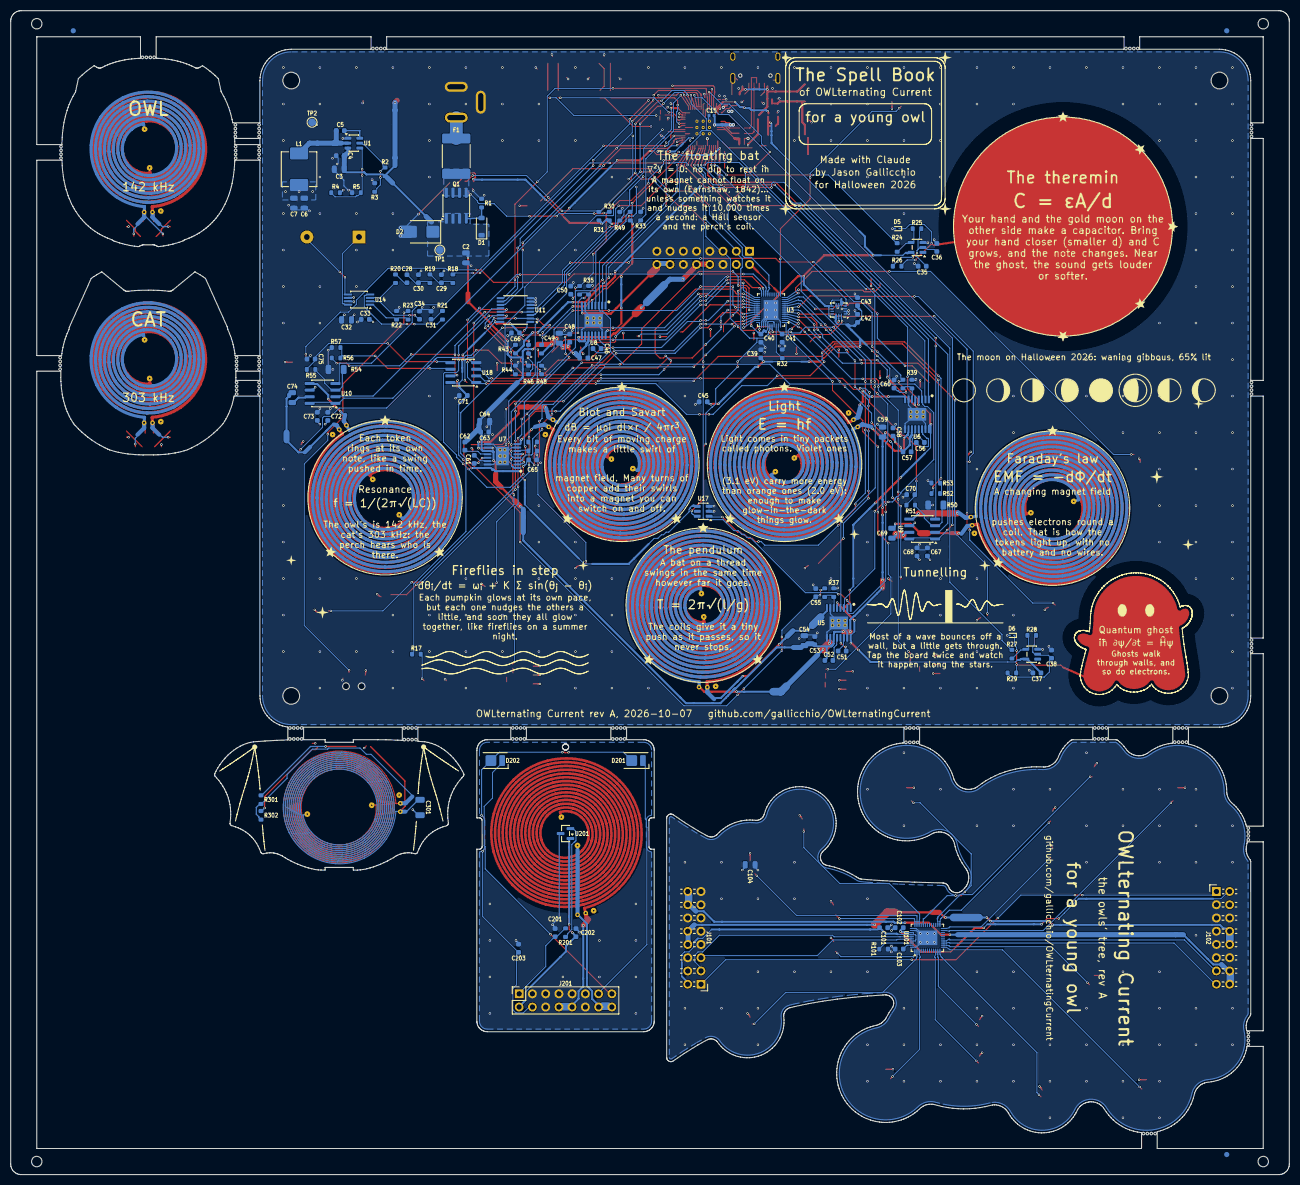
[picture p143: board OWLternatingCurrent.kicad_pcb from below]

Board: 4 copper layers, 245.2 x 223.2 mm, 408 parts (143 on the bottom side), 207 nets.

Other parts of the board:
FID1, FID2, FID3: Fiducial_1mm_Mask2mm
MB1, MB2, MB3, MB4, MB5, MB6, MB7, MB8, MB9, MB10, MB11, MB12, MB13, MB14, MB15, MB16, MB17, MB18, MB19, MB20, MB21, MB22, MB23, MB24, MB25, MB26, MB27, MB28, MB29, MB30, MB31, MB32, MB33, MB34, MB35, MB36, MB37, MB38, MB39, MB40, MB41, MB42, MB43, MB44, MB45, MB46, MB47, MB48, MB49, MB50, MB51, MB52, MB53, MB54, MB55, MB56, MB57, MB58, MB59, MB60, MB61, MB62, MB63, MB64, MB65, MB66, MB67, MB68, MB69, MB70, MB71, MB72, MB73, MB74, MB75, MB76, MB77, MB78, MB79, MB80, MB81, MB82, MB83, MB84, MB85, MB86, MB87, MB88, MB89, MB90, MB91, MB92, MB93, MB94, MB95, MB96, MB97, MB98, MB99, MB100, MB101, MB102, MB103, MB104, MB105, MB106, MB107, MB108, MB109, MB110, MB111, MB112, MB113, MB114, MB115, MB116, MB117, MB118, MB119, MB120, MB121, MB122, MB123, MB124, MB125, MB126, MB127, MB128, MB129, MB130, MB131, MB132: MouseBite_NPTH_0.5mm
TH1, TH2, TH3, TH4: Tooling_NPTH_2mm
