gallicchio/OWLternatingCurrent/gen/art.py

#!/usr/bin/env python3
"""The art and the outlines of every board on the panel, as plain geometry.

    python3 gen/art.py            draw everything, check it, write hardware/art.json and
                                  the previews docs/images/art_<board>_<top|bottom>.png
    python3 gen/art.py --no-png   the JSON and the checks only
    AppRun python3.11 gen/art.py --extract-font
                                  (KiCad's own Python) re-read KiCad's stroke font into
                                  art/kicad_font.json

Drawing needs shapely (system Python).  gen/board.py runs in KiCad's Python, which has
none, so it reads hardware/art.json; the functions below also work there, from that file.

Coordinates are millimetres in each board's own frame (gen/layout.py): x right, y down,
seen from the top (KiCad's view), origin at the board's top-left corner, or at its coil's
centre for the perch, the bat and the tokens.  Angles are degrees.

Boards: "base", "tree", "perch", "bat", "owl_token", "cat_token".

The Python API
--------------
outline(board) -> [polyline, ...]
    Closed polylines [(x, y), ...] for Edge.Cuts (the last point joins the first; it is
    not repeated).  The first is the board's edge; any others are cut-outs (the perch's
    thread hole).  The base's foot holes are footprints (H1-H4), not outlines.
art(board) -> {layer: [item, ...]}
    Layers "F.SilkS", "B.SilkS", "F.Mask" (openings), "F.Cu", "B.Cu" (copper art; none
    yet beyond the antennas below).  Items:
      ("poly", pts)                          a filled polygon, no holes
      ("polyline", pts, width)               a stroked line, round ends
      ("circle", cx, cy, r, width)           a stroked circle
      ("arc", cx, cy, r, a0, a1, width)      a stroked arc from a0 to a1 (a0 < a1), angles
                                             from +x toward +y (clockwise on the screen)
      ("text", s, x, y, height, angle, justify)
          KiCad text in KiCad's stroke font, one line.  (x, y) is the anchor, vertically
          centred (KiCad's default); justify is "left", "center" or "right"; angle is
          counter-clockwise as seen on the screen.  Stroke width: text_thickness(height)
          = max(0.15, 0.15 * height).  "_{...}" and "^{...}" are KiCad's sub- and
          superscript markup.  Text on B.* layers is mirrored (KiCad's back-side text):
          (x, y) is still in the top view's frame, and "left" means the text starts at
          the anchor and reads to the right as seen from below (toward -x in this frame).
antennas() -> [{"net", "copper", "mask_open", "keepout", "pad"}, ...]
    The base's two theremin antennas, "MOON" (pitch) and "GHOST" (volume):
      copper     [polygon, ...]  F.Cu on that net (a zone or filled shapes; pad
                                 connection solid, or thermal spokes would show in the gold)
      mask_open  [polygon, ...]  F.Mask openings: the gold (they leave the craters, the
                                 witch, the ghost's eyes and smile under the mask)
      keepout    polygon         the shape grown by layout.ANTENNA_KEEPOUT: no copper on
                                 any other net or layer, and no parts
      pad        (x, y)          where the antenna part's pad (AE1 for the moon, AE2 for the
                                 ghost; TestPoint_Pad_D1.5mm) goes: inside the shape, flush
                                 with its edge, on the side toward its oscillator
keepouts(board) -> [(polygon, layers, what), ...]
    Areas the board generator must keep parts out of: layers names the side ("F.Cu" no
    top-side parts, "B.Cu" no bottom-side parts); what says why (the spell book's text,
    the printed owl and bat cap).
text_thickness(h), text_width(s, h), text_segments(...)
    KiCad's stroke font, measured: the widths and strokes KiCad draws (to within 1 um).

hardware/art.json (what gen/board.py reads)
-------------------------------------------
{"meta": {...},
 "boards": {"base": {"outline": [[[x, y], ...], ...],
                     "layers": {"F.SilkS": [item, ...], ...},
                     "keepouts": [{"pts": [[x, y], ...], "layers": ["B.Cu"], "what": "..."}]},
            "tree": {...}, ...},
 "antennas": [{"net": "MOON", "copper": [[[x, y], ...]], "mask_open": [[[x, y], ...], ...],
               "keepout": [[x, y], ...], "pad": [x, y]}, ...]}
with items
  {"kind": "poly", "pts": [[x, y], ...]}
  {"kind": "polyline", "pts": [[x, y], ...], "width": w}
  {"kind": "circle", "c": [x, y], "r": r, "width": w}
  {"kind": "arc", "c": [x, y], "r": r, "a0": a0, "a1": a1, "width": w,
                  "start": [x, y], "mid": [x, y], "end": [x, y]}
  {"kind": "text", "s": "...", "at": [x, y], "h": h, "angle": a, "justify": "center",
                   "thickness": t, "mirror": false}
Everything is already flat (polylines and polygons, no curves) and in each board's own
frame.  meta.inputs_sha256 hashes the files the art is drawn from; when gen/layout.py,
gen/placement.py, gen/mech.py or gen/board_info.py change, run this again (stale() says).

Rules the art keeps (CLAUDE_PCB.md sections 6 and 16, JLCPCB): silk text at least 1.0 mm
high, strokes at least 0.15 mm; silk 0.5 mm inside the edge and 0.3 mm from mask
openings and pads; mask openings and the mask between them at least 0.3 mm across; art
clear of every part's courtyard (gen/placement.py places them; the footprints are
hardware/lib's), of the star LEDs by 3 mm, the small LEDs by 1.75 mm, the pumpkins' 5050s
by 4.2 mm and the feet by 5.5 mm.  Coils take only thin lines on top; the spell book
lies inside the coils and antennas underneath and in patches kept free of parts.
"""
import hashlib, json, math, os, subprocess, sys
from collections import defaultdict

HERE = os.path.dirname(os.path.abspath(__file__))
ROOT = os.path.dirname(HERE)
sys.path.insert(0, HERE)
import layout as L
import mech as M
import board_info as BI

BOARDS = ("base", "tree", "perch", "bat", "owl_token", "cat_token")
FONT_JSON = os.path.join(ROOT, "art", "kicad_font.json")
ART_JSON = os.path.join(ROOT, "hardware", "art.json")
IMAGES = os.path.join(ROOT, "docs", "images")
INPUTS = [os.path.join(HERE, f) for f in ("art.py", "layout.py", "placement.py", "mech.py", "board_info.py")] + \
         [os.path.join(ROOT, "art", "shapes.py"), FONT_JSON, os.path.join(ROOT, "hardware", "checks", "netlist.net")]

try:
    from shapely.geometry import Polygon, Point, LineString, MultiPolygon, MultiPoint, GeometryCollection, box
    from shapely.ops import unary_union, linemerge
    from shapely import affinity
    HAVE_SHAPELY = True
except ImportError:                      # KiCad's Python: serve hardware/art.json
    HAVE_SHAPELY = False


# ======================================================================================
# Text: KiCad's own stroke font, so that sizes and widths here are what KiCad draws
# ======================================================================================
_FONT = None


def font():
    global _FONT
    if _FONT is None:
        with open(FONT_JSON, encoding="utf-8") as f:
            _FONT = json.load(f)
    return _FONT


def tank_khz(who):
    """A token's resonance from its coil and its capacitor (gen/parts.py, the schematic's
    choice of C401 and C501), rounded to the kHz."""
    import re
    from parts import PARTS

    def si(v):
        m = re.match(r"([\d.]+)\s*([pnum]?)", v)
        return float(m.group(1)) * {"p": 1e-12, "n": 1e-9, "u": 1e-6, "m": 1e-3, "": 1.0}[m.group(2)]
    l = si(PARTS["COIL_TOKEN"]["value"])
    c = si(PARTS["C100N_C0G" if who == "owl" else "C22N_C0G"]["value"])
    return int(round(1.0 / (2 * math.pi * math.sqrt(l * c)) / 1e3))


def text_thickness(h):
    """The stroke width of silkscreen text h mm high (board.py uses the same rule)."""
    return round(max(0.15, 0.15 * h), 3)


def _runs(s):
    """KiCad markup: '_{...}' is a subscript, '^{...}' a superscript."""
    out, buf, i = [], "", 0
    while i < len(s):
        if s[i] in "_^" and s[i + 1:i + 2] == "{":
            j = s.find("}", i + 2)
            if j > 0:
                if buf:
                    out.append((buf, ""))
                    buf = ""
                out.append((s[i + 2:j], "sub" if s[i] == "_" else "sup"))
                i = j + 1
                continue
        buf += s[i]
        i += 1
    if buf:
        out.append((buf, ""))
    return out


def _glyph(c):
    g = font()["glyphs"].get(c)
    if g is None:
        raise ValueError("KiCad's stroke font has no glyph for %r" % c)
    return g


def text_width(s, h):
    """The line width KiCad justifies by: the sum of the glyphs' advances."""
    meta = font()["meta"]
    w = 0.0
    for run, style in _runs(s):
        k = meta[style]["scale"] if style else 1.0
        w += sum(_glyph(c)["adv"] for c in run) * k * h
    return w


def text_segments(s, x, y, h, angle=0.0, justify="center", mirror=False, th=None):
    """The stroke centre-lines KiCad draws for one line of text: [((x0, y0), (x1, y1))].
    Checked against pcbnew (KiCad 10.0.6): within 1 um, rotated, mirrored, with
    sub- and superscripts."""
    meta = font()["meta"]
    th = text_thickness(h) if th is None else th
    W = text_width(s, h)
    pen = {"left": meta["x_th"] * th, "center": -W / 2, "right": -(W + meta["x_th"] * th)}[justify]
    a = math.radians(angle)
    ca, sa = math.cos(a), math.sin(a)
    segs = []
    for run, style in _runs(s):
        k = meta[style]["scale"] if style else 1.0
        dy0 = meta[style]["dy"] if style else 0.0
        for c in run:
            g = _glyph(c)
            for (gx0, gy0, gx1, gy1) in g["s"]:
                pts = []
                for gx, gy in ((gx0, gy0), (gx1, gy1)):
                    dx = pen + k * gx * h
                    dy = (k * gy + dy0) * h + meta["y_th"] * th
                    if mirror:
                        dx = -dx
                    pts.append((x + dx * ca + dy * sa, y - dx * sa + dy * ca))
                segs.append(tuple(pts))
            pen += g["adv"] * k * h
    return segs


# ======================================================================================
# The API
# ======================================================================================
_DATA = None


def inputs_sha():
    h = hashlib.sha256()
    for p in INPUTS:
        if os.path.exists(p):
            h.update(os.path.basename(p).encode())
            h.update(open(p, "rb").read())
    return h.hexdigest()


def stale():
    """True when hardware/art.json is missing or older than what it is drawn from."""
    try:
        with open(ART_JSON, encoding="utf-8") as f:
            return json.load(f)["meta"]["inputs_sha256"] != inputs_sha()
    except (OSError, ValueError, KeyError):
        return True


class ArtUnavailable(ImportError):
    """No shapely here and no hardware/art.json yet (an ImportError, so that a caller
    that falls back when the art module is missing falls back here too)."""


def _data():
    global _DATA
    if _DATA is None:
        if HAVE_SHAPELY and stale():
            _DATA = build()
        else:
            if not os.path.exists(ART_JSON):
                raise ArtUnavailable("hardware/art.json is missing: run python3 gen/art.py (it needs shapely)")
            with open(ART_JSON, encoding="utf-8") as f:
                _DATA = json.load(f)
            if stale():
                sys.stderr.write("art: hardware/art.json is older than its inputs; run python3 gen/art.py\n")
    return _DATA


def _pts(p):
    return [tuple(q) for q in p]


def _item_tuple(it):
    k = it["kind"]
    if k == "poly":
        return ("poly", _pts(it["pts"]))
    if k == "polyline":
        return ("polyline", _pts(it["pts"]), it["width"])
    if k == "circle":
        return ("circle", it["c"][0], it["c"][1], it["r"], it["width"])
    if k == "arc":
        return ("arc", it["c"][0], it["c"][1], it["r"], it["a0"], it["a1"], it["width"])
    if k == "text":
        return ("text", it["s"], it["at"][0], it["at"][1], it["h"], it["angle"], it["justify"])
    raise ValueError(k)


def outline(board):
    return [_pts(p) for p in _data()["boards"][board]["outline"]]


def art(board):
    return {lay: [_item_tuple(it) for it in items] for lay, items in _data()["boards"][board]["layers"].items()}


def antennas():
    return [{"net": a["net"], "copper": [_pts(p) for p in a["copper"]], "mask_open": [_pts(p) for p in a["mask_open"]],
             "keepout": _pts(a["keepout"]), "pad": tuple(a["pad"])} for a in _data()["antennas"]]


def keepouts(board):
    return [(_pts(k["pts"]), tuple(k["layers"]), k["what"]) for k in _data()["boards"][board]["keepouts"]]


# ======================================================================================
# Geometry (shapely; the board's frame: x right, y down, millimetres)
# ======================================================================================
def polys(g):
    """The polygons in any geometry."""
    if g is None or g.is_empty:
        return []
    if isinstance(g, Polygon):
        return [g]
    out = []
    for h in getattr(g, "geoms", []):
        out += polys(h)
    return out


def lines(g):
    if g is None or g.is_empty:
        return []
    if isinstance(g, LineString):
        return [g]
    out = []
    for h in getattr(g, "geoms", []):
        out += lines(h)
    return out


def U(*gs):
    flat = []
    for g in gs:
        if isinstance(g, (list, tuple)):
            flat += [h for h in g if h is not None]
        elif g is not None:
            flat.append(g)
    return unary_union(flat) if flat else GeometryCollection()


def circle(cx, cy, r, n=None):
    n = n or max(32, int(2 * math.pi * r / 0.25))
    return Polygon([(cx + r * math.cos(2 * math.pi * k / n), cy + r * math.sin(2 * math.pi * k / n)) for k in range(n)])


def ellipse(cx, cy, rx, ry, angle=0.0, n=96):
    p = Polygon([(cx + rx * math.cos(2 * math.pi * k / n), cy + ry * math.sin(2 * math.pi * k / n)) for k in range(n)])
    return affinity.rotate(p, angle, origin=(cx, cy)) if angle else p


def superellipse(cx, cy, a, b, n=2.5, k=180):
    pts = []
    for i in range(k):
        t = 2 * math.pi * i / k
        c, s = math.cos(t), math.sin(t)
        pts.append((cx + a * math.copysign(abs(c) ** (2 / n), c), cy + b * math.copysign(abs(s) ** (2 / n), s)))
    return Polygon(pts)


def arc_pts(cx, cy, r, a0, a1, n=None):
    """Points on an arc; degrees from +x toward +y (clockwise on the screen)."""
    n = n or max(4, int(abs(a1 - a0) / 360 * 2 * math.pi * r / 0.3))
    return [(cx + r * math.cos(math.radians(a0 + (a1 - a0) * k / n)),
             cy + r * math.sin(math.radians(a0 + (a1 - a0) * k / n))) for k in range(n + 1)]


def bez(p0, p1, p2, p3, n=24):
    out = []
    for i in range(n + 1):
        t = i / n
        a, b, c, d = (1 - t) ** 3, 3 * (1 - t) ** 2 * t, 3 * (1 - t) * t ** 2, t ** 3
        out.append((a * p0[0] + b * p1[0] + c * p2[0] + d * p3[0], a * p0[1] + b * p1[1] + c * p2[1] + d * p3[1]))
    return out


def chain(*segs):
    """Join point lists, dropping each joint's repeated point."""
    out = []
    for s in segs:
        s = list(s)
        if not s:
            continue
        out += s if not out else (s[1:] if math.dist(out[-1], s[0]) < 1e-6 else s)
    return out


def catmull(pts, n=12):
    """A smooth curve through the points (Catmull-Rom)."""
    P = list(pts)
    P = [(2 * P[0][0] - P[1][0], 2 * P[0][1] - P[1][1])] + P + [(2 * P[-1][0] - P[-2][0], 2 * P[-1][1] - P[-2][1])]
    out = []
    for i in range(1, len(P) - 2):
        p0, p1, p2, p3 = P[i - 1], P[i], P[i + 1], P[i + 2]
        for k in range(n):
            t = k / n
            out.append(tuple(0.5 * (2 * p1[j] + (-p0[j] + p2[j]) * t + (2 * p0[j] - 5 * p1[j] + 4 * p2[j] - p3[j]) * t * t
                                    + (-p0[j] + 3 * p1[j] - 3 * p2[j] + p3[j]) * t ** 3) for j in (0, 1)))
    out.append(P[-2])
    return out


def stroke(pts, w):
    return LineString(pts).buffer(w / 2, cap_style=1, join_style=1, resolution=8)


def taper(pts, w0, w1):
    """A stroke whose width runs from w0 to w1 along it."""
    n = len(pts)
    parts = []
    for i in range(n - 1):
        a = Point(pts[i]).buffer((w0 + (w1 - w0) * i / (n - 1)) / 2, resolution=8)
        b = Point(pts[i + 1]).buffer((w0 + (w1 - w0) * (i + 1) / (n - 1)) / 2, resolution=8)
        parts.append(U(a, b).convex_hull)
    return U(parts)


def star_pts(cx, cy, r_out, r_in, n=5, rot=-90.0):
    """A star's outline; rot is the first tip's direction (-90 = up on the screen)."""
    return [(cx + (r_out if i % 2 == 0 else r_in) * math.cos(math.radians(rot + 180.0 * i / n)),
             cy + (r_out if i % 2 == 0 else r_in) * math.sin(math.radians(rot + 180.0 * i / n))) for i in range(2 * n)]


def rounded(g, r):
    """Round convex and concave corners by r."""
    return g.buffer(r, resolution=8).buffer(-2 * r, resolution=8).buffer(r, resolution=8)


def tf(g, dx=0.0, dy=0.0, s=1.0, rot=0.0, flipy=False):
    """Flip (art/shapes.py draws y up), scale, turn (degrees, clockwise on the screen),
    move."""
    if flipy:
        g = affinity.scale(g, 1, -1, origin=(0, 0))
    if s != 1.0:
        g = affinity.scale(g, s, s, origin=(0, 0))
    if rot:
        g = affinity.rotate(g, rot, origin=(0, 0))
    return affinity.translate(g, dx, dy)


def rrect(x0, y0, x1, y1, r, n=12):
    pts = []
    for cx, cy, a0 in ((x1 - r, y0 + r, -90), (x1 - r, y1 - r, 0), (x0 + r, y1 - r, 90), (x0 + r, y0 + r, 180)):
        for k in range(n + 1):
            a = math.radians(a0 + 90 * k / n)
            pts.append((cx + r * math.cos(a), cy + r * math.sin(a)))
    return pts


def ring_pts(p):
    """A polygon's exterior as points (no closing repeat), rounded to 0.1 um."""
    return [(round(x, 4), round(y, 4)) for x, y in list(p.exterior.coords)[:-1]]


def simple_polys(g, min_area=0.004):
    """Hole-free polygons that together cover g (a KiCad filled shape has no holes): a
    polygon with holes is cut through its first hole, recursively."""
    out = []
    for p in polys(g):
        for q in polys(p.buffer(0)):
            if q.area < min_area:
                continue
            if not q.interiors:
                out.append(q)
                continue
            hx = Polygon(q.interiors[0]).representative_point().x
            x0, y0, x1, y1 = q.bounds
            out += simple_polys(q.intersection(box(x0 - 1, y0 - 1, hx, y1 + 1)), min_area)
            out += simple_polys(q.intersection(box(hx, y0 - 1, x1 + 1, y1 + 1)), min_area)
    return out


def edge_clear(outline_pts, margin):
    """Everything outside the board, grown inward by margin."""
    p = Polygon(outline_pts)
    x0, y0, x1, y1 = p.bounds
    return box(x0 - 20, y0 - 20, x1 + 20, y1 + 20).difference(p.buffer(-margin))


# ======================================================================================
# A board's drawing: items per layer, each clipped against what it must leave clear.
# Things are drawn front to back: whatever stands in front adds itself to the clear area
# (keep_clear), so that what is behind it is hidden.
# ======================================================================================
SILK_EDGE = 0.5          # silk this far inside a board's edge
MASK_GAP = 0.3           # silk, and other openings, this far from a mask opening
PAD_GAP = 0.3            # silk this far from a pad
COURT_GAP = 0.25         # and from a courtyard
MIN_TEXT = 1.0           # mm, JLCPCB's legible minimum is 0.8; the brief asks for 1.0
MIN_STROKE = 0.15


class Canvas:
    def __init__(self, name):
        self.name = name
        self.items = defaultdict(list)       # layer -> API tuples
        self.geoms = defaultdict(list)       # layer -> each item's shapely geometry
        self.clear = {}                      # layer -> what nothing on the layer may cover
        self.notes = []                      # problems the checks found

    def keep_clear(self, layer, g):
        self.clear[layer] = U(self.clear.get(layer), g)

    def line(self, layer, pts, w, clip=True):
        assert w >= MIN_STROKE - 1e-9, "stroke under 0.15 mm"
        ls = LineString(pts)
        c = self.clear.get(layer)
        pieces = lines(ls.difference(c.buffer(w / 2, resolution=8))) if (clip and c is not None and not c.is_empty) else [ls]
        merged = lines(linemerge(pieces)) if len(pieces) > 1 else pieces
        for p in merged:
            if p.length < max(w, 0.25):
                continue
            self.items[layer].append(("polyline", [(round(x, 4), round(y, 4)) for x, y in p.coords], round(w, 3)))
            self.geoms[layer].append(p.buffer(w / 2, resolution=8))

    def circle(self, layer, cx, cy, r, w, clip=True):
        g = circle(cx, cy, r + w / 2).difference(circle(cx, cy, max(r - w / 2, 0.001)))
        c = self.clear.get(layer)
        if clip and c is not None and g.intersects(c):
            self.line(layer, arc_pts(cx, cy, r, 0, 360), w)
            return
        self.items[layer].append(("circle", round(cx, 4), round(cy, 4), round(r, 4), round(w, 3)))
        self.geoms[layer].append(g)

    def arc(self, layer, cx, cy, r, a0, a1, w, clip=True):
        pts = arc_pts(cx, cy, r, a0, a1)
        g = LineString(pts).buffer(w / 2, resolution=8)
        c = self.clear.get(layer)
        if clip and c is not None and g.intersects(c):
            self.line(layer, pts, w)
            return
        self.items[layer].append(("arc", round(cx, 4), round(cy, 4), round(r, 4), round(a0, 3), round(a1, 3), round(w, 3)))
        self.geoms[layer].append(g)

    def poly(self, layer, g, clip=True, min_area=0.02):
        c = self.clear.get(layer)
        if clip and c is not None and not c.is_empty:
            g = g.difference(c)
        for p in simple_polys(g, min_area):
            self.items[layer].append(("poly", ring_pts(p)))
            self.geoms[layer].append(p)

    def outline_strokes(self, layer, g, w):
        """Every ring of a shape, as a stroked line."""
        for p in polys(g):
            for r in [p.exterior] + list(p.interiors):
                self.line(layer, list(r.coords), w)

    def text(self, layer, s, x, y, h, angle=0.0, justify="center"):
        if h < MIN_TEXT - 1e-9:
            raise ValueError("silk text under %.1f mm: %r" % (MIN_TEXT, s))
        mirror = layer.startswith("B.")
        th = text_thickness(h)
        g = text_geom(s, x, y, h, angle, justify, mirror)
        c = self.clear.get(layer)
        if c is not None and g.intersects(c):
            self.notes.append("%s %s: text %r crosses a keep-clear area" % (self.name, layer, s))
        self.items[layer].append(("text", s, round(x, 4), round(y, 4), round(h, 3), round(angle, 3), justify))
        self.geoms[layer].append(g)
        return g


def text_geom(s, x, y, h, angle=0.0, justify="center", mirror=False):
    th = text_thickness(h)
    return U([LineString(sg).buffer(th / 2, resolution=6) if math.dist(*sg) > 1e-6 else Point(sg[0]).buffer(th / 2)
              for sg in text_segments(s, x, y, h, angle, justify, mirror, th)])


# ======================================================================================
# The parts, as gen/placement.py places them: their courtyards and pads (the footprints
# are hardware/lib/OWL.pretty's, named by the schematic's netlist)
# ======================================================================================
LIBDIR = os.path.join(ROOT, "hardware", "lib", "OWL.pretty")
_FP, _NET = {}, None
COIL_FP = {"L3": "Coil_PEND", "L4": "Coil_PEND", "L5": "Coil_PEND", "L6": "Coil_PERCH", "L7": "Coil_PERCH",
           "L201": "Coil_LEV", "L301": "Coil_BAT", "L401": "Coil_TOKEN", "L501": "Coil_TOKEN"}
MISSING = set()


def _sexp():
    sys.path.insert(0, os.path.join(ROOT, "tools"))
    from sexp import parse, kids, kid, val
    return parse, kids, kid, val


def footprint_geometry(name):
    """(courtyard or None, [(pad, through-hole?)]) in the footprint's own frame."""
    if name in _FP:
        return _FP[name]
    parse, kids, kid, val = _sexp()
    doc = parse(open(os.path.join(LIBDIR, name + ".kicad_mod"), encoding="utf-8").read())[0]
    num = lambda node, i: float(node[i][1])
    pts, shapes = [], []
    for node in doc:
        if not isinstance(node, list) or not node or not isinstance(node[0], tuple):
            continue
        h, lay = node[0][1], kid(node, "layer")
        if lay is None or val(lay) != "F.CrtYd":
            continue
        if h in ("fp_line", "fp_rect"):
            s, e = kid(node, "start"), kid(node, "end")
            x0, y0, x1, y1 = num(s, 1), num(s, 2), num(e, 1), num(e, 2)
            pts += [(x0, y0), (x1, y1)] if h == "fp_line" else [(x0, y0), (x1, y0), (x1, y1), (x0, y1)]
        elif h == "fp_circle":
            c, e = kid(node, "center"), kid(node, "end")
            shapes.append(circle(num(c, 1), num(c, 2), math.hypot(num(e, 1) - num(c, 1), num(e, 2) - num(c, 2))))
        elif h == "fp_poly":
            pts += [(num(p, 1), num(p, 2)) for p in kids(kid(node, "pts"), "xy")]
        elif h == "fp_arc":
            a, m, e = [(num(kid(node, k), 1), num(kid(node, k), 2)) for k in ("start", "mid", "end")]
            pts += [a, m, e]
    court = MultiPoint(pts).convex_hull if len(pts) >= 3 else None
    if shapes:
        court = U(court, shapes)
    pads = []
    for node in kids(doc, "pad"):
        at, sz = kid(node, "at"), kid(node, "size")
        x, y = num(at, 1), num(at, 2)
        rot = num(at, 3) if len(at) > 3 else 0.0
        w, hh = num(sz, 1), num(sz, 2)
        shape = val(node, 3)
        if shape == "circle":
            g = circle(x, y, w / 2, 24)
        elif shape == "oval":
            r = min(w, hh) / 2
            g = box(x - w / 2 + r, y - hh / 2 + r, x + w / 2 - r, y + hh / 2 - r).buffer(r, resolution=6)
        else:
            g = box(x - w / 2, y - hh / 2, x + w / 2, y + hh / 2)
        pads.append((affinity.rotate(g, -rot, origin=(x, y)), val(node, 2) in ("thru_hole", "np_thru_hole")))
    _FP[name] = (court, pads)
    return _FP[name]


def footprints_by_ref():
    global _NET
    if _NET is None:
        parse, kids, kid, val = _sexp()
        doc = parse(open(os.path.join(ROOT, "hardware", "checks", "netlist.net"), encoding="utf-8").read())[0]
        _NET = {}
        for c in kids(kid(doc, "components"), "comp"):
            fp = val(kid(c, "footprint"))
            if fp and ":" in fp and not fp.endswith(":"):
                _NET[val(kid(c, "ref"))] = fp.split(":", 1)[1]
    return _NET


def placed(board):
    """[(ref, footprint, courtyard, [(pad, tht)], side)] on a board, in its frame, placed
    the way gen/placement.py says (placement.rel: mirrored in y on the bottom, then turned
    counter-clockwise).  A coil whose netlist entry is older than its generated
    footprint uses the generated one."""
    import placement as PL
    fps = footprints_by_ref()
    out = []
    for ref, (x, y, rot, side) in sorted(PL.BOARDS[board].place.items()):
        name = fps.get(ref)
        if ref in COIL_FP and (not name or not os.path.exists(os.path.join(LIBDIR, name + ".kicad_mod"))):
            name = COIL_FP[ref]
        if not name or not os.path.exists(os.path.join(LIBDIR, name + ".kicad_mod")):
            MISSING.add((board, ref, name))
            continue
        court, pads = footprint_geometry(name)

        def T(g, side=side, rot=rot, x=x, y=y):
            if side == "B":
                g = affinity.scale(g, 1, -1, origin=(0, 0))
            return affinity.translate(affinity.rotate(g, -rot, origin=(0, 0)), x, y)
        out.append((ref, name, T(court) if court is not None else None, [(T(p), th) for p, th in pads], side))
    return out


def keep_parts_clear(cv, board):
    """Silk stays off every courtyard on its side (coils excepted: they take thin lines)
    and off every pad, through-hole pads on both sides.  Returns the parts for the
    previews: {side: [(geometry, colour)]}."""
    seen = {"F": [], "B": []}
    for ref, name, court, pads, side in placed(board):
        coil = name.startswith("Coil_")
        if name.startswith(("MountingHole", "TestPoint")):
            continue
        if court is not None and not coil:
            cv.keep_clear(side + ".SilkS", court.buffer(COURT_GAP))
            seen[side].append((court, "led" if name.startswith("LED") else "part"))
        for pd, th in pads:
            for sd in (("F", "B") if th else (side,)):
                cv.keep_clear(sd + ".SilkS", pd.buffer(PAD_GAP))
                if th or not coil:
                    seen[sd].append((pd, "pad"))
    return seen


# ======================================================================================
# Little drawings shared by the boards (board millimetres, y down)
# ======================================================================================
TOP, BOT = "F.SilkS", "B.SilkS"
STAR_CLEAR = 3.1         # the violet 3528 star LEDs: "a clear centre, radius about 3 mm"
SMALL_LED_CLEAR = 1.75   # 0603 ring, wisp and eye LEDs
PUMPKIN_CLEAR = 4.2      # the 5050 behind each pumpkin's face
FOOT_CLEAR = 5.5         # the printed foot's top is 11 mm across (print/README.md)


def _shapes():
    sys.path.insert(0, os.path.join(ROOT, "art"))
    import shapes
    return shapes


def tiny_star(x, y, r, rot=-90.0):
    return Polygon(star_pts(x, y, r, r * 0.45, 5, rot))


def tiny_twinkle(x, y, r):
    pts = []
    for i in range(8):
        a = math.radians(45 * i - 90)
        rr = r if i % 2 == 0 else r * 0.28
        pts.append((x + rr * math.cos(a), y + rr * math.sin(a)))
    return Polygon(pts)


def crescent(x, y, r, a=-35.0):
    """A little crescent moon, its horns away from direction a."""
    d = 0.5 * r
    return circle(x, y, r, 40).difference(circle(x + d * math.cos(math.radians(a)), y + d * math.sin(math.radians(a)), 0.85 * r, 40))


def pointy_star(cv, x, y, r_out, r_in=3.45, rot=-90.0, w=0.26, layer=TOP):
    p = Polygon(star_pts(x, y, r_out, r_in, 5, rot)).buffer(0.35, join_style=1).buffer(-0.35, join_style=1)
    cv.line(layer, list(p.exterior.coords), w)


def star_zone(x, y, r_out):
    return Polygon(star_pts(x, y, r_out + 0.6, 3.6, 5, -90)).buffer(0.8)


def arc_star(cv, x, y, tangent):
    """One of the twelve stars on the quantum ghost's arc: a halo and six rays, none along
    the arc, so neighbours 8 mm apart never touch."""
    cv.circle(TOP, x, y, 3.5, 0.22)
    for da, r1 in ((-90, 6.4), (90, 5.6), (-45, 5.2), (-135, 5.2), (45, 4.9), (135, 4.9)):
        a = math.radians(tangent + da)
        cv.line(TOP, [(x + 4.15 * math.cos(a), y + 4.15 * math.sin(a)), (x + r1 * math.cos(a), y + r1 * math.sin(a))], 0.24)


def wisp(cv, x, y, flip=1):
    """A will-o'-the-wisp: a little flame round its LED, its tip flicking over."""
    d, r = flip, 2.35
    P = lambda u, v: (x + d * u, y + v)
    base = [P(r * math.cos(math.radians(a)), r * math.sin(math.radians(a))) for a in range(-15, 196, 7)]  # round the bottom
    up_a = bez(base[-1], P(-r - 0.4, -2.4), P(-1.6, -4.4), P(-0.6, -5.6), 14)                  # the far side up
    tip = bez(P(-0.6, -5.6), P(0.2, -6.7), P(1.8, -7.6), P(3.0, -7.0), 10)                       # over to the tip
    down = bez(P(3.0, -7.0), P(1.6, -6.4), P(1.3, -5.2), P(1.9, -4.0), 10)                        # back under it
    down2 = bez(P(1.9, -4.0), P(2.6, -2.6), P(r + 0.5, -1.4), base[0], 12)                         # and down the near side
    cv.line(TOP, chain(base, up_a, tip, down, down2), 0.22)
    cv.line(TOP, bez(P(-0.3, -2.8), P(-0.6, -3.7), P(-0.2, -4.5), P(0.5, -4.9), 8), 0.2)          # a flicker inside
    cv.poly(TOP, U(circle(*P(4.0, -4.6), 0.3, 12), circle(*P(-3.4, -1.0), 0.24, 12)))


def wisp_zone(x, y):
    return U(circle(x, y, 3.2), circle(x, y - 3.8, 3.6))


def silk_bat(x, y, width, rot=0.0):
    """A small flying bat (art/shapes.py's), white with two little eyes."""
    S = _shapes()
    f = S.bat()
    g = unary_union(f.ink)
    x0, y0, x1, y1 = g.bounds
    s = width / (x1 - x0)
    g = tf(g, x, y, s, rot, flipy=True)
    eyes = U([tf(circle(sx * 0.05, 0.04, 0.045, 24), x, y, s, rot, flipy=True) for sx in (-1, 1)])
    return g.difference(eyes)


def curved_text(cv, layer, s, cx, cy, r, h, a_mid=270.0):
    """Letters round the top of a circle, each upright to it (one text item each)."""
    advs = [text_width(c, h) for c in s]
    a = math.radians(a_mid) - sum(advs) / r / 2
    for c, adv in zip(s, advs):
        am = a + adv / r / 2
        if c != " ":
            cv.text(layer, c, cx + r * math.cos(am), cy + r * math.sin(am), h, 270.0 - math.degrees(am), "center")
        a += adv / r


def owl_round(cv, cx, cy, perched=True, layer=TOP):
    """A round owl whose two eye LEDs sit at (cx -+ spacing/2, cy): little ear tufts, eye
    rings round the LEDs, brows, a beak, folded wings, a speckled chest and feet.
    Returns its silhouette (what it hides of the drawing behind it)."""
    e = L.OWL_EYE_SPACING / 2
    body = ellipse(cx, cy + 4.6, 9.0, 11.6, n=120)
    tufts = [Polygon([(cx - 3.4, cy - 6.4), (cx - 6.4, cy - 9.2), (cx - 7.6, cy - 4.8)]),
             Polygon([(cx + 3.4, cy - 6.4), (cx + 6.4, cy - 9.2), (cx + 7.6, cy - 4.8)])]
    head = rounded(U(body, tufts), 0.5)
    cv.outline_strokes(layer, head, 0.3)
    for sx in (-1, 1):
        ex = cx + sx * e
        cv.circle(layer, ex, cy, 3.15, 0.26)                                          # eye rings
        cv.line(layer, arc_pts(ex, cy, 4.25, 205 if sx < 0 else 245, 295 if sx < 0 else 335, 20), 0.24)   # brows
        cv.line(layer, bez((cx + sx * 7.2, cy + 4.0), (cx + sx * 7.6, cy + 9.4), (cx + sx * 6.6, cy + 12.6),
                           (cx + sx * 3.9, cy + 14.6), 24), 0.26)                    # folded wings
        for k in range(2):
            y0 = cy + 9.4 + 1.6 * k
            cv.line(layer, [(cx + sx * (7.0 - 0.6 * k), y0), (cx + sx * (5.8 - 0.6 * k), y0 + 0.9)], 0.2)
        if perched:
            fx = cx + sx * 2.6
            for dx in (-0.75, 0.0, 0.75):                                            # toes
                cv.line(layer, [(fx + dx * 0.5, cy + 15.7), (fx + dx, cy + 16.9)], 0.24)
    cv.poly(layer, rounded(Polygon([(cx - 1.25, cy + 2.4), (cx + 1.25, cy + 2.4), (cx, cy + 4.6)]), 0.2))   # beak
    for (u, v) in ((-2.6, 7.6), (0.0, 7.6), (2.6, 7.6), (-1.3, 10.2), (1.3, 10.2), (0.0, 12.6)):          # chest
        cv.line(layer, [(cx + u - 0.8, cy + v - 0.5), (cx + u, cy + v + 0.35), (cx + u + 0.8, cy + v - 0.5)], 0.22)
    return U(head, box(cx - 4.3, cy + 15.0, cx + 4.3, cy + 17.3))


def grass(cv, layer, x, y, scale=1.0):
    for dx, hh, lean in ((-0.7, 1.4, -0.7), (0.0, 2.0, 0.2), (0.6, 1.6, 0.8)):
        dx, hh, lean = dx * scale, hh * scale, lean * scale
        cv.line(layer, bez((x + dx, y), (x + dx, y - hh * 0.5), (x + dx + lean * 0.4, y - hh * 0.8),
                           (x + dx + lean, y - hh), 8), 0.18)


# ======================================================================================
# The base: the moon (the theremin's pitch antenna) with the witch, and the ghost (its
# volume antenna), in ENIG gold
# ======================================================================================
def witch_silhouette():
    """The witch on her broom with her cat (art/shapes.py's drawing, its cat larger and its
    eyes, her eye and her smile big enough to print as gold).  Art units, y up, 1 = the
    broom.  Returns (silhouette, gold details inside it)."""
    S = _shapes()
    broom = S.stroke([(-0.42, -0.03), (0.52, 0.05)], 0.024)
    bristles = S.path([((-0.42, -0.01), (-0.52, 0.05), (-0.64, 0.07), (-0.74, 0.10)),
                       ((-0.74, 0.10), (-0.70, 0.01), (-0.70, -0.08), (-0.76, -0.14)),
                       ((-0.76, -0.14), (-0.64, -0.11), (-0.52, -0.08), (-0.42, -0.05))])
    ties = S.stroke([(-0.44, 0.02), (-0.44, -0.07)], 0.024)
    head = S.circle(0.10, 0.285, 0.075)
    pigtails = [S.ellipse(0.02, 0.27, 0.037, 0.024, -25), S.ellipse(0.035, 0.222, 0.032, 0.022, -50)]
    brim = S.ellipse(0.095, 0.348, 0.158, 0.028, 8)
    cone = S.path([((0.00, 0.35), (0.02, 0.43), (0.05, 0.52), (0.04, 0.60)),
                   ((0.04, 0.60), (0.10, 0.55), (0.15, 0.45), (0.18, 0.36)),
                   ((0.18, 0.36), (0.12, 0.36), (0.06, 0.35), (0.00, 0.35))])
    tip = S.stroke(S.bezier((0.04, 0.60), (0.00, 0.66), (-0.07, 0.64), (-0.08, 0.57)), 0.03)
    dress = S.path([((0.06, 0.22), (0.02, 0.14), (0.00, 0.07), (-0.02, 0.02)),
                    ((-0.02, 0.02), (0.06, 0.05), (0.14, 0.06), (0.20, 0.04)),
                    ((0.20, 0.04), (0.18, 0.11), (0.16, 0.17), (0.14, 0.22))])
    cape = S.path([((0.06, 0.22), (-0.04, 0.24), (-0.14, 0.20), (-0.22, 0.14)),
                   ((-0.22, 0.14), (-0.16, 0.13), (-0.12, 0.11), (-0.16, 0.07)),
                   ((-0.16, 0.07), (-0.08, 0.10), (0.00, 0.12), (0.05, 0.14))])
    arm = S.stroke([(0.12, 0.19), (0.21, 0.12), (0.29, 0.065)], 0.034)
    legs = [S.stroke([(0.13, 0.04), (0.16, -0.07), (0.215, -0.075)], 0.036),
            S.stroke([(0.05, 0.03), (0.07, -0.08), (0.12, -0.085)], 0.036)]
    kitty = S.place(S.cat(), -0.29, -0.012, 0.25)
    sil = unary_union([broom, bristles, ties, head, brim, cone, tip, dress, cape, arm] + pigtails + legs + kitty.ink)
    gold = [S.circle(0.137, 0.292, 0.016),                                        # her eye
            S.stroke(S.arc_pts(0.121, 0.272, 0.029, 235, 322, 10), 0.014)]       # her smile
    for sx in (-1, 1):                                                             # the cat's eyes
        gold.append(S.circle(-0.29 + sx * 0.075 * 0.25, -0.012 + 0.71 * 0.25, 0.0105))
    return sil, unary_union(gold)


def oscillator_at(ref, fallback):
    """Where a theremin oscillator sits (gen/placement.py), so the antenna's pad faces it."""
    try:
        import placement as PL
        x, y, _, _ = PL.BASE.place[ref]
        return (x, y)
    except Exception:
        return fallback
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
