gallicchio/OWLternatingCurrent/(commit log)

2026-10-07 Ideas, physics and the plan for a cute, physics-y Halloween board
    Response 1 and Prompt 2: 41 ideas with difficulty, cost and first-try odds;
    magnetostatics and circuit simulations (wireless familiars, pendulum kicks,
    zero-power levitation in closed loop); a JLCPCB parts survey; web research
    on fab options, names and child safety; the character art; the plan.
    Claude-Session: https://claude.ai/code/session_01Sh9aLh6t6RymoZFpvwCxwG
    [dn007_measured_s11_digitized.csv, validation.csv]
2026-10-07 Rev A design v2: OWLternating Current, one magnet size, a plug-together PCB tree
    Prompt 2: C1 + C2 + C3 + B5 (theremin, with a sound switch), film mode, and the
    fewest steps for Jason after the JLCPCB order. The bias magnet is the bat's
    own 10 x 2 mm disc, 14 mm above the perch (the owl figure holds it); the bat's
    eyes are lit by a 90 kHz carrier in the levitation coil; the familiar tokens
    lie flat on 5 V gate-driver perches.
    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
2026-10-07 Antenna study complete: a ghost-shaped 2.4 GHz monopole needs no matching parts
    58 openEMS cases, validated against an independent MoM solve (0.2 %) and TI's
    measured DN007 (1.8 %). The ghost (17 x 20 mm, fed through its tail) is
    -19.5 dB worst across 2.400-2.484 GHz and 98 % efficient; a tail-fed bat needs
    two parts. WiFi stays in rev B. Also gen/mech.py: the mechanical numbers the
    boards and the 3D prints share.
    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
2026-10-07 Pin map (gen/pins.py) and shared mechanical numbers (gen/mech.py)
    Every GPIO of the RP2354A assigned within its 8 PWM slices; I2C addresses read
    from the datasheets (the TMAG5273A2 is 0x35, not 0x22); the owl clips onto
    notches in the perch's side edges, leaving the front free for the pendulum's
    thread.
    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
2026-10-07 LED inventory (gen/leds.py): 49 LEDs on two LP5036s, banks aligned to features
    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
2026-10-07 Parts table, footprint sources, and drawn footprints
    72 parts: KiCad stock footprints where they fit, Raspberry Pi's for the RP2350
    core, and four drawn from their makers' drawings (DRV8874 PowerPAD to TI's
    PWP0016J, the DC-005 jack, the side-view LED, the speaker). The eFuse gave way
    to a P-MOSFET, zener and resettable fuse (its 2 x 2 mm hybrid QFN has no stock
    footprint). Coils are copper: KiCad's net tie joins each spiral to its driver.
    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
    [footprints.py, parts.py]
2026-10-07 Library: 51 symbols (custom ones from the datasheets' pin tables), 44 footprints
    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
    [L_Abracon_AOTA-B201610.step, QFN-60-1EP_7x7mm_P0.4mm.step, USB_C_Receptacle_HRO_TYPE-C-31-M-12.step]
2026-10-07 Library: deterministic footprint UUIDs; 22 nF charge-pump cap, antenna pad; sheet helpers, pin probe
    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
2026-10-07 Firmware v0.1, part 1: the light show, host-tested
    The LED engine (CIE L*, a slew limit no LED can beat: 0 to full no faster
    than 300 ms, the LP5036 bank-brightness x colour split, temporal dithering
    with no pattern slower than ~30 Hz), the scenes (asleep, dusk, night,
    firefly synchrony, the quantum ghost, familiar rings, dawn, theremin) and
    the Crank-Nicolson quantum ghost. board_pins.h and led_map.h are written
    by gen/firmware_pins.py and gen/firmware_leds.py from gen/pins.py and
    gen/leds.py. make -C firmware/test: test_leds proves the per-frame limit
    on every scene under random events; test_quantum checks the norm and the
    tunnelling.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
2026-10-07 Firmware v0.1, part 2: the whole firmware builds; every host test passes
    Core 1 (rt.c): a 10 kHz tick phase-locked to the levitation coil's PWM; a DMA'd
    ADC burst (Hall, levitation IPROPI, the 74HC4051's channel, 8x each); the rails,
    nFAULT, brown-out, overcurrent and open-coil checks; coil requests with deadlines;
    the levitation loop; the coils' thermal models. Core 0 (main.c): the safe pin
    state first, USB (CDC console + picotool reset interface), the I2C slot scheduler
    (LED frames at 200/s on both LP5036s, the TMAG5273 at 400 Hz, IMU, light sensor),
    the familiars, the pendulum, film mode, the theremin (PIO edge counting) and its
    voice (PWM + DMA), the JSON console, flash settings, the wa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
    [audio.c, audio.h, board.c, board.h, coils.c, coils.h, config.h]
2026-10-07 Firmware v0.1, part 3: core 1 host-tested, review fixes, README
    test_rt runs core 1 (rt.c, coils.c, board.c) with the SDK modelled in
    test/stubs/: the safe pin state, the PWM's meaning against the DRV8874's
    truth table, no coil without 12 V, request deadlines, owner limits,
    brown-out (off in 0.4 ms), nFAULT (off in 1 ms, retry, latch, clear),
    shorted and open coils, ten minutes of 1 A held under 45 C by the thermal
    derating, and the levitation CAL through the glue. It caught the perch
    legs overlapping by one count at duty 0.5 and perch pins left on the PWM
    when off; both fixed.
    Review fixes: 4 kB stacks for both cores (3 kB JSON buffers moved off the
    stack); the 90 kHz carrier yields to th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
    [board.c, board.h, board_pins.h, coils.c, config.h, firmware_pins.py]
2026-10-07 3D prints, first cut: owl, bat cap, four feet on one plate, one pause
    print/build.py generates everything from gen/mech.py: OpenSCAD parts
    (owlternating.scad, numbers in out/params.scad), the print-ready STLs,
    a 6-object plate.3mf, renders, and runs check.py, which re-measures the
    meshes (ray casts, per-layer slices) against mech.py: magnet bottom
    14.05 mm above the perch's top copper, both pockets closing on layer 96
    so one pause (before layer 97, 19.40 mm) takes both magnets, hooks
    reaching OWL_HOOK/CAP_HOOK under the boards, snap strains 1.0-1.6 %.
    The owl and the cap print upright on breakaway stand-ins (the boards'
    places), the cap on a pedestal that lines its pocket up with the owl's.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
    [bat_cap.stl, foot.stl, owl.stl, owlternating.scad, params.scad, plate.3mf, plate.stl, shapes.scad]
2026-10-07 Base board schematic (A1): power, RP2354A, LEDs, sensors, coil bridges, perch bridges, mux, theremin, audio, tree socket
    ERC clean; every GPIO, mux channel and socket pin checked against gen/pins.py.
    Changes on the way: 4.8 V buck (keeps the NS4150B under its 5.25 V maximum),
    XC6206 LDO (ceramic-stable) fed by a USB/4.8 V OR (VSYS), one UCC27524 per
    perch bridge with a DC-blocking capacitor, 4.7k enable pull-downs that beat
    the drivers' internal pull-ups, mux channels reordered so no lines cross.
    kisch: KiCad rotates before mirroring (fixed); sideways power flags keep
    horizontal names.
    Claude-Session: https://claude.ai/code/session_01S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
    [OWLternatingCurrent.kicad_sch, base.kicad_sch]
2026-10-07 Schematics for every board: tree, perch, bat, owl and cat tokens; x20.6 perch-current amplifiers
    Six sheets, ERC clean; tools/net_check.py checks 200 pins against the design's
    tables (GPIOs, mux, both board-to-board joints, every LED channel, I2C straps).
    gen/connectors.py: the two joints' pinouts (same header and socket parts).
    Perch current sense: OPA2333 x20.6 after the 1 ms filter, 10.3 V/A, so the
    firmware's low-duty token sweep can see 0.2 mA (asked for by the firmware).
    Tree LED driver at 0x32; perch downlights on its last outputs (OUT33/34).
    Bat coil as built (10 turns, r 7-11 mm, 36 uH) with 100 nF: 84 kHz, eyes
    4-7 mA at 0.4-0.5 A of carrier (sim re-run).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
    [OWLternatingCurrent.kicad_sch, base.kicad_sch, bat.kicad_sch, cat_token.kicad_sch, owl_token.kicad_sch, perch.kicad_sch, tree.kicad_sch]
2026-10-07 Floor plan (gen/layout.py): base 190 x 130, scene on top, electronics underneath; panel layout
    The levitation coil moves to three layers (14 turns each, 0.5 mm): its Hall sensor
    sits in the hole at the centre and its lines need B.Cu to get out.
    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
2026-10-07 3D prints: Bambu project with the pause preset, slicer-verified; README
    out/plate_bambu.3mf is a Bambu Studio project carrying the plate and a
    custom G-code before layer 97 (lift the nozzle 15 mm, M400 U1), so the
    owner opens it, picks a printer and prints. slicer_check.py slices it
    with a real Bambu Studio (2.8.2: X1C, P1S, A1, A1 mini): 165 layers,
    32-37 min, 12.9 g, the pause before layer 97 every time, only the
    expected "floating cantilever" notes (the parts' undersides on their
    breakaway stand-ins), bridges where designed. plate.3mf stays a plain
    3MF for other slicers, now placed mid-bed. The cap's drops get wider
    feet on the pedestal. Pictures: cut-away levitation stack with both
    m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
    [bat_cap.stl, bat_cap_in_bat_frame.stl, foot.stl, owl.stl, owl_in_perch_frame.stl, owlternating.scad, params.scad, plate.3mf]
2026-10-07 Name the theremin antennas' nets MOON and GHOST (the board's copper shapes join them)
    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
    [base.kicad_sch]
2026-10-07 3D prints: deterministic builds, tape and pause advice, designer notes
    Triangles are written in a canonical order and the 3MF zips carry a
    fixed date, so rebuilding from the same gen/mech.py gives byte-identical
    outputs. README: narrow tape strips over the magnets on hardened-steel
    nozzles (a full square would weaken the cap's roof bond), the manual
    Bambu pause as a custom G-code that lifts the nozzle first, a note on
    pinning the cap sideways with notches in the bat's edges. Re-verified
    with Bambu Studio 2.8.2: pause before layer 97 on X1C, P1S, A1, A1 mini.
    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
    [bat_cap.stl, bat_cap_in_bat_frame.stl, foot.stl, owl.stl, owl_in_perch_frame.stl, plate.3mf, plate.stl, plate_bambu.3mf]
2026-10-07 Bat cap notches: the head and tail edges get 5.4 x 0.5 mm notches the cap's drops sit in (pins it sideways); prints rebuilt, 74 checks pass
    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
    [bat_cap.stl, bat_cap_in_bat_frame.stl, params.scad, plate.3mf, plate.stl, plate_bambu.3mf, shapes.scad]
2026-10-07 Firmware v0.1, part 4: the board as drawn (A1, f68cf45); familiars from supply current
    Follows the schematic: board_pins.h and led_map.h regenerated (the tree's
    LP5036 at 0x32, the downlights on OUT33/34, the multiplexer's order);
    config.h takes the designer's values: FAMn_ISENSE 10.3 V/A (the x20.6
    amplifier asked for after test_familiar showed 0.5 V/A could not see a
    token through the ADC), the 4.8 V perch rail, pendulum coils 18 mm from
    the rest point (a real capture; 25 mm was not), R_IPROPI and ITRIP
    confirmed. The levitation tables now come from the coil as built
    (gen/parts.py COIL_LEV: 11 turns, r 4-15 mm; 20.4 mN/A, 3.11 mT/A at the
    sensor); the bat's carrier runs at 80 kHz, 8 PWM p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
2026-10-07 Placement table for all six boards (by part role), foot holes, roles.json from the schematic
    The RP2354A's corner is GPiBridge's layout turned 90 degrees, on top behind the tree;
    the scene on top per gen/layout.py; every other block underneath beside what it drives.
    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
    [base.kicad_sch]
2026-10-07 Board, first cut: all 265 parts placed on six boards, no courtyard or clearance errors
    gen/board.py builds the panel in KiCad's Python (placeholder outlines until the art
    lands); the RP2354A's corner uses GPiBridge's 0402 parts where GPiBridge put them,
    turned to face the USB-C. gen/router.py and gen/routing.py are GPiBridge's grid router,
    ported: one router per board, In2 ground, In1 the 4.8 V plane.
    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
    [OWLternatingCurrent.kicad_pcb, base.kicad_sch, cat_token.kicad_sch, owl_token.kicad_sch, tree.kicad_sch]
2026-10-07 Release tooling: mfg/make_release.py and build.py; the BOM half of the release
    mfg/make_release.py makes the whole JLCPCB upload for the panel, assembled on both
    sides: gerbers and drill (zipped), BOM_JLCPCB.csv, CPL_JLCPCB.csv (JLCPCB's
    bottom-side mirror, per-part corrections read or predicted from JLCPCB's own
    drawings, datum shifts), PLACEMENT_CHECKS.txt, FOOTPRINT_CHECK.txt, COST_ESTIMATE.md
    (Standard PCBA fees of 2026-09-09) and ORDER_SETTINGS.md. It stops, leaving
    mfg/release/ as it was, on any gate: codes against gen/parts.py's match words, the
    value, package and MPN; stock for the order; filled zones; DRC; a HOLE in
    FOOTPRINT_CHECK; KiCad's own position export; JLCPCB's drawings, p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
    [BOM_JLCPCB.csv, excluded_from_assembly.csv, hand_solder_bom.csv]
2026-10-07 footprint_check.py: outlines drawn as Bezier curves count toward the panel's extent
    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
2026-10-07 Coils as footprints (gen/coils.py): each spiral is the footprint's own copper, a net tie
    One footprint per coil type in gen/parts.py COILS (OWL:Coil_PEND, Coil_LEV, Coil_PERCH,
    Coil_TOKEN, Coil_BAT), written by gen/library.py like the drawn footprints. The layers
    are in series and all turn clockwise seen from the top: F.Cu outer -> inner, In1.Cu
    inner -> outer, In2.Cu outer -> inner, B.Cu inner -> outer; pads 1 and 2 (0.9/0.4 mm,
    plated) sit side by side at +y, 0.75 mm outside r_out; the layer changes are pads 3-5
    (1.1/0.3 mm, no net) in the net-tie group. COIL_LEV has three layers and a straight
    B.Cu exit beside a 3 mm corridor along +y for its Hall sensor's lines.
    r_out and r_in are now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
2026-10-07 Fix the pumpkin LEDs' polarity, widen the slide switch's post holes, use the coil footprints
    - LED_3die: pins 1-3 are the HL-AF-5060S22OC's anodes and 4-6 its cathodes (datasheet
    p. 2 and JLCPCB's drawing); the symbol had them the other way, so the pumpkins would
    never have lit.
    - MSK12C02: one 1.3 mm hole per locating post, centred between Shou Han's land pattern
    and JLCPCB's drawing of C431540 (0.30 mm apart), so either post fits.
    - Coils: the schematics place gen/coils.py's footprints; parts.py supplies their values
    (33, 30, 30, 12.5, 37 uH); the notes give the tanks as drawn (owl 142 kHz, cat 303 kHz,
    bat 82 kHz); coil symbols are out of the BOM, as their footprints are.
    Co-Au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
    [OWLternatingCurrent.kicad_sch, base.kicad_sch, bat.kicad_sch, cat_token.kicad_sch, owl_token.kicad_sch, perch.kicad_sch]
2026-10-07 Art for every board (gen/art.py): outlines, scene, spell book, antennas, previews
    python3 gen/art.py draws every board on the panel as plain geometry and writes
    hardware/art.json for gen/board.py (KiCad's Python has no shapely), with
    previews in docs/images/art_<board>_<top|bottom>.png.
    - Base, top: the gold moon (pitch antenna) with the witch and her cat as a
    mask silhouette and soft craters; the waving gold ghost (volume antenna)
    with mask eyes and smile; halo stars on the quantum ghost's arc, pointy
    stars round the four others; magic circles labelled OWL and CAT round the
    perches; jack-o'-lanterns round the 5050s; flame wisps over a grassy hill;
    the pendulum's dashed orbit; the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
2026-10-07 Late pin assignment: GPIOs, LED channels and mux inputs bound from the board
    gen/assign.py binds each chip's interchangeable pins where the line from the chip meets
    the line coming to it (river routing): a multi-source search outward from a ring round
    the chip, over the board's big obstacles, finds where each destination's line arrives
    (the angle of the first point on its path that sees the chip), and the pins are matched
    to those arrivals in order. Results in gen/assignment.json; pins.py and leds.py keep
    their hand-written tables as DEFAULT and apply it, and the schematic, board_pins.h,
    led_map.h and the SDK board header follow.
    - LP5036s and the 74HC4051: a minimum-cost matching on the r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
    [base.kicad_sch, tree.kicad_sch]
2026-10-07 Panel inside 250 x 250 mm, art on the boards, routing stage, silkscreen pass; firmware constants from the board
    - Panel 245.2 x 223.2 mm (JLCPCB's limit for an assembled panel): the tokens beside the
    base, the tree turned 90 degrees under it with the perch and the bat. gen/panel.py finds
    the tabs (straight edges across narrow gaps, never at a connector's mouth, a lever,
    header pins or a notch), cuts the slots as the frame's inside less boards and tabs, and
    adds mouse bites, three fiducials and four tooling holes as board-only footprints. The
    tree is built unturned and turned whole at the end (gen/board.py turn()).
    - gen/board.py draws gen/art.py's silkscreen, mask and antenna gol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
    [base.kicad_sch]
2026-10-08 Routing: planned fan-outs, rip-up and reroute, late-assigned rivers in travel order
    - routes.fan(): each fine-pitch signal pin a stub and a straight line to a via
    of its own, per side from the middle outward, no line steeper than 35 degrees;
    the RP2354A (33 signals) and LP5036 (40 channels) on the base, the LP5036 on
    the tree. The RP2354A's crystal, USB and debug nets are routed before it.
    - routing: rip-up and reroute (routes.repair): the nets that bound a walled-in
    search's pocket come out, the walled-in net goes first, then they; kept only
    if fewer nets end in pieces, else the old copper goes back exactly.
    - router: flat arrays, a cheaper layer behind the tree, the walled-in re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
2026-10-08 Fan-outs from exact geometry; a grid bug that let planned lines overlap
    - router._disc: a query of radius 0 (a line's centre, as the fan-out and
    fatten() asked) returned only grid nodes it landed on exactly, so diagonal
    lines were hardly checked: fan lines overlapped and widened lines shorted
    (DRC: 53 shorts). Now never less than the grid's half-diagonal.
    - routes.fan(): per side, patterns of vias evenly spaced in one row or two
    staggered rows, a straight run out of the pins first (between capacitors),
    shifted or anchored at either end; the pattern's own clearances exact, and
    against the copper already there exact too (local_copper, _clear_of); the
    pattern serving most pins is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
    [board.py, library.py, panel.py, placement.py, router.py, routes.py, routing.py]
2026-10-08 Board routed and DRC clean: every net on all six boards, 0 violations
    - Placement the fan-out's reports asked for: pin 23's capacitor 1 mm along
    (its bottom-layer 1.1 V line ran under the east fan), the LED drivers' 0603
    capacitors and VCAP/IREF parts 3 mm apart at the ends of their pin row, C21
    out of C24's courtyard, D2 clear of Q1's silkscreen, tile 3's filter
    capacitor clear of coil L5's terminal tab.
    - XOUT planned round the crystal's near side; coil stubs shorten where a part
    stands in the way; exposed-pad ties 0.2 mm; the levitation coil's bottom
    keep-out taken in by the routed lines' half width.
    - board.prune: vias that join copper on one layer only and stubs with a free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
    [OWLternatingCurrent.kicad_pcb]
2026-10-08 Release written (DRAFT until her name is set); plan, order list and log brought up to date
    mfg/release/: gerbers, BOM (67 lines), CPL (244 placements a panel), assembly
    drawings, placement and footprint checks, order settings, cost estimate
    ($348.37 for 5 panels with 2 assembled, before ~$122 duty). It says DRAFT
    until gen/board_info.py FOR_NAME is set.
    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
    [BOM_JLCPCB.csv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]
2026-10-08 Firmware's LED map from the placed board: every LED's position (was 0, 0)
    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
2026-10-08 No name on the board (open source): "for a young owl"; reviewers' instructions
    - gen/board_info.py FOR_NAME: "" means no name, by choice; the back of the
    base and of the tree read "for a young owl", and the release is no longer
    a DRAFT (None still means undecided). The dedication reads "Made with
    Claude, Halloween 2026".
    - DESIGN_REVIEW.md section 0, for the three LLM reviewers: work only in
    review_LLM_<name>_<version>/, change no file outside it and nothing in git,
    run the project only in a copy inside it (rsync recipe, tested), and leave a
    stand-alone REPORT.md (verdict, findings by severity with evidence, answers
    to section 10, what was checked, what could not be, publishin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
    [OWLternatingCurrent-B_Cu.gbr, OWLternatingCurrent-B_Mask.gbr, OWLternatingCurrent-B_Paste.gbr, OWLternatingCurrent-B_Silkscreen.gbr, OWLternatingCurrent-Edge_Cuts.gbr, OWLternatingCurrent-F_Cu.gbr, OWLternatingCurrent-F_Mask.gbr, OWLternatingCurrent-F_Paste.gbr]
2026-10-08 The repository's address on the silkscreen: larger on the base, and on the tree
    github.com/gallicchio/OWLternatingCurrent (gen/board_info.py URL): the base's
    footer at 1.3 mm (was 1.0), and a line of its own on the tree's back under
    "for a young owl". Board rebuilt, DRC 0; release rewritten.
    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
    [OWLternatingCurrent-B_Cu.gbr, OWLternatingCurrent-B_Mask.gbr, OWLternatingCurrent-B_Paste.gbr, OWLternatingCurrent-B_Silkscreen.gbr, OWLternatingCurrent-Edge_Cuts.gbr, OWLternatingCurrent-F_Cu.gbr, OWLternatingCurrent-F_Mask.gbr, OWLternatingCurrent-F_Paste.gbr]
2026-10-08 3D pictures for the README, made by the build; a README for the public repository
    - tools/render_3d.py (build step "images"): each board cut out of the panel
    into a file of its own (its outline, parts and copper; the tree turned back
    upright) and rendered by KiCad from above, from below and in perspective;
    the panel; and the set assembled on a table in Blender
    (tools/render_set_blender.py: each board's glTF and the printed owl, bat cap
    and feet, placed from gen/layout.py and gen/mech.py). Blender 4.2 or later:
    Ubuntu 22.04's packaged 3.0.1 renders Cycles frames black.
    - build.py: an "art" step before the board (art.json and its previews were
    made by hand) and the "images" step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
    [OWLternatingCurrent-B_Cu.gbr, OWLternatingCurrent-B_Mask.gbr, OWLternatingCurrent-B_Paste.gbr, OWLternatingCurrent-B_Silkscreen.gbr, OWLternatingCurrent-Edge_Cuts.gbr, OWLternatingCurrent-F_Cu.gbr, OWLternatingCurrent-F_Mask.gbr, OWLternatingCurrent-F_Paste.gbr]
2026-10-09 CPL files named for what they are: _cpl_jlcpcb_upload.csv and _cpl_kicad_native.csv
    mfg/release/OWLternatingCurrent_cpl_jlcpcb_upload.csv is the one to upload
    (JLCPCB's rotations and positions); OWLternatingCurrent_cpl_kicad_native.csv
    is KiCad's own, for reference (CLAUDE_PCB.md section 8). Contents unchanged.
    The release asked JLCPCB again (its 24-hour cache had run out): two parts now
    carry minimum orders, the USB lines' 27 ohm resistor (6941 to place 4, $9.02)
    and the 1.1 V regulator's 3.3 uH inductor (32 to place 2, $9.06), so the
    estimate is $366.11 (was $348.37); the order list, README, plan and review
    follow.
    Claude-Session: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
    [OWLternatingCurrent-B_Cu.gbr, OWLternatingCurrent-B_Mask.gbr, OWLternatingCurrent-B_Paste.gbr, OWLternatingCurrent-B_Silkscreen.gbr, OWLternatingCurrent-Edge_Cuts.gbr, OWLternatingCurrent-F_Cu.gbr, OWLternatingCurrent-F_Mask.gbr, OWLternatingCurrent-F_Paste.gbr]
2026-10-09 Review round 1 folded in: five reviews, the fixes they earned, and the release rebuilt
    docs/REVIEW_2026-10-09.md: Claude's own review (written first), then what each of the
    four LLM reviews (review_GPT, review_Gemini, review_Grok, review_KimiK3; untracked)
    found, what was taken and why, and a ranking (Kimi > Gemini > Grok > GPT).
    The design:
    - perch bridges: the UCC27524 stood on a 0.5 ohm shunt and its 4.8 V supply fell
    under its start threshold in the worst corner; 0.1 ohm now, the sense amplifier
    x101, still 10.1 V/A
    - theremin: an ESD diode (ESD9L5.0ST5G, 0.9 pF) at each bare-gold antenna's pad and
    1 k to the gate, on the chip's side away from the shape
    - audio: 220 k inputs, gain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
    [BOM_JLCPCB.csv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]
2026-10-09 The stack-up by the name JLCPCB's page shows: JLC041611-7628 (1 oz inner copper)
    JLC04161H-7628 was the 0.5 oz-inner (H) version of the same 7628 build; with 1 oz
    inner copper chosen the order page lists only the ...11- names, and the one with no
    letter after 7628 is the single-prepreg, 1.065 mm-core build the board's rules and the
    coil physics assume. ORDER_SETTINGS.md explains the naming.
    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
2026-10-09 FABRICATION_NOTES.txt in ECP5-2ADC-2DAC's format; the SW3 datum reading; the BOM renamed
    mfg/release/ORDER_SETTINGS.md becomes FABRICATION_NOTES.txt (make_release.py fab_notes, ported
    from ECP5-2ADC-2DAC's make_fab.py): JLCPCB's order form field by field in the form's own
    order as of 2026-10-09, every line that is not their default marked >>, then the notes for
    the fab and the cost itemised as their cart is. The rows are the 4-layer, Panel-by-Customer
    form, with today's choices: stack-up JLC041611-7628 under Impedance Control, Via Covering
    Plugged (their free upgrade of Tented), min via 0.25mm/(0.35/0.4mm), through-hole on top only.
    The placement preview of 2026-10-09 showed SW3 still a li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
    [OWLternatingCurrent_bom.csv]
2026-10-22 The round-1 reviews kept, and JLCPCB's placement snapshots in mfg/jlcpcb_order/
    reviews/: each reviewer's report, notes, patches and the small scripts and JSON they
    ran (about 0.4 MB), so docs/REVIEW_2026-10-09.md's part B can be checked against what
    they wrote. Not kept: the full copy of the repository each one worked in (project/,
    with its pico-sdk, ~130 MB each), editor settings, and Gemini's DESIGN_REVIEW_Gemini.md,
    a byte-identical copy of its REPORT.md. The review summary's paths now say reviews/.
    mfg/jlcpcb_order/: the top and bottom SMT snapshots JLCPCB's engineers sent with their
    question about the order, kept by their own file names, as CLAUDE_PCB.md asks.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
2026-10-22 JLCPCB's question about C1's polarity, answered and recorded
    JLCPCB's engineers asked on 2026-10-22 whether C1 (470 uF on +12V) was the right way
    round. Their snapshot has its '+' and bevelled corners on the left pad, which is our
    pad 1 (+12V), and Jason told them to proceed. mfg/jlc_rotation.py records the part's
    correction as read rather than predicted, and mfg/jlcpcb_order/README.md keeps the
    question beside their pictures.
    [jlc_rotation.py]
2026-10-22 A no-pause print: the magnets go in afterwards, held by silicone
    print/out/no_pause/ is the same plate printed straight through. The owl's
    pocket opens out of its back as a 10.5 x 2.6 mm slot the magnet slides along
    (a groove up each side wall keys the silicone plug in); the bat cap's pocket
    has no floor, so the bat closes it. Both magnets end up where the pause version
    puts them: 14.05 mm above the perch's top copper, and 2.6 mm above the bat
    against the cap's roof. check.py re-measures both (96 checks pass); the pause
    version's files are unchanged. README: the steps, the polarity, and the
    child-safety trade-off (epoxy instead of silicone for the owl).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
    [bat_cap.stl, owl.stl, owlternating.scad, params.scad, plate.3mf, plate.stl, plate_bambu.3mf]
2026-10-22 No-pause print: two-part epoxy instead of silicone, and what the glue weighs
    Epoxy locks the owl's magnet in for good (silicone barely sticks to PLA). The
    README now says the glue doesn't change the float: about +0.03 g on a 3.7 g
    bat (the cap loses its 0.4 mm floor), and even 0.1 g moves the float point
    only ~0.2 mm, which the zero-power loop absorbs.
    Claude-Session: https://claude.ai/code/session_01HRVM5Fj5FWHyYDd1w15Sef
    [owlternating.scad]
2026-11-06 Print from STLs only: 3DPrinterOS won't take 3MFs, so the no-pause plate leads
    Our 3DPrinterOS account refuses .3mf uploads, so the Bambu projects and
    plain 3MFs are gone (and slicer_check.py and the Bambu settings that only
    served them). check.py now checks plate.stl in both versions. The README
    opens with printing out/no_pause/plate.stl through 3DPrinterOS (supports
    and brim off: its defaults are tree supports and a brim), then stand-ins
    off, magnets in, assembly. The pause version follows, for a slicer you run
    yourself, with an untested plain-G-code route.
    magnets_in.png: "bat" and "perch" are now labelled as the circuit boards,
    and the caption says to lift the cap off its grey pedestal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
    [params.scad, plate.3mf, plate_bambu.3mf]
2026-11-06 Bring-up: BRINGUP.md, the bench scripts, a bring-up firmware image, and the handoff
    The rev A boards arrived (2026-11-05). For the first power-up:
    - BRINGUP.md: the procedure, stage by stage, from unpowered checks through a
    current-limited 12 V ramp, USB and a bring-up image, the LEDs, coils, perches,
    audio, theremin and tanks, the tree and perch, to the real firmware.
    - bringup/: one step per run.py call, through lab-instrument-control's drivers
    (E3646A output 2, SDS2104X Plus, SDG1032X / 33220A / 33120A, Fluke 45). Any
    error, Ctrl-C or kill turns the supply off. expect.py holds every expected number
    and its source. sim.py is a simulated bench with injected faults; test_bringup.p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
    [audio.h, bench.py, bringup_board_sim.c, bringup_board_sim.h, bringup_cmd.c, bringup_cmd.h, bringup_main.c, bringup_sim.c]
2026-11-06 HANDOFF: both plates printed, the no-pause one to use; ignore Unison's temporary files
    Claude-Session: https://claude.ai/code/session_01Uf588J2A4YucCmMmXR75Uc
2026-11-07 Bench day 1 on rev A board 1: results, two script fixes, and REVB.md
    Stages 0-5 and 6.2 of BRINGUP.md ran on bell against board 1. Rails, USB, flash,
    I2C, all 31 LEDs, the pendulum coils and the theremin pass. The speaker is silent
    with the amplifier's enable path working, and both tokens resonate far from design
    on their own perches (owl 208 kHz for 142, cat 145 kHz for 303); both are open.
    - bringup/results/2026-11-06/: every step's record, with the hand-read test-point
    resistances and the two aborted ramps (a probe on TP6 instead of TP3, a hook that
    lost TP2).
    - bringup/steps.py: the ramp's USB warning ignores the Debug Probe (2e8a:000c).
    - bringup/bench.py: the scope's memory depth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
    [bench.py, steps.py]
2026-11-07 Photos of the rev A boards as received from JLCPCB (2026-11-06 morning)
    27 phone photos, 57 MB, in mfg/jlcpcb_order/potos_revA_2026-11-06/. A commit of its
    own so it can be dropped before pushing if the repository should not carry them.
    Claude-Session: https://claude.ai/code/session_01Uf588H76wxqKkk34bVfnvo
2026-11-07 Evening deep dive: the audio works, the tokens are right; the bench and image gain the tests
    Both first readings from the day were wrong. The audio chain is intact: the NS4150B
    wakes with SW3, a full-scale tone adds 26 mA at 12 V (0.2 W into about 7 ohm) and the
    current against frequency shows the voice coil's mechanical resonance at 1.8 kHz; the
    tone that was listened for was 13 mW at 440 Hz, two octaves under this 23 mm speaker.
    The tokens' bumps are the coupled mode at ft / sqrt(1 - k^2): a bare token on its perch
    couples at k about 0.75 (the owl's bump at 214 kHz, the cat's at 452 with a 3rd-harmonic
    image at 150), one coupling explaining both where the wrong-capacitor story needed two.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
    [bringup_board_sim.c, bringup_cmd.c, bringup_cmd.h, bringup_main.c, coils.c, expect.py, run.py, steps.py]
2026-11-07 Bench day 2: the real firmware runs, the tokens light live, the demo fixes
    The real firmware as committed crashed three times in 75 ms on rev A and parked in
    BOOTSEL: the tick's PWM-wrap interrupt and the ADC burst's DMA-done interrupt share the
    top priority, the PWM wins when both pend, and the tick handler then drained a FIFO the
    still free-running ADC kept filling (rt.c tick_isr yields now; test_rt has the case).
    A diagnostic build (cmake -DOWL_DIAG=1: watchdog fed regardless, a diag event a second,
    a hard-fault recorder) found it. Core 1's work still exceeds its 100 us tick (open).
    Familiars: the fit is degenerate on a bare token (one bump fixes only ft/sqrt(1-k^2)),
    so it knows only th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
    [bringup_cmd.c, bringup_cmd.h, config.h, console.c, console.h, duty_scan.py, familiar.c]
2026-11-10 Bench day 3: the levitation coil measured, a 10-minute hover, play mode, the bat's eyes, a lower owl
    Measurements (all in bringup/MEASUREMENTS.md, today's hand ones also in
    bringup/results/2026-11-09/hand_measurements.json):
    - Bat: PCB 3.00 g, magnet (10 x 2 mm N52) 1.23 g, cap + glue + magnet 1.72 g,
    as flown 4.70 g (3.6 g was assumed). Weigh magnets on a non-magnetic stand.
    - Levitation coil 3.24 ohm (Fluke, J201 pins 10-14), not the 2.56 designed; the
    current sense reads 0.79 of the true current; thermal fit 8.0 J/K, 7.5 K/W,
    38 K/W; IR 40-44 C after a 10-minute hover, 67 C under the owl with the eyes on.
    Firmware:
    - The levitation coil's resistance thermometer, with a calibration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
    [bat_cap.stl, bat_cap_in_bat_frame.stl, owl.stl, owl_in_perch_frame.stl, owlternating.scad, params.scad, plate.stl]
2026-11-10 README: bench clips of the rev A boards at the top
    The LED test on the base board and the bat being captured under the owl's
    perch, then hovering, as small GIFs linking to MP4s in docs/video/.
    Quick phone clips, to be replaced.
2026-11-11 Bench day 4: the second owl flies, set-point costs, eyes and rings breathe
    - The 12.45 mm owl: the 4.70 g bat floats at 7.40-7.44 mm with no current, gap sd
    0.015-0.03 mm; 0.36 A per mm below that; the 0.6 A mean trip drops it near 9.5 mm.
    - Eyes at the natural float with the IR camera: visible at 0.05, "dim, but visible"
    at 0.1 for a few kelvin; 0.15 doubles the gap's spread.
    - Tokens: live mode's current does not move with a token; sweep mode sees them
    (owl 147.6 kHz, cat 353.8 kHz) but is slow to see them go.
    - Firmware defaults: the eyes breathe at 0.1 (2 s raised cosine), the token rings
    breathe round once a second, the zero-power walk aims at 0.2 A (new tunable zp_i),
    lev tun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
    [bat_cap.stl, owl.stl, owl_in_perch_frame.stl, params.scad, plate.stl]
2026-11-11 Bench day 5: the coil cal fixed, tokens seen live, the third owl flies
    - lev cal coil: at 0 A the PWM's minimum pulses make a zero-mean ripple that the |I|
    mirror read as ~0.07 A of offset ("IPROPI disagrees"); the cal now coasts the bridge
    in its off windows and measures kcs 3.55-3.57 mT/A.
    - Token presence in live mode: at the token's own tuning the reflected load is resistive
    and the supply current doesn't move; at 1.5x (the coupled mode) it rises 5-10x. Live
    drive now breathes over 3 s with a two-duty probe there in each trough; arrival above
    max(2.5 x learned empty, 3 mA), leaving relative to the token's own level. Every edge
    seen on the bench, nothing false. The rings show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
    [console.c, console.h, fam_scan.py, fam_watch.py, familiar.c, familiar.h, lev_ctrl.c, lev_ctrl.h]
2026-11-11 Bench day 5, later: a spin drops the bat; the coil thermometer never reads in a hover
    - After a 12-minute hover Jason spun the bat slowly: the wobble grew (current at its
    2.6 A limit every second) and the bat fell in about 80 s, the coil's model at 63 C.
    Caught again and left alone: 28 minutes at 8.72 mm, sd 0.085 mm, 164 mA.
    - REVB 1.12 items 7 (the bat's centre of mass; the pendulum coils as a damper) and 8 (the
    thermometer waits for the eyes' carrier to be off and for 0.3 A, neither of which
    happens in a hover).
    - HANDOFF: don't spin the bat in the demo.
    Claude-Session: https://claude.ai/code/session_01Uf588H76wxqKkk34bVfnvo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
2026-11-12 The levitation loop starts at power-up; a tap's wobble; the bat's left eye
    - LEV_ON_AT_BOOT: the board comes up from the 12 V barrel alone with the loop waiting
    for the bat, the zero and kcs from flash (Jason: no USB for the demo).
    - A tap starts the same growing-and-shrinking wobble as a spin (MEASUREMENTS).
    - REVB 1.12: the brighter eye is the bat's left. HANDOFF: how to start the demo.
    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
    [config.h, main.c]
2026-11-12 HANDOFF: the 12 V-only start verified on the bench; the scope wires removed
    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
