gallicchio/OWLternatingCurrent/(notices)

Notices in the files:
gen/art.py:
s stroke font (newstroke, CC0 1.0), read with pcbnew by gen/art.py --extract-font"
